gmaxdragon/Seizo-Mini/motor-controller-r4-1/SUBMISSION_FILES.md

# Files for the Week5 design submission

Use the current Seizo-Mini repository and the R4.1 manual-build files. This note is a file guide, not a claim of program approval or completed physical testing.

1. Project link: https://github.com/gmaxdragon/Seizo-Mini. Current design folder: motor-controller-r4-1. Earlier teaching-arm and R4 files remain preserved.
2. Design files: project/big motor controller.kicad_sch and project/big motor controller.kicad_pcb. Preview images: preview/pcb-routing.png and preview/pcb-3d.png (CAD render with incomplete model coverage, not a physical photograph).
3. Parts: cost/Final_BOM.csv contains every purchased/reused/DNP item; rootBOM.csv / cost/HalfLife_import.csv is the24-line funding importer with numeric prices; cost/LCSC_import.csv is the21-line LCSC importer. cost/Budget.csv separately identifies freight/tax/contingency, so do not import those as electronic components.
4. Cart evidence: cart-proof/LCSC-manual-Nov8.jpg, JLC-bare-Nov8.jpg and West3D-three-drivers-Nov8.jpg. The selected JLC item is five bare PCBs; no factory assembly is included. The budget ignores conditional coupons.
5. Manufacturing: use the matching R4.1 Gerbers/drills. Use BUY_AND_SOLDER_MANUAL.md and ASSEMBLY_AND_FIRST_POWER.md for assembly, and the supplied locked firmware/host references for later commissioning.

Report the scope accurately: designed/reviewed but not physically built/tested; 100USD cap allocation including5USDconditionalfallbackmaterials, actual final landed checkout not verified; exact motor/driver/cooling qualification and live application integration remain. The unchanged existing CNC shield is a separate controller and is not a guaranteed NEMA23 fallback.

Use only genuine personal work/time for the program journal. This update does not add or rewrite journal entries, claim agent time as participant time, change a funding form, or submit the project. Current dashboard-specific theme, hour, eligibility and authorship requirements remain governed by the program; they were not verified by this repository update. The public homepage still lists Week5 breadboard logic, while the user reports an updated freestyle option. No eligibility guarantee is made here.

Current cart images are LCSC-current.jpg,JLC-current.jpg,West3D-current.jpg,Adafruit-current.jpg. LCSC42.07 +JLC14.50 +West18.86 +Adafruit0.95 =76.38USDshown; Adafruitfreight/tax and possiblelatechargesareunknown. ImportthecurrentfundingCSVintotheappbeforeusingitsGitHubsync,otherwiseitcanrestorethediscardedteaching-armBOM.
