gmaxdragon/Seizo-Mini/motor-controller-r4-1/cart-proof/Adafruit-current.jpg

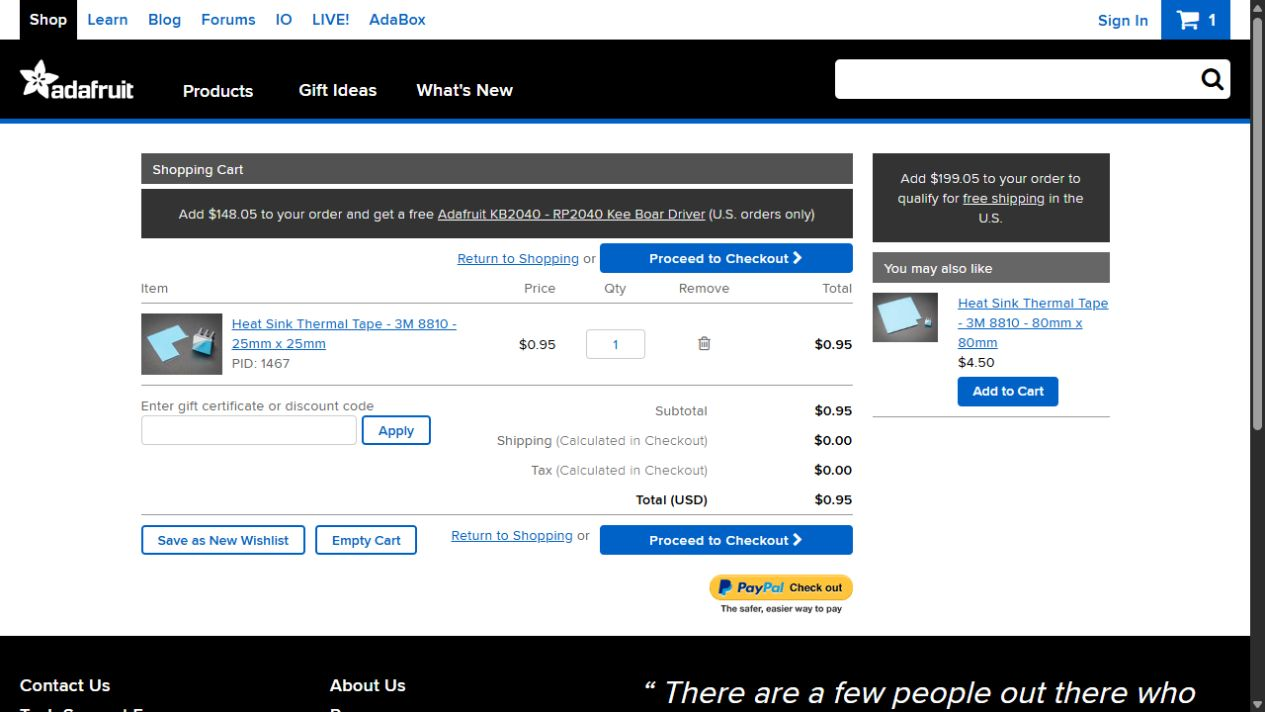
motor-controller-r4-1/cart-proof/Adafruit-current.jpg
