gmaxdragon/Seizo-Mini/motor-controller-r4-1/cart-proof/JLC-bare-Nov8.jpg

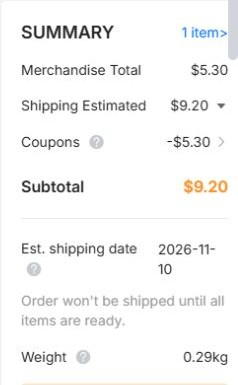
motor-controller-r4-1/cart-proof/JLC-bare-Nov8.jpg
