gmaxdragon/Seizo-Mini/motor-controller-r4-1/cart-proof/JLC-current.jpg

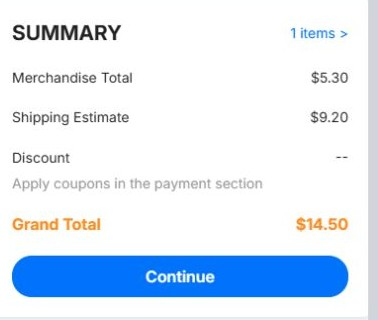
motor-controller-r4-1/cart-proof/JLC-current.jpg
