gmaxdragon/Seizo-Mini/motor-controller-r4-1/cart-proof/LCSC-current.jpg

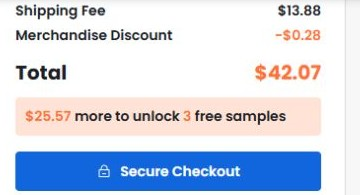
motor-controller-r4-1/cart-proof/LCSC-current.jpg
