gmaxdragon/Seizo-Mini/motor-controller-r4-1/cart-proof/West3D-three-drivers-Nov8.jpg

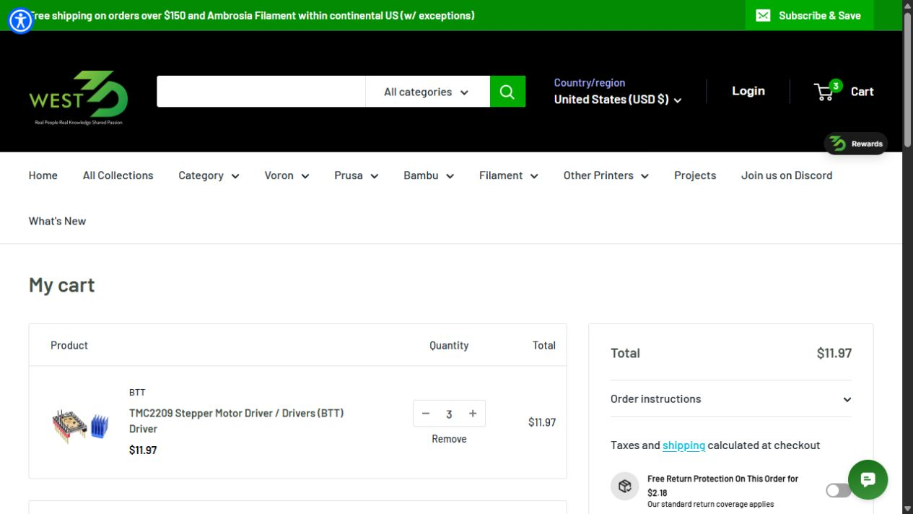
motor-controller-r4-1/cart-proof/West3D-three-drivers-Nov8.jpg
