gmaxdragon/Seizo-Mini/motor-controller-r4/preview/final-board.png

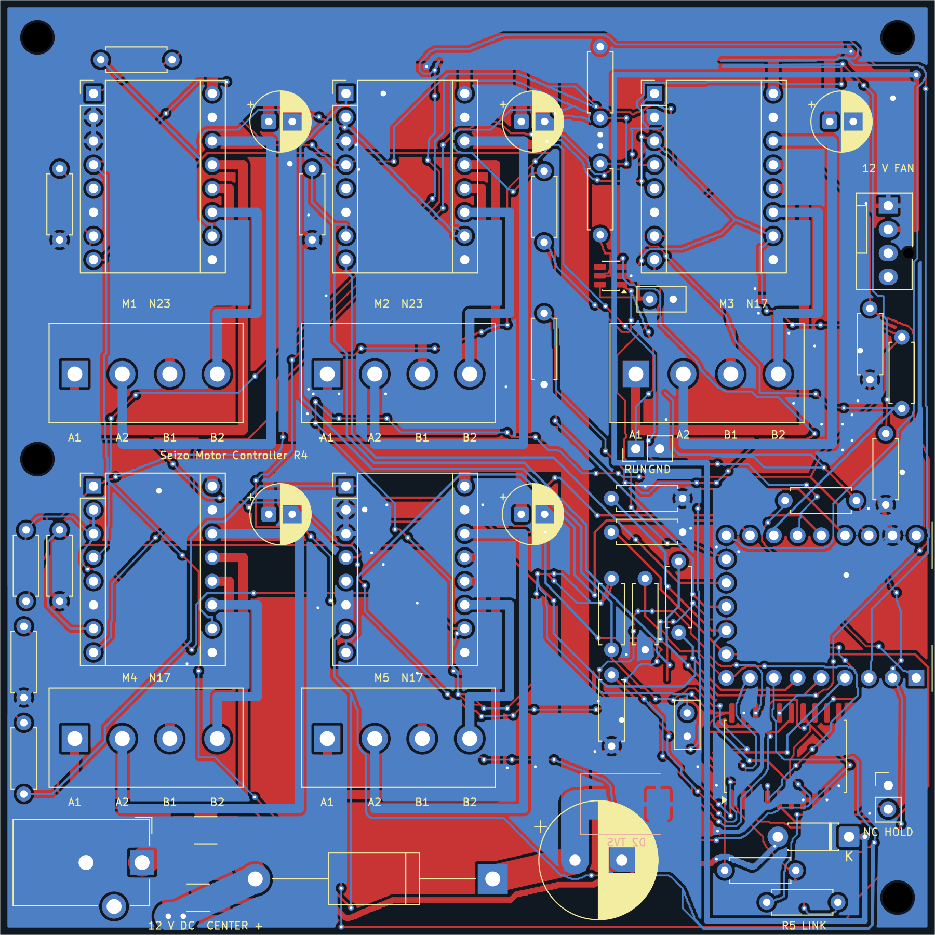
motor-controller-r4/preview/final-board.png
