gmaxdragon/Seizo-Mini/motor-controller-r4-1/cost/factory-alternative/README.md

# Earlier TOP2 factory assembly option

These are superseded costing records for U7/U8-only factory fitting on two carriers. They are not the active manual-build BOM or budget. The earlier $110.21 plan exceeded the target before unquoted imports. Use the parent cost directory for the current manual build. The corrected supplier placement files remain in assembly/quotation-only; their geometry has not been changed.
