gmaxdragon/Seizo-Mini/motor-controller-r4/cost/CHECKOUT_SUMMARY.md

# R4 unpaid website quotes — 2026-11-08

**There is no verified complete, presoldered delivered controller below $100. No order or payment has been made.**

| Supplier / scope | Merchandise | Delivery | Discount | Displayed or planning total | Remaining qualification |
|---|---:|---:|---:|---:|---|
| LCSC, 17 DIY carrier SKUs | $15.59 | $11.85 | $0.24 | **$27.20 checkout** | FCA: duty, customs and tax remain buyer responsibility. Not needed again for parts already supplied by factory assembly. |
| West3D, five plug-in drivers | $19.95 | $6.89 | — | **$26.84 checkout** | Website shows tax $0; exact delivered revision, R110 resistors, five heatsinks and adhesive remain unconfirmed. |
| Waveshare, Zero-M + fan + USB data cable | $8.87 | $10.00 option | — | **$18.87 planning** | Delivery is offered but not selected/final; tax/import fees unbounded. Unrelated $5.49 pre-existing cart item excluded. |
| JLCPCB, five PCBs and two carriers with 56 matched items each | $137.00 | $38.39 cart estimate | $10.00 cart estimate | **$165.39 cart estimate** | Final checkout needs delivery address; coupon, tax and shipping are not final. U6 and R5 are not fitted. |

## What “free assembly” means here

The official offer describes a setup-fee coupon, not free components, manual work, shipping or tax. The actual uploaded R4 double-sided Standard quote is **$10.70 PCB + $126.30 assembly = $137.00 before delivery**. Its assembly charges are setup $51.50, stencil $16.54, components $23.26, feeders $7.75, SMT placement $0.16, hand-solder labor $3.61, manual joints $6.44, fixture $16.54 and packaging $0.50. Account/cart coupons must be checked in final checkout. [Official promotion](https://jlcpcb.com/news/free-assembly-1-6-layer-pcb-discount-8-20-layer-pcba)

The website matched **56 of 58** carrier items to 17 catalogue SKUs. The exact RP2040-Zero-M (U6) and fitted wire link (R5) remain manual/unmatched. Five BTT driver modules are separate plug-in purchases; the ten female sockets are in the factory quote. The reset harness, HOLD loop, fan, heatsinks, USB cable and mounting remain outside fitted scope.

Combining the current factory cart estimate, driver checkout, Waveshare option and $2 heatsink reserve gives **$213.10 before remaining unquoted charges**. This is a planning comparison, not a complete landed quote. It does not also add the LCSC DIY parts basket.

The **DIY** baseline is **$98.84 before unquoted imports** and includes no factory assembly. It uses the earlier bare-board $5.30 + $9.20 freight quote. The full purchase BOM describes that DIY baseline; factory quotation files are separately marked under `assembly/quotation-only`. Do not combine the two purchasing methods or use the bare-board price as a finished-board price.

## Assembly and commissioning status

The digital native, independent copper/geometry and fabrication comparisons pass. U7's five open in-pad vias still need an accepted factory process or a reviewed layout change. The quotation placement file does not certify factory rotation or through-hole insertion alignment. The board has no completed physical power, thermal, motor or fault qualification. It is a prototype, not a production-cleared controller.
