gmaxdragon/Seizo-Mini/motor-controller-r4-1/cost/factory-alternative/QUOTE_RECHECK.md

# Current R4.1 partial-assembly quotation

The current **saved, unpaid R4.1 cart** was checked on November 8, 2026. Only the new R4.1 batch was selected. No personal delivery address was entered or used, no supplier was contacted, and no order, payment or production was authorized.

| Item | USD |
|---|---:|
| Five bare carriers |5.30|
| Economic partial assembly, two boards with U7/U8 only |21.46|
| Merchandise total |26.76|
| Global Standard Direct Line freight |16.03|
| One available conditional coupon |−10.00|
| Current cart subtotal |**32.79**|

The $21.46 assembly charge consists of $8.24 setup, $1.55 stencil, $4.51 components, $6.18 extended-component charges, $0.12 SMT placements and $0.86 nitrogen. The quote matches **U7/C6757** and **U8/C19653**. Its batch contains five PCBs; only two receive these two ICs. It does not include the remaining SMD or through-hole assembly, MCU, socket rows, plug-in drivers, cooling, cable or harness.

The coupon expires November 10, 2026. The cart estimates 0.64 kg and a November 10 ship date; these are website estimates, not delivery guarantees. UPS DDP was an alternative $31.69 freight/$48.45 cart estimate and is **not** the selected baseline. Destination tax/imports, actual coupon availability at payment and final manufacturer CAM/DFM acceptance remain unconfirmed.

The exact corrected CPL SHA256 is `7aaaa30585ed97cb6db1d06aff75d90b855220352bf6094180a1d188fb87ddf9`. Both supplier-library angles are 0°. The quote reviewer re-imported this file from scratch and verified U7's 20 leads/pin 1 bottom-left and U8's 6 leads/pin 1 bottom-right against native pads without further viewer rotations. This validates the saved quotation preview, not physical assembly or factory acceptance.

The complete carrier-component planning total remains **$110.21 before unquoted import or checkout charges**. The $100 cap is not met. Motor purchases and a qualified combined-arm power arrangement are outside this price.
