gmaxdragon/Seizo-Mini/Real_BOM.csv

section | references | quantity_used | purchase_required | purchase_quantity | description | manufacturer | mpn | seller | sku | unit_usd | line_usd | price_status | stock_status | source_url | native_mpns | footprints | notes
Native PCB | U1 U2 U3 | 3 | true | 3 | Three assembled plug-in stepper driver modules | BIGTREETECH | TMC2209 V1.3 | West3D | BTT0529 | 3.99 | 11.97 | Current unpaid checkout:11.97USD merchandise +6.89USD shipping =18.86USD |  | https://west3d.com/products/tmc2209-stepper-motor-driver-drivers-btt | BIGTREETECH TMC2209 V1.3 | SeizoMotorController:StepStick_Socket16_P12.70_D1.00 | Fit three modules for unchanged populated mask7. U1/U2 intended for two suitably rated NEMA23 motors. U3 stays fitted with NO motor for this arm plan. U4/U5 absent. Existing A4988 modules stay on the separate CNC shield for three NEMA17 axes; not pin-compatible substitutes here. Exact delivered revision/R110/shunts and motor-current compatibility require inspection.
Native PCB | U6 | 1 | true | 1 | Genuine bare USB-C RP2040-Zero module; add 23 header pins manually | Waveshare | RP2040-Zero (bare, 20187) | LCSC | C5350143 | 6.01 | 6.01 | Current basket displayed undiscounted line extension; automatic promotion ignored for conservative allocation | Current 21-line unpaid basket: in stock; 2026-11-08 | https://www.lcsc.com/product-detail/C5350143.html | Waveshare RP2040-Zero-M | SeizoMotorController:Waveshare_RP2040_Zero_Headers_9_9_5_P2.54 | Bare module replaces preheadered 20335 Zero-M. Fit 23 straight male pins in 9+9+5 rows, then solder through carrier. Same reviewed Zero signal map. Required J9 RUN/GND service harness remains. Native CAD metadata may still say Zero-M; geometry/electrical map is unchanged.
Native PCB | U7 | 1 | true | 1 | Octal STEP buffer / HOLD output enable, wide SOIC20 | Texas Instruments | SN74HC541DWR | LCSC | C6757 | 1.1224 | 1.12 | Current basket displayed undiscounted line extension; automatic promotion ignored for conservative allocation | Current 21-line unpaid basket: in stock; 2026-11-08 | https://www.lcsc.com/product-detail/C6757.html | SN74HC541DWR | Package_SO:SOIC-20W_7.5x12.8mm_P1.27mm | Fit manually; no factory assembly in this budget. Match pin 1 and inspect every lead for bridges. R4.1 has no in-pad escape vias requiring the old R4 manual via-fill instruction. One purchased chip is fitted, not a loose spare.
Native PCB | U8 | 1 | true | 1 | Motor-rail reset supervisor, SOT23-6 | Texas Instruments | TPS3808G01DBVR | LCSC | C19653 | 0.4628 | 0.46 | Current basket displayed undiscounted line extension; automatic promotion ignored for conservative allocation | Current 21-line unpaid basket: in stock; 2026-11-08 | https://www.lcsc.com/product-detail/C19653.html | TPS3808G01DBVR | Package_TO_SOT_SMD:SOT-23-6 | Fit manually; no factory assembly in this budget. Match pin 1 and inspect every lead for bridges. R4.1 has no in-pad escape vias requiring the old R4 manual via-fill instruction. One purchased chip is fitted, not a loose spare.
Native PCB | R11 R12 R13 R14 R15 R6 R7 R9 R21 R31 R22 R32 R23 R33 R24 R34 R25 R35 | 18 | true | 50 | 10k1%0.25W100ppm axial resistors | YAGEO | MFR-25FBF52-10K | LCSC | C1519255 | 0.0198 | 0.99 | Current basket displayed undiscounted line extension; automatic promotion ignored for conservative allocation | Current 21-line unpaid basket: in stock; 2026-11-08 | https://www.lcsc.com/product-detail/C1519255.html | MFR-25FBF52-10K | Resistor_THT:R_Axial_DIN0207_L6.3mm_D2.5mm_P7.62mm_Horizontal | 18fitted,32spares; includes newR6,R7,R9. Body6.3×2.4mm formed to7.62mmpitch. Cart line_usd is authoritative displayed cents; unit_usd is separately displayed four-decimal precision. Current automatic0.28USD promotion is ignored for conservative allocation.
Native PCB | R2 R3 R4 R8 | 4 | true | 50 | 1k1%0.25W50ppm axial resistors | YAGEO | MFR-25FTE52-1K | LCSC | C172978 | 0.0152 | 0.76 | Current basket displayed undiscounted line extension; automatic promotion ignored for conservative allocation | Current 21-line unpaid basket: in stock; 2026-11-08 | https://www.lcsc.com/product-detail/C172978.html | MFR-25FTE52-1K | Resistor_THT:R_Axial_DIN0207_L6.3mm_D2.5mm_P7.62mm_Horizontal | 4fitted,46spares; includes newR8. Body6.3×2.4mm formed to7.62mmpitch. Cart line_usd is authoritative displayed cents; unit_usd is separately displayed four-decimal precision. Current automatic0.28USD promotion is ignored for conservative allocation.
Native PCB assembly link | R5 | 1 | false | 0 | Fitted wire link from clipped resistor lead | Assembly material | Assembly link - tinned resistor-lead offcut | Already purchased resistor pack | No separate purchase | 0 | 0 | Required assembly link,no separate purchase |  |  | Assembly link - tinned resistor-lead offcut | Resistor_THT:R_Axial_DIN0207_L6.3mm_D2.5mm_P7.62mm_Horizontal | Form acrossR5holes7.62mmpitch with clearance. KeepR4=1k; do not fit1k atR5.
Native PCB | C2 C3 | 2 | true | 5 | 100nF50VX7R10% radial bypass capacitors | Murata | RDER71H104K0S1H03A | LCSC | C524651 | 0.0966 | 0.48 | Current basket displayed undiscounted line extension; automatic promotion ignored for conservative allocation | Current 21-line unpaid basket: in stock; 2026-11-08 | https://www.lcsc.com/product-detail/C524651.html | RDER71H104K0S1H03A | Capacitor_THT:C_Disc_D5.0mm_W2.5mm_P2.50mm | 2fitted,3spares. Includes newC3. Body5×2.5mm/P2.5. Cart line_usd is authoritative displayed cents; unit_usd is separately displayed four-decimal precision. Current automatic0.28USD promotion is ignored for conservative allocation.
Native PCB | C11 C12 C13 C14 C15 | 5 | true | 10 | 100uF35V low-impedance radial capacitors | Rubycon | 35ZLH100MEFC6.3X11 | LCSC | C109392 | 0.0681 | 0.68 | Current basket displayed undiscounted line extension; automatic promotion ignored for conservative allocation | Current 21-line unpaid basket: in stock; 2026-11-08 | https://www.lcsc.com/product-detail/C109392.html | 35ZLH100MEFC6.3X11 | Capacitor_THT:CP_Radial_D6.3mm_P2.50mm | 5fitted,5spares. Body6.3×11mm/P2.5;540mA100kHzripple;6000h105C. Cart line_usd is authoritative displayed cents; unit_usd is separately displayed four-decimal precision. Current automatic0.28USD promotion is ignored for conservative allocation.
Native PCB | C1 | 1 | true | 1 | 470uF50V radial bulk capacitor | Panasonic | EEU-FR1H471 | LCSC | C178708 | 0.8139 | 0.81 | Current basket displayed undiscounted line extension; automatic promotion ignored for conservative allocation | Current 21-line unpaid basket: in stock; 2026-11-08 | https://www.lcsc.com/product-detail/C178708.html | EEU-FR1H471 | Capacitor_THT:CP_Radial_D12.5mm_P5.00mm | 12.5mmdiameter/P5. Cart line_usd is authoritative displayed cents; unit_usd is separately displayed four-decimal precision. Current automatic0.28USD promotion is ignored for conservative allocation.
Native PCB | J1 J2 J3 J4 J5 | 5 | true | 5 | Four-position5.08mm motor screw terminals | DORABO | DB128V-5.08-4P-GN-S | LCSC | C2915641 | 0.4256 | 2.13 | Current basket displayed undiscounted line extension; automatic promotion ignored for conservative allocation | Current 21-line unpaid basket: in stock; 2026-11-08 | https://www.lcsc.com/product-detail/C2915641.html | DB128V-5.08-4P-GN-S | SeizoMotorController:TerminalBlock_DORABO_DB128V_1x04_P5.08mm_D1.60 | Native custom reviewed1.60mmdrill footprint; verify physical fit. Undiscounted quoted2.13USDline used. Cart line_usd is authoritative displayed cents; unit_usd is separately displayed four-decimal precision. Current automatic0.28USD promotion is ignored for conservative allocation.
Native PCB | J6 | 1 | true | 1 | 5A24V barrel jack,2.0mm center pin | Same Sky | PJ-102AH | LCSC | C3096093 | 1.0637 | 1.06 | Current basket displayed undiscounted line extension; automatic promotion ignored for conservative allocation | Current 21-line unpaid basket: in stock; 2026-11-08 | https://www.lcsc.com/product-detail/C3096093.html | PJ-102AH | Connector_BarrelJack:BarrelJack_CUI_PJ-102AH_Horizontal | Mates nominal5.5OD/2.1IDplug; owned adapter plug/polarity must be checked. Cart line_usd is authoritative displayed cents; unit_usd is separately displayed four-decimal precision. Current automatic0.28USD promotion is ignored for conservative allocation.
Native PCB | J7 J9 | 2 | true | 20 | Two-pin2.54mm vertical male headers | Ckmtw | B-2100S02P-A110 | LCSC | C124375 | 0.0281 | 0.56 | Current basket displayed undiscounted line extension; automatic promotion ignored for conservative allocation | Current 21-line unpaid basket: in stock; 2026-11-08 | https://www.lcsc.com/product-detail/C124375.html | B-2100S02P-A110 | Connector_PinHeader_2.54mm:PinHeader_1x02_P2.54mm_Vertical | 2fitted,18spares. J7HOLDdryNCcontact; newJ9requiredRUN/GNDharness. Square0.64mmpins,6mmmating/3mmtail. Cart line_usd is authoritative displayed cents; unit_usd is separately displayed four-decimal precision. Current automatic0.28USD promotion is ignored for conservative allocation.
Unpopulated footprint | J8 | 0 | false | 0 | Keyed four-pin2.54mm PC fan header | Molex | 470531000 | LCSC | C240840 | 0.00 | 0.00 | Current basket displayed undiscounted line extension; automatic promotion ignored for conservative allocation | Current 21-line unpaid basket: in stock; 2026-11-08 | https://www.lcsc.com/product-detail/C240840.html | 470531000 | Connector:FanPinHeader_1x04_P2.54mm_Vertical | Do not buy C240840 for this build. Leave plastic header unpopulated. Solder blower black lead to J8 pad1/GND and red lead to pad2/FAN_VMOT, leaving pads3/4 unused. Retain F2/D3. Provide independent printed strain relief and insulated underside clearance.
Native PCB | F1 | 1 | true | 5 | 4A125VDC time-delay main fuse,2410 | Littelfuse | 0454004.MR | LCSC | C179006 | 0.2902 | 1.45 | Current basket displayed undiscounted line extension; automatic promotion ignored for conservative allocation | Current 21-line unpaid basket: in stock; 2026-11-08 | https://www.lcsc.com/product-detail/C179006.html | 0454004.MR | Fuse:Fuse_Littelfuse-NANO2-451_453 | 1fitted,4spares. Soldered fuse,no holder. Fuse rating does not establish a2.5Acontinuous board qualification. Cart line_usd is authoritative displayed cents; unit_usd is separately displayed four-decimal precision. Current automatic0.28USD promotion is ignored for conservative allocation.
Native PCB | F2 | 1 | true | 5 | 0.5A125VDC time-delay fan branch fuse,2410 | Littelfuse | 0454.500MR | LCSC | C179003 | 0.2094 | 1.05 | Current basket displayed undiscounted line extension; automatic promotion ignored for conservative allocation | Current 21-line unpaid basket: in stock; 2026-11-08 | https://www.lcsc.com/product-detail/C179003.html | 0454.500MR | Fuse:Fuse_Littelfuse-NANO2-451_453 | 1fitted,4spares. Thin fan-lead branch protection; inrush/ambientderating require test. Cart line_usd is authoritative displayed cents; unit_usd is separately displayed four-decimal precision. Current automatic0.28USD promotion is ignored for conservative allocation.
Native PCB | D2 | 1 | true | 1 | 15V1500W transient suppressor,SMC | Bourns | SMCJ15A | LCSC | C3719503 | 0.6821 | 0.68 | Current basket displayed undiscounted line extension; automatic promotion ignored for conservative allocation | Current 21-line unpaid basket: in stock; 2026-11-08 | https://www.lcsc.com/product-detail/C3719503.html | SMCJ15A | Diode_SMD:D_SMC | 24.4Vclamp at specified61.5Apulse is not a continuous braking-energy rating or proof each module stays below29V. Cart line_usd is authoritative displayed cents; unit_usd is separately displayed four-decimal precision. Current automatic0.28USD promotion is ignored for conservative allocation.
Native PCB | D1 | 1 | true | 1 | 5A60V axial Schottky motor-input isolation diode | Vishay | SB560-E3/54 | LCSC | C506560 | 0.5418 | 0.54 | Current basket displayed undiscounted line extension; automatic promotion ignored for conservative allocation | Current 21-line unpaid basket: in stock; 2026-11-08 | https://www.lcsc.com/product-detail/C506560.html | SB560-E3/54 | SeizoMotorController:D_DO-201AD_P25.40mm_Horizontal_D1.60 | DO201AD,1.60mmdrill/25.4mmformedpitch. Thermal loss/leadconditions/airflow require physical validation. Initial total-input qualification envelope≤2.5A, not certified continuous rating. Cart line_usd is authoritative displayed cents; unit_usd is separately displayed four-decimal precision. Current automatic0.28USD promotion is ignored for conservative allocation.
Native PCB | D3 | 1 | true | 5 | 1A40V axial Schottky fan isolation diode | Vishay | 1N5819-E3/54 | LCSC | C145202 | 0.1434 | 0.72 | Current basket displayed undiscounted line extension; automatic promotion ignored for conservative allocation | Current 21-line unpaid basket: in stock; 2026-11-08 | https://www.lcsc.com/product-detail/C145202.html | 1N5819-E3/54 | Diode_THT:D_DO-41_SOD81_P7.62mm_Horizontal | Fan branch before mainD1, throughF2andD3.1fitted,4spares. Cart line_usd is authoritative displayed cents; unit_usd is separately displayed four-decimal precision. Current automatic0.28USD promotion is ignored for conservative allocation.
Assembly accessory / external |  | 10 | true | 10 | Ten female8-position driver sockets | BOOMELE | 2.54-1*8P | LCSC | C27438 | 0.1193 | 1.19 | Current basket displayed undiscounted line extension; automatic promotion ignored for conservative allocation | Current 21-line unpaid basket: in stock; 2026-11-08 | https://www.lcsc.com/product-detail/C27438.html |  |  | Two socket rows per each of five modules, additional physical parts beyond five logical module footprints. Validate actual contact heating. Cart line_usd is authoritative displayed cents; unit_usd is separately displayed four-decimal precision. Current automatic0.28USD promotion is ignored for conservative allocation.
Assembly accessory / external |  | 1 | true | 1 | Two-wire 12V centrifugal blower; different mounting from 40mm fan | SUNON | MF50151VX-1B00C-A99 | LCSC | C49308057 | 3.1746 | 3.17 | Current basket displayed undiscounted line extension; automatic promotion ignored for conservative allocation | Current 21-line unpaid basket: in stock; 2026-11-08 | https://www.lcsc.com/product-detail/C49308057.html |  |  | 51.7x51.6x15mm nominal; two 4.5mm mounting holes; needs new printed bracket/duct. Red positive to J8.2, black negative to J8.1; no fan header fitted. 12V rated, 4.5-13.8V operating, 0.155A average/0.179A max, 26AWG leads. Continuous DC: do not PWM power/ground. F2/D3 retained. Startup/fault/thermal performance requires physical tests. No included screw pack assumed.
Assembly accessory / external |  | 1 | true | 1 | USB-A male to USB-C male 1m data cable | Ckmtw | S100920007 | LCSC | C430908 | 3.2389 | 3.24 | Current basket displayed undiscounted line extension; automatic promotion ignored for conservative allocation | Current 21-line unpaid basket: in stock; 2026-11-08 | https://www.lcsc.com/product-detail/C430908.html |  |  | Manufacturer drawing confirms four conductors, D+/D-, USB-A male and Type-C male with 56k plug resistor. Pi data/control connection only; motor power uses owned adapter. Do not substitute two-core charging cable.
Assembly accessory / external |  | 2 | false | 0 | Two short insulated internal RUN/GND harness wires | USER OWNED | Owned jumper wire sections | Already owned | No purchase | 0 | 0 | Reuse user-owned jumper wires |  |  |  |  | Required internal service harness: J9.1→actualZeroKey2.1RUN, J9.2→Key2.2GND. Identify manufacturer nets and unpowered continuity, not visual left/right. No invented edgeRUNpin. Tools separate.
Assembly accessory / external |  | 1 | false | 0 | HOLD bench link from owned jumper wire | USER OWNED | Owned insulated jumper wire loop | Already owned | No purchase | 0 | 0 | Reuse owned jumper wire; no separate shunt purchase |  |  |  |  | Required between J7.1 and J7.2 for bench operation when no external dryNCcontact is fitted. Use a female-to-female jumper or an insulated soldered loop. No external voltage. Not an emergency-stop button.
Assembly accessory / external |  | 1 | true | 1 | One batch of five bare R4.1 carrier boards; no factory fitting | JLCPCB | R4.1 bare PCB batch | JLCPCB | Bare-board prototype quote | 5.30 | 5.30 | Current unpaid checkout:5.30USD merchandise +9.20USD freight =14.50USD, no coupon assumed | Current bare fabrication quotation saved; manufacturer CAM/DFM acceptance remains pending | https://jlcpcb.com/ |  |  | Five bare R4.1 boards; no assembly/stencil. Current checkout grand total14.50USD. Destination duties/tax/handling are explicitly excluded by the selected shipping terms. No payment or order placed.
Assembly accessory / external |  | 1 | false | 0 | Owned12V4Aadapter reused | USER OWNED | Exact label and plug to verify | Already owned | No purchase | 0 | 0 | Explicit user-approved reuse |  |  |  |  | Initial total-input qualification envelope≤2.5A/30Wshared across five slots, not a protective current clamp or certified continuous rating. Adapterpolarity,plugfit,regulation and totalbudget must be measured.
Assembly accessory / external |  | 1 | false | 0 | Insulated printed mounting base using owned material | USER OWNED | Printed insulated mount | Already owned | No purchase | 0 | 0 | Explicit reused printing material |  |  |  |  | No new fastenerpack charged. Actualretention/clearances required; new mounting hardware needs repricing.
Future; not purchased | U4 U5 | 0 | false | 0 | Two unpopulated future driver slots | BIGTREETECH | TMC2209 V1.3 | Not in current purchase |  | 0.00 | 0.00 | Not purchased; excluded from this build budget |  |  |  |  | Both native StepStick footprints retain two female header rows each. No driver module is fitted in U4/U5. Firmware forces their outputs inactive.
Assembly accessory / external | U6 header rows | 23 | true | 5 | Five 40-position straight male header strips; one provides MCU rows 9+9+5 | ZHOURI | 2.54-1*40 | LCSC | C2977586 | 0.1736 | 0.87 | Current basket displayed undiscounted line extension; automatic promotion ignored for conservative allocation | Current 21-line unpaid basket: in stock; 2026-11-08 | https://www.lcsc.com/product-detail/C2977586.html |  |  | Buy quantity is FIVE complete 40-pin strips due to MOQ. Use 23 pins (9+9+5) from one strip; 177 pins remain spare. Straight 2.54mm pitch, square pins, 2.54mm plastic height, 6mm mating length, 3mm tails. Short tails through MCU, long pins toward carrier. Keep rows aligned; fit before carrier soldering. Contact rating is not system current rating.
External cooling | U1 U2 U3 heatsinks | 3 | true | 5 | Five 8.8x8.8x5mm small heatsinks; three fitted, two spare | wenhaoyongshun | F12-04-05 | LCSC | C5250879 | 0.1001 | 0.50 | Current unpaid cart:qty5 displayed0.50USD | In stock in current cart | https://www.lcsc.com/product-detail/C5250879.html |  |  | Use with separately purchased thermal adhesive, not bare metal contact. Nominal width8.8mm versus12.7mm socket-row spacing is not a real component-clearance or thermal qualification. Center on the appropriate module IC body only; keep all metal clear of pads/leads and inspect delivered parts. Do not rely on anodizing as insulation. Forced-air and thermal tests required; no arbitrary2A operating rating claimed.
Reused CNC hardware | Existing three NEMA17 axes | 3 | false | 0 | Owned Uno/CNC shield and four owned A4988 driver modules | USER OWNED | Actual driver markings to verify | Already owned | No new purchase | 0.00 | 0.00 | Explicit user-owned reuse; not a supplier quote |  |  |  |  | Three independently controlled NEMA17 axes assumed on existing Uno/GRBL; fourth socket is not automatically independent. A4988s do not plug into R4.1 TMC sockets. CNC remains separately powered/connected unless a rated combined distribution is qualified.
Conditional fallback; owned | Two NEMA23 fallback axes | 2 | false | 0 | Two owned enclosed generic9-42V microstep drivers | USER OWNED; actual brand unknown | Unidentified MicrostepDriver | Already owned | No new purchase | 0.00 | 0.00 | User-owned equipment only; not verified replacement specifications |  |  |  |  | Conditional independent-carrier fallback only, NOT a plug-in replacement. Requires verified5V input/current/timing/enable behavior, suitable motor-current settings, an independent fused power harness and tested Uno signal interface. Adaptation-material allowance5USD is separate and not a complete supplier quote. Does not provide more than48W from owned adapter or certify holding torque.
