gmaxdragon/Seizo-Mini/hardware/BOARD-BOM.csv

Reference | Quantity | Value | SuggestedExactPart | StockKiCadFootprint | ProcurementNote
C1 | 1 | 100n | FG18X7R1H104KNT06 | Capacitor_THT:C_Rect_L4.0mm_W2.5mm_P2.50mm | TDK 100nF 50V X7R; maximum 4x2.5mm body, 2.5mm pitch; 5.5mm body height
C10 | 1 | 100n | FG18X7R1H104KNT06 | Capacitor_THT:C_Rect_L4.0mm_W2.5mm_P2.50mm | TDK 100nF 50V X7R; maximum 4x2.5mm body, 2.5mm pitch; 5.5mm body height
C12 | 1 | 100n | FG18X7R1H104KNT06 | Capacitor_THT:C_Rect_L4.0mm_W2.5mm_P2.50mm | TDK 100nF 50V X7R; maximum 4x2.5mm body, 2.5mm pitch; 5.5mm body height
C2 | 1 | 100n | FG18X7R1H104KNT06 | Capacitor_THT:C_Rect_L4.0mm_W2.5mm_P2.50mm | TDK 100nF 50V X7R; maximum 4x2.5mm body, 2.5mm pitch; 5.5mm body height
C3 | 1 | 100n | FG18X7R1H104KNT06 | Capacitor_THT:C_Rect_L4.0mm_W2.5mm_P2.50mm | TDK 100nF 50V X7R; maximum 4x2.5mm body, 2.5mm pitch; 5.5mm body height
C4 | 1 | 100n | FG18X7R1H104KNT06 | Capacitor_THT:C_Rect_L4.0mm_W2.5mm_P2.50mm | TDK 100nF 50V X7R; maximum 4x2.5mm body, 2.5mm pitch; 5.5mm body height
C5 | 1 | 100n | FG18X7R1H104KNT06 | Capacitor_THT:C_Rect_L4.0mm_W2.5mm_P2.50mm | TDK 100nF 50V X7R; maximum 4x2.5mm body, 2.5mm pitch; 5.5mm body height
C6 | 1 | 10u / >=6.3V | ESK106M050AC3AA | Capacitor_THT:CP_Radial_D5.0mm_P2.00mm | KEMET 10uF 50V; 5mm diameter, 2mm pitch; allow 12.5mm vertical clearance
C7 | 1 | 100n | FG18X7R1H104KNT06 | Capacitor_THT:C_Rect_L4.0mm_W2.5mm_P2.50mm | TDK 100nF 50V X7R; maximum 4x2.5mm body, 2.5mm pitch; 5.5mm body height
C8 | 1 | 100n | FG18X7R1H104KNT06 | Capacitor_THT:C_Rect_L4.0mm_W2.5mm_P2.50mm | TDK 100nF 50V X7R; maximum 4x2.5mm body, 2.5mm pitch; 5.5mm body height
C9 | 1 | 100n | FG18X7R1H104KNT06 | Capacitor_THT:C_Rect_L4.0mm_W2.5mm_P2.50mm | TDK 100nF 50V X7R; maximum 4x2.5mm body, 2.5mm pitch; 5.5mm body height
D1 | 1 | GREEN / POWER | WP710A10GD | LED_THT:LED_D3.0mm | Kingbright green 3mm LED, 2.54mm pitch; stock 3D model color is illustrative
J1 | 1 | S3-ZERO LEFT | PPTC091LFBN-RC | Connector_PinSocket_2.54mm:PinSocket_1x09_P2.54mm_Vertical | Vertical female 1x9, 2.54mm pitch; two rows 15.24mm apart; source exact socket body/height
J10 | 1 | UPSTREAM I2C 3V3 | PRPC040SAAN-RC (cut to pin count) | Connector_PinHeader_2.54mm:PinHeader_1x04_P2.54mm_Vertical | Vertical male 2.54mm header; use the exact pin count in the footprint; no right-angle substitute; sourced from grouped40pin strips, not one full strip per connector
J11 | 1 | MAIN ARM POT | PRPC040SAAN-RC (cut to pin count) | Connector_PinHeader_2.54mm:PinHeader_1x03_P2.54mm_Vertical | Vertical male 2.54mm header; use the exact pin count in the footprint; no right-angle substitute; sourced from grouped40pin strips, not one full strip per connector
J12 | 1 | 2717 CHANNEL-SIDE SOCKET | PPTC121LFBN-RC | Connector_PinSocket_2.54mm:PinSocket_1x12_P2.54mm_Vertical | Vertical female 1x12, 2.54mm pitch; Adafruit2717 module pair on 15.24mm row centers; see module-interface.json for orientation
J2 | 1 | S3-ZERO RIGHT | PPTC091LFBN-RC | Connector_PinSocket_2.54mm:PinSocket_1x09_P2.54mm_Vertical | Vertical female 1x9, 2.54mm pitch; two rows 15.24mm apart; source exact socket body/height
J3 | 1 | FRONT ARM POT | PRPC040SAAN-RC (cut to pin count) | Connector_PinHeader_2.54mm:PinHeader_1x03_P2.54mm_Vertical | Vertical male 2.54mm header; use the exact pin count in the footprint; no right-angle substitute; sourced from grouped40pin strips, not one full strip per connector
J4 | 1 | ROT POT | PRPC040SAAN-RC (cut to pin count) | Connector_PinHeader_2.54mm:PinHeader_1x03_P2.54mm_Vertical | Vertical male 2.54mm header; use the exact pin count in the footprint; no right-angle substitute; sourced from grouped40pin strips, not one full strip per connector
J5 | 1 | OPEN/CLOSE POT | PRPC040SAAN-RC (cut to pin count) | Connector_PinHeader_2.54mm:PinHeader_1x03_P2.54mm_Vertical | Vertical male 2.54mm header; use the exact pin count in the footprint; no right-angle substitute; sourced from grouped40pin strips, not one full strip per connector
J6 | 1 | 2717 VIN-SIDE SOCKET | PPTC121LFBN-RC | Connector_PinSocket_2.54mm:PinSocket_1x12_P2.54mm_Vertical | Vertical female 1x12, 2.54mm pitch; Adafruit2717 module pair on 15.24mm row centers; see module-interface.json for orientation
J7 | 1 | BASE AS5600 SENSOR | PRPC040SAAN-RC (cut to pin count) | Connector_PinHeader_2.54mm:PinHeader_1x04_P2.54mm_Vertical | Vertical male 2.54mm header; use the exact pin count in the footprint; no right-angle substitute; sourced from grouped40pin strips, not one full strip per connector
J8 | 1 | MAIN AS5600 SENSOR | PRPC040SAAN-RC (cut to pin count) | Connector_PinHeader_2.54mm:PinHeader_1x04_P2.54mm_Vertical | Vertical male 2.54mm header; use the exact pin count in the footprint; no right-angle substitute; sourced from grouped40pin strips, not one full strip per connector
J9 | 1 | FRONT AS5600 SENSOR | PRPC040SAAN-RC (cut to pin count) | Connector_PinHeader_2.54mm:PinHeader_1x04_P2.54mm_Vertical | Vertical male 2.54mm header; use the exact pin count in the footprint; no right-angle substitute; sourced from grouped40pin strips, not one full strip per connector
R1 | 1 | 100k | MFR-25FBF52-100K | Resistor_THT:R_Axial_DIN0207_L6.3mm_D2.5mm_P7.62mm_Horizontal | Yageo 1% 0.25W axial; bend straight leads to 7.62mm; equivalent only if verified to footprint
R10 | 1 | 200k | MFR-25FBF52-200K | Resistor_THT:R_Axial_DIN0207_L6.3mm_D2.5mm_P7.62mm_Horizontal | Yageo 1% 0.25W axial; bend straight leads to 7.62mm; equivalent only if verified to footprint
R11 | 1 | 10k | MFR-25FBF52-10K | Resistor_THT:R_Axial_DIN0207_L6.3mm_D2.5mm_P7.62mm_Horizontal | Yageo 1% 0.25W axial; bend straight leads to 7.62mm; equivalent only if verified to footprint
R12 | 1 | 10k | MFR-25FBF52-10K | Resistor_THT:R_Axial_DIN0207_L6.3mm_D2.5mm_P7.62mm_Horizontal | Yageo 1% 0.25W axial; bend straight leads to 7.62mm; equivalent only if verified to footprint
R13 | 1 | 4k7 | MFR-25FTF52-4K7 | Resistor_THT:R_Axial_DIN0207_L6.3mm_D2.5mm_P7.62mm_Horizontal | Yageo 1% 0.25W axial; bend straight leads to 7.62mm; equivalent only if verified to footprint
R14 | 1 | 4k7 | MFR-25FTF52-4K7 | Resistor_THT:R_Axial_DIN0207_L6.3mm_D2.5mm_P7.62mm_Horizontal | Yageo 1% 0.25W axial; bend straight leads to 7.62mm; equivalent only if verified to footprint
R15 | 1 | 10k | MFR-25FBF52-10K | Resistor_THT:R_Axial_DIN0207_L6.3mm_D2.5mm_P7.62mm_Horizontal | Yageo 1% 0.25W axial; bend straight leads to 7.62mm; equivalent only if verified to footprint
R16 | 1 | 1k | MFR-25FBF52-1K | Resistor_THT:R_Axial_DIN0207_L6.3mm_D2.5mm_P7.62mm_Horizontal | Yageo 1% 0.25W axial; bend straight leads to 7.62mm; equivalent only if verified to footprint
R19 | 1 | 100 / 0.25W | MFR-25FBF52-100R | Resistor_THT:R_Axial_DIN0207_L6.3mm_D2.5mm_P7.62mm_Horizontal | Yageo 1% 0.25W axial; bend straight leads to 7.62mm; equivalent only if verified to footprint
R2 | 1 | 200k | MFR-25FBF52-200K | Resistor_THT:R_Axial_DIN0207_L6.3mm_D2.5mm_P7.62mm_Horizontal | Yageo 1% 0.25W axial; bend straight leads to 7.62mm; equivalent only if verified to footprint
R20 | 1 | 100 / 0.25W | MFR-25FBF52-100R | Resistor_THT:R_Axial_DIN0207_L6.3mm_D2.5mm_P7.62mm_Horizontal | Yageo 1% 0.25W axial; bend straight leads to 7.62mm; equivalent only if verified to footprint
R21 | 1 | 100 / 0.25W | MFR-25FBF52-100R | Resistor_THT:R_Axial_DIN0207_L6.3mm_D2.5mm_P7.62mm_Horizontal | Yageo 1% 0.25W axial; bend straight leads to 7.62mm; equivalent only if verified to footprint
R22 | 1 | 100 / 0.25W | MFR-25FBF52-100R | Resistor_THT:R_Axial_DIN0207_L6.3mm_D2.5mm_P7.62mm_Horizontal | Yageo 1% 0.25W axial; bend straight leads to 7.62mm; equivalent only if verified to footprint
R24 | 1 | 1k | MFR-25FBF52-1K | Resistor_THT:R_Axial_DIN0207_L6.3mm_D2.5mm_P7.62mm_Horizontal | Yageo 1% 0.25W axial; bend straight leads to 7.62mm; equivalent only if verified to footprint
R25 | 1 | 10k | MFR-25FBF52-10K | Resistor_THT:R_Axial_DIN0207_L6.3mm_D2.5mm_P7.62mm_Horizontal | Yageo 1% 0.25W axial; bend straight leads to 7.62mm; equivalent only if verified to footprint
R3 | 1 | 100k | MFR-25FBF52-100K | Resistor_THT:R_Axial_DIN0207_L6.3mm_D2.5mm_P7.62mm_Horizontal | Yageo 1% 0.25W axial; bend straight leads to 7.62mm; equivalent only if verified to footprint
R4 | 1 | 200k | MFR-25FBF52-200K | Resistor_THT:R_Axial_DIN0207_L6.3mm_D2.5mm_P7.62mm_Horizontal | Yageo 1% 0.25W axial; bend straight leads to 7.62mm; equivalent only if verified to footprint
R5 | 1 | 100k | MFR-25FBF52-100K | Resistor_THT:R_Axial_DIN0207_L6.3mm_D2.5mm_P7.62mm_Horizontal | Yageo 1% 0.25W axial; bend straight leads to 7.62mm; equivalent only if verified to footprint
R6 | 1 | 200k | MFR-25FBF52-200K | Resistor_THT:R_Axial_DIN0207_L6.3mm_D2.5mm_P7.62mm_Horizontal | Yageo 1% 0.25W axial; bend straight leads to 7.62mm; equivalent only if verified to footprint
R7 | 1 | 100k | MFR-25FBF52-100K | Resistor_THT:R_Axial_DIN0207_L6.3mm_D2.5mm_P7.62mm_Horizontal | Yageo 1% 0.25W axial; bend straight leads to 7.62mm; equivalent only if verified to footprint
R8 | 1 | 200k | MFR-25FBF52-200K | Resistor_THT:R_Axial_DIN0207_L6.3mm_D2.5mm_P7.62mm_Horizontal | Yageo 1% 0.25W axial; bend straight leads to 7.62mm; equivalent only if verified to footprint
R9 | 1 | 100k | MFR-25FBF52-100K | Resistor_THT:R_Axial_DIN0207_L6.3mm_D2.5mm_P7.62mm_Horizontal | Yageo 1% 0.25W axial; bend straight leads to 7.62mm; equivalent only if verified to footprint
RV1 | 1 | 20k BASE | PTV09A-1020F-B203 | Potentiometer_THT:Potentiometer_Bourns_PTV09A-1_Single_Vertical | Bourns 20k linear; only board-mounted pot; shaft points up; no structural load
SW1 | 1 | START | B3F-1000 | Button_Switch_THT:SW_TH_Tactile_Omron_B3F-100x | Omron 6mm tactile; 6.5x4.5mm contact pitch, stock KiCad B3F-100x
SW2 | 1 | FINISH | B3F-1000 | Button_Switch_THT:SW_TH_Tactile_Omron_B3F-100x | Omron 6mm tactile; 6.5x4.5mm contact pitch, stock KiCad B3F-100x
SW3 | 1 | REPLAY | B3F-1000 | Button_Switch_THT:SW_TH_Tactile_Omron_B3F-100x | Omron 6mm tactile; 6.5x4.5mm contact pitch, stock KiCad B3F-100x
TP1 | 1 | ADC_BASE |  | TestPoint:TestPoint_THTPad_D1.5mm_Drill0.7mm | Bare plated test pad; included in PCB fabrication; do not buy a component
TP2 | 1 | ADC_MAIN |  | TestPoint:TestPoint_THTPad_D1.5mm_Drill0.7mm | Bare plated test pad; included in PCB fabrication; do not buy a component
TP3 | 1 | ADC_FRONT |  | TestPoint:TestPoint_THTPad_D1.5mm_Drill0.7mm | Bare plated test pad; included in PCB fabrication; do not buy a component
TP4 | 1 | ADC_ROT |  | TestPoint:TestPoint_THTPad_D1.5mm_Drill0.7mm | Bare plated test pad; included in PCB fabrication; do not buy a component
TP5 | 1 | ADC_GRIP |  | TestPoint:TestPoint_THTPad_D1.5mm_Drill0.7mm | Bare plated test pad; included in PCB fabrication; do not buy a component
TP6 | 1 | +3V3 |  | TestPoint:TestPoint_THTPad_D1.5mm_Drill0.7mm | Bare plated test pad; included in PCB fabrication; do not buy a component
TP7 | 1 | GND |  | TestPoint:TestPoint_THTPad_D1.5mm_Drill0.7mm | Bare plated test pad; included in PCB fabrication; do not buy a component
TP8 | 1 | UP_SDA |  | TestPoint:TestPoint_THTPad_D1.5mm_Drill0.7mm | Bare plated test pad; included in PCB fabrication; do not buy a component
TP9 | 1 | UP_SCL |  | TestPoint:TestPoint_THTPad_D1.5mm_Drill0.7mm | Bare plated test pad; included in PCB fabrication; do not buy a component
