gmaxdragon/Seizo-Mini/procurement/COMPLETE-BOM.csv

Scope | References | Item | NeededQuantity | SuggestedBuyQuantity | PartNumber | StockFootprint | KnownUnitUSD | PrimaryURL | PriceStatus | Notes
Carrier | R19,R20,R21,R22 | 100 / 0.25W | 4 | 4 | MFR-25FBF52-100R | Resistor_THT:R_Axial_DIN0207_L6.3mm_D2.5mm_P7.62mm_Horizontal | 0.1 | https://www.digikey.com/en/products/detail/yageo/MFR-25FBF52-100R/12795 | Published distributor price/stock checked2026-11-04; not a saved cart; tax/delivery excluded | Yageo 1% 0.25W axial; bend straight leads to 7.62mm; equivalent only if verified to footprint
Carrier | R1,R3,R5,R7,R9 | 100k | 5 | 5 | MFR-25FBF52-100K | Resistor_THT:R_Axial_DIN0207_L6.3mm_D2.5mm_P7.62mm_Horizontal | 0.042 | https://www.digikey.com/en/products/detail/yageo/MFR-25FBF52-100K/13473 | Published distributor price/stock checked2026-11-04; not a saved cart; tax/delivery excluded | Yageo 1% 0.25W axial; bend straight leads to 7.62mm; equivalent only if verified to footprint
Carrier | C1,C10,C12,C2,C3,C4,C5,C7,C8,C9 | 100n | 10 | 10 | FG18X7R1H104KNT06 | Capacitor_THT:C_Rect_L4.0mm_W2.5mm_P2.50mm | 0.155 | https://www.digikey.com/en/products/detail/tdk-corporation/FG18X7R1H104KNT06/5802879 | Published distributor price/stock checked2026-11-04; not a saved cart; tax/delivery excluded | TDK 100nF 50V X7R; maximum 4x2.5mm body, 2.5mm pitch; 5.5mm body height
Carrier | R11,R12,R15,R25 | 10k | 4 | 4 | MFR-25FBF52-10K | Resistor_THT:R_Axial_DIN0207_L6.3mm_D2.5mm_P7.62mm_Horizontal | 0.1 | https://www.digikey.com/en/products/detail/yageo/MFR-25FBF52-10K/13219 | Published distributor price/stock checked2026-11-04; not a saved cart; tax/delivery excluded | Yageo 1% 0.25W axial; bend straight leads to 7.62mm; equivalent only if verified to footprint
Carrier | C6 | 10u / >=6.3V | 1 | 1 | ESK106M050AC3AA | Capacitor_THT:CP_Radial_D5.0mm_P2.00mm | 0.19 | https://www.digikey.com/en/products/detail/kemet/ESK106M050AC3AA/3083014 | Published distributor price/stock checked2026-11-04; not a saved cart; tax/delivery excluded | KEMET 10uF 50V; 5mm diameter, 2mm pitch; allow 12.5mm vertical clearance
Carrier | R16,R24 | 1k | 2 | 2 | MFR-25FBF52-1K | Resistor_THT:R_Axial_DIN0207_L6.3mm_D2.5mm_P7.62mm_Horizontal | 0.1 | https://www.digikey.com/en/products/detail/yageo/MFR-25FBF52-1K/13011 | Published distributor price/stock checked2026-11-04; not a saved cart; tax/delivery excluded | Yageo 1% 0.25W axial; bend straight leads to 7.62mm; equivalent only if verified to footprint
Carrier | R10,R2,R4,R6,R8 | 200k | 5 | 5 | MFR-25FBF52-200K | Resistor_THT:R_Axial_DIN0207_L6.3mm_D2.5mm_P7.62mm_Horizontal | 0.044 | https://www.digikey.com/en/products/detail/yageo/MFR-25FBF52-200K/13547 | Published distributor price/stock checked2026-11-04; not a saved cart; tax/delivery excluded | Yageo 1% 0.25W axial; bend straight leads to 7.62mm; equivalent only if verified to footprint
Carrier | RV1 | 20k BASE | 1 | 1 | PTV09A-1020F-B203 | Potentiometer_THT:Potentiometer_Bourns_PTV09A-1_Single_Vertical | 1.49 | https://www.digikey.com/en/products/detail/bourns-inc/PTV09A-1020F-B203/6153475 | Published distributor price/stock checked2026-11-04; not a saved cart; tax/delivery excluded | Bourns 20k linear; only board-mounted pot; shaft points up; no structural load
Carrier | J12 | 2717 CHANNEL-SIDE SOCKET | 1 | 1 | PPTC121LFBN-RC | Connector_PinSocket_2.54mm:PinSocket_1x12_P2.54mm_Vertical | 0.75 | https://www.digikey.com/en/products/detail/sullins-connector-solutions/PPTC121LFBN-RC/807231 | Published distributor price/stock checked2026-11-04; not a saved cart; tax/delivery excluded | Vertical female 1x12, 2.54mm pitch; Adafruit2717 module pair on 15.24mm row centers; see module-interface.json for orientation
Carrier | J6 | 2717 VIN-SIDE SOCKET | 1 | 1 | PPTC121LFBN-RC | Connector_PinSocket_2.54mm:PinSocket_1x12_P2.54mm_Vertical | 0.75 | https://www.digikey.com/en/products/detail/sullins-connector-solutions/PPTC121LFBN-RC/807231 | Published distributor price/stock checked2026-11-04; not a saved cart; tax/delivery excluded | Vertical female 1x12, 2.54mm pitch; Adafruit2717 module pair on 15.24mm row centers; see module-interface.json for orientation
Carrier | R13,R14 | 4k7 | 2 | 2 | MFR-25FTF52-4K7 | Resistor_THT:R_Axial_DIN0207_L6.3mm_D2.5mm_P7.62mm_Horizontal | 0.11 | https://www.digikey.com/en/products/detail/yageo/MFR-25FTF52-4K7/9140940 | Published distributor price/stock checked2026-11-04; not a saved cart; tax/delivery excluded | Yageo 1% 0.25W axial; bend straight leads to 7.62mm; equivalent only if verified to footprint
Carrier | J7 | BASE AS5600 SENSOR | 1 | 0 |  | Connector_PinHeader_2.54mm:PinHeader_1x04_P2.54mm_Vertical |  |  | Not quoted; final basket required | Vertical male 2.54mm header; use the exact pin count in the footprint; no right-angle substitute; raw male contacts included in PIN-STRIPS purchase below; not free separate components
Carrier | SW2 | FINISH | 1 | 1 | B3F-1000 | Button_Switch_THT:SW_TH_Tactile_Omron_B3F-100x | 0.35 | https://www.digikey.com/en/products/detail/omron-electronics-inc-emc-div/B3F-1000/33150 | Published distributor price/stock checked2026-11-04; not a saved cart; tax/delivery excluded | Omron 6mm tactile; 6.5x4.5mm contact pitch, stock KiCad B3F-100x
Carrier | J3 | FRONT ARM POT | 1 | 0 |  | Connector_PinHeader_2.54mm:PinHeader_1x03_P2.54mm_Vertical |  |  | Not quoted; final basket required | Vertical male 2.54mm header; use the exact pin count in the footprint; no right-angle substitute; raw male contacts included in PIN-STRIPS purchase below; not free separate components
Carrier | J9 | FRONT AS5600 SENSOR | 1 | 0 |  | Connector_PinHeader_2.54mm:PinHeader_1x04_P2.54mm_Vertical |  |  | Not quoted; final basket required | Vertical male 2.54mm header; use the exact pin count in the footprint; no right-angle substitute; raw male contacts included in PIN-STRIPS purchase below; not free separate components
Carrier | D1 | GREEN / POWER | 1 | 1 | WP710A10GD | LED_THT:LED_D3.0mm | 0.22 | https://www.digikey.com/en/products/detail/kingbright/WP710A10GD/2769808 | Published distributor price/stock checked2026-11-04; not a saved cart; tax/delivery excluded | Kingbright green 3mm LED, 2.54mm pitch; stock 3D model color is illustrative
Carrier | J11 | MAIN ARM POT | 1 | 0 |  | Connector_PinHeader_2.54mm:PinHeader_1x03_P2.54mm_Vertical |  |  | Not quoted; final basket required | Vertical male 2.54mm header; use the exact pin count in the footprint; no right-angle substitute; raw male contacts included in PIN-STRIPS purchase below; not free separate components
Carrier | J8 | MAIN AS5600 SENSOR | 1 | 0 |  | Connector_PinHeader_2.54mm:PinHeader_1x04_P2.54mm_Vertical |  |  | Not quoted; final basket required | Vertical male 2.54mm header; use the exact pin count in the footprint; no right-angle substitute; raw male contacts included in PIN-STRIPS purchase below; not free separate components
Carrier | J5 | OPEN/CLOSE POT | 1 | 0 |  | Connector_PinHeader_2.54mm:PinHeader_1x03_P2.54mm_Vertical |  |  | Not quoted; final basket required | Vertical male 2.54mm header; use the exact pin count in the footprint; no right-angle substitute; raw male contacts included in PIN-STRIPS purchase below; not free separate components
Carrier | SW3 | REPLAY | 1 | 1 | B3F-1000 | Button_Switch_THT:SW_TH_Tactile_Omron_B3F-100x | 0.35 | https://www.digikey.com/en/products/detail/omron-electronics-inc-emc-div/B3F-1000/33150 | Published distributor price/stock checked2026-11-04; not a saved cart; tax/delivery excluded | Omron 6mm tactile; 6.5x4.5mm contact pitch, stock KiCad B3F-100x
Carrier | J4 | ROT POT | 1 | 0 |  | Connector_PinHeader_2.54mm:PinHeader_1x03_P2.54mm_Vertical |  |  | Not quoted; final basket required | Vertical male 2.54mm header; use the exact pin count in the footprint; no right-angle substitute; raw male contacts included in PIN-STRIPS purchase below; not free separate components
Carrier | J1 | S3-ZERO LEFT | 1 | 1 | PPTC091LFBN-RC | Connector_PinSocket_2.54mm:PinSocket_1x09_P2.54mm_Vertical | 0.69 | https://www.digikey.com/en/products/detail/sullins-connector-solutions/PPTC091LFBN-RC/810148 | Published distributor price/stock checked2026-11-04; not a saved cart; tax/delivery excluded | Vertical female 1x9, 2.54mm pitch; two rows 15.24mm apart; source exact socket body/height
Carrier | J2 | S3-ZERO RIGHT | 1 | 1 | PPTC091LFBN-RC | Connector_PinSocket_2.54mm:PinSocket_1x09_P2.54mm_Vertical | 0.69 | https://www.digikey.com/en/products/detail/sullins-connector-solutions/PPTC091LFBN-RC/810148 | Published distributor price/stock checked2026-11-04; not a saved cart; tax/delivery excluded | Vertical female 1x9, 2.54mm pitch; two rows 15.24mm apart; source exact socket body/height
Carrier | SW1 | START | 1 | 1 | B3F-1000 | Button_Switch_THT:SW_TH_Tactile_Omron_B3F-100x | 0.35 | https://www.digikey.com/en/products/detail/omron-electronics-inc-emc-div/B3F-1000/33150 | Published distributor price/stock checked2026-11-04; not a saved cart; tax/delivery excluded | Omron 6mm tactile; 6.5x4.5mm contact pitch, stock KiCad B3F-100x
Carrier | J10 | UPSTREAM I2C 3V3 | 1 | 0 |  | Connector_PinHeader_2.54mm:PinHeader_1x04_P2.54mm_Vertical |  |  | Not quoted; final basket required | Vertical male 2.54mm header; use the exact pin count in the footprint; no right-angle substitute; raw male contacts included in PIN-STRIPS purchase below; not free separate components
Offboard | MCU | Waveshare ESP32-S3-Zero | 1 | 1 | ESP32-S3-Zero |  | 5.49 | https://www.waveshare.com/esp32-s3-zero.htm | Base-option advertised floor; select memory/header option before quoting | Includes own USB-C and 3.3V regulator; male pins needed for carrier sockets; confirm supplied header option
Offboard | MCU-PINS | Vertical male 1x9 pin strips for module | 2 | 0 |  |  |  |  | Unquoted; check whether supplied with selected module | 18 contacts total; can consolidate with carrier male headers into a suitable 40-pin breakaway strip; module sockets are separately counted; raw male contacts included in PIN-STRIPS purchase below; not free separate components
Offboard | POT2-POT5 | 20k linear remote pots | 4 | 4 | PTV09A-1020F-B203 |  | 1.49 | https://www.digikey.com/en/products/detail/bourns-inc/PTV09A-1020F-B203/6153475 | Published distributor price/stock checked2026-11-04; not a saved cart; tax/delivery excluded | Not four additional board pots: these are wired onto the miniature arm
Offboard | HARNESSES | Three-wire pot harnesses | 4 | 4 |  |  |  |  | Unquoted; length depends on mini-arm CAD | 12 conductors total; female 2.54mm carrier ends; insulated soldered ends at pots; provide strain relief
Offboard | USB | USB-A to USB-C DATA cable | 1 | 1 |  |  |  |  | Ownership/length/price unverified | One cable provides USB power and data from Pi; charge-only cable is unsuitable
Fabrication | PCB | 100x100mm 2-layer FR4 board with RF notch | 1 | 5 |  |  |  | https://jlcpcb.com/ | Advertised batch from $2; selected options and delivery not quoted | 1.6mm, 1oz, blue mask, white silk, lead-free HASL; one usable board needed
Mechanical | SUPPORTS | M3 insulated standoffs/screws/washers | 1 | 1 |  |  |  |  | Unquoted; screw lengths depend on CAD | Eight 3.2mm holes; four at 35/35,65/35,65/65,35/65mm support the mini-arm
Mechanical | MINI-ARM | Printed links, holders, shaft couplers and separate bearing | 1 | 1 |  |  |  |  | User CAD not yet completed; hardware/material quantities unknown | Pot shaft is not the bearing; add mechanical stops before pot end stops; no purchased motor/servo needed for teacher
Offboard | MUX | Adafruit2717 TCA9548A reader module | 1 | 1 | 2717 |  | 6.95 | https://www.digikey.com/en/products/detail/adafruit-industries-llc/2717/5604376 | Published distributor price/stock checked2026-11-04; not a saved cart; tax/delivery excluded | Two carrier female sockets replace the earlier12-wire adapter; verify original module, not a different clone pinout
Offboard | MUX-PINS | Vertical male1x12 strips for reader module | 2 | 0 |  |  |  |  | Check selected kit contents before ordering | 24contacts; fit to module first, insert into J6/J12; standard vertical, not right-angle; raw male contacts included in PIN-STRIPS purchase below; not free separate components
Offboard | ENC1-ENC3 | AdafruitAS5600 magnetic sensor heads | 3 | 3 | 6357 |  | 5.95 | https://www.digikey.com/en/products/detail/adafruit-industries-llc/6357/26832926 | Published distributor price/stock checked2026-11-04; not a saved cart; tax/delivery excluded | Actual sensor heads mount beside rotating magnets at the motors/joints; not on the main Mini board
Offboard | SENSOR-CABLES | QT-to-female-header four-wire sensor cables | 3 | 3 | 4397 |  | 0.95 | https://www.digikey.com/en/products/detail/adafruit-industries-llc/4397/10824270 | Published distributor price/stock checked2026-11-04; not a saved cart; tax/delivery excluded | Pin1GND black,2+3V3 red,3SDA blue,4SCL yellow; longer routes require a selected harness and bus validation
Mechanical | MAGNETS | Diametrically magnetized AS5600-compatible magnets | 3 | 3 | 8995 |  | 0.4 | https://www.digikey.com/en/products/detail/radial-magnets-inc/8995/5126077 | Diametric6x2.5mm candidate only; mechanical mount not verified | Use diametric magnetization; ordinary axial disc magnets are not an assumed equivalent
Mechanical | SENSOR-MOUNTS | Three stationary sensor brackets and rotating shaft couplers | 3 | 3 |  |  |  |  | Not designed or measured yet; hardware quantities unknown | Current motors have front-only shafts; keep sensors stationary, magnets rotate; avoid gear interference and provide strain relief
Delivery | CHECKOUT | All shipping, tax and tariffs to 94568 | 1 | 1 |  |  |  |  | Unknown; not zero; count once per actual vendor shipment | The complete delivered $30 cap is not verified
Offboard raw material | PIN-STRIPS | 40-pin male breakaway strips | 2 | 2 | PRPC040SAAN-RC | Cut segments to stock header geometry | 1.23 | https://www.digikey.com/en/products/detail/sullins-connector-solutions/PRPC040SAAN-RC/2775214 | 80contacts purchased for70 required; second strip may be unnecessary if both modules supply pins | 28carrier contacts +18S3 contacts +24mux contacts; do not double-purchase header segments above
