gmaxdragon/Seizo-Mini/motor-controller-r4/cost/Final_BOM.csv

section | references | quantity_used | purchase_required | purchase_quantity | description | manufacturer | mpn | seller | sku | unit_usd | line_usd | price_status | stock_status | source_url | native_mpns | footprints | notes
Native PCB | U1 U2 U3 U4 U5 | 5 | true | 5 | Five assembled plug-in stepper driver modules | BIGTREETECH | TMC2209 V1.3 | West3D | BTT0529 | 3.99 | 19.95 | Root observed unpaid cart2026-11-06 |  | https://west3d.com/products/tmc2209-stepper-motor-driver-drivers-btt | BIGTREETECH TMC2209 V1.3 | SeizoMotorController:StepStick_Socket16_P12.70_D1.00 | Five modules19.95USD. No motors. Exact genuineV1.3revision and reviewed shunts required. Five heatsinks/adhesive remain an explicit reserve below.
Native PCB | U6 | 1 | true | 1 | Native USB-C MCU module with23 male header pins pre-soldered | Waveshare | RP2040-Zero-M | Waveshare | 20335 | 4.99 | 4.99 | Root observed exact-M unpaid basket2026-11-06 |  | https://www.waveshare.com/rp2040-zero.htm?sku=20335 | Waveshare RP2040-Zero-M | SeizoMotorController:Waveshare_RP2040_Zero_Headers_9_9_5_P2.54 | Included headers solder directly through carrier. No separately removable MCU socket purchased. Required separate RUN/GND harness to actual Key2pads is accounted below; RUN is not an edge-header pin.
Native PCB | U7 | 1 | true | 1 | Octal STEP buffer / HOLD output enable,wideSOIC20 | Texas Instruments | SN74HC541DWR | LCSC | C6757 | 1.1224 | 1.12 | Exact saved unpaid cart unit price and displayed undiscounted line extension | Saved actual unpaid cart: all17 exactSKUs in stock | https://www.lcsc.com/product-detail/C6757.html | SN74HC541DWR | Package_SO:SOIC-20W_7.5x12.8mm_P1.27mm | Genuine TI wideSOIC20,1.27mmpitch; selected exact native package. Cart line_usd is authoritative displayed cents; unit_usd is separately displayed four-decimal precision. Ignore automatic0.24USDpromotion.
Native PCB | U8 | 1 | true | 1 | Motor-rail reset supervisor,SOT23-6 | Texas Instruments | TPS3808G01DBVR | LCSC | C19653 | 0.4628 | 0.46 | Exact saved unpaid cart unit price and displayed undiscounted line extension | Saved actual unpaid cart: all17 exactSKUs in stock | https://www.lcsc.com/product-detail/C19653.html | TPS3808G01DBVR | Package_TO_SOT_SMD:SOT-23-6 | NewR4SKU. RealSOT23-6part requires small surface-mount soldering; no factory assembly fee is assumed. It resets the MCU through mandatory RUN/GND service harness; not an emergency-stop or motor brake. Cart line_usd is authoritative displayed cents; unit_usd is separately displayed four-decimal precision. Ignore automatic0.24USDpromotion.
Native PCB | R11 R12 R13 R14 R15 R6 R7 R9 R21 R31 R22 R32 R23 R33 R24 R34 R25 R35 | 18 | true | 50 | 10k1%0.25W100ppm axial resistors | YAGEO | MFR-25FBF52-10K | LCSC | C1519255 | 0.0198 | 0.99 | Exact saved unpaid cart unit price and displayed undiscounted line extension | Saved actual unpaid cart: all17 exactSKUs in stock | https://www.lcsc.com/product-detail/C1519255.html | MFR-25FBF52-10K | Resistor_THT:R_Axial_DIN0207_L6.3mm_D2.5mm_P7.62mm_Horizontal | 18fitted,32spares; includes newR6,R7,R9. Body6.3×2.4mm formed to7.62mmpitch. Cart line_usd is authoritative displayed cents; unit_usd is separately displayed four-decimal precision. Ignore automatic0.24USDpromotion.
Native PCB | R2 R3 R4 R8 | 4 | true | 50 | 1k1%0.25W50ppm axial resistors | YAGEO | MFR-25FTE52-1K | LCSC | C172978 | 0.0152 | 0.76 | Exact saved unpaid cart unit price and displayed undiscounted line extension | Saved actual unpaid cart: all17 exactSKUs in stock | https://www.lcsc.com/product-detail/C172978.html | MFR-25FTE52-1K | Resistor_THT:R_Axial_DIN0207_L6.3mm_D2.5mm_P7.62mm_Horizontal | 4fitted,46spares; includes newR8. Body6.3×2.4mm formed to7.62mmpitch. Cart line_usd is authoritative displayed cents; unit_usd is separately displayed four-decimal precision. Ignore automatic0.24USDpromotion.
Native PCB assembly link | R5 | 1 | false | 0 | Fitted wire link from clipped resistor lead | Assembly material | Assembly link - tinned resistor-lead offcut | Already purchased resistor pack | No separate purchase | 0 | 0 | Required assembly link,no separate purchase |  |  | Assembly link - tinned resistor-lead offcut | Resistor_THT:R_Axial_DIN0207_L6.3mm_D2.5mm_P7.62mm_Horizontal | Form acrossR5holes7.62mmpitch with clearance. KeepR4=1k; do not fit1k atR5.
Native PCB | C2 C3 | 2 | true | 5 | 100nF50VX7R10% radial bypass capacitors | Murata | RDER71H104K0S1H03A | LCSC | C524651 | 0.0966 | 0.48 | Exact saved unpaid cart unit price and displayed undiscounted line extension | Saved actual unpaid cart: all17 exactSKUs in stock | https://www.lcsc.com/product-detail/C524651.html | RDER71H104K0S1H03A | Capacitor_THT:C_Disc_D5.0mm_W2.5mm_P2.50mm | 2fitted,3spares. Includes newC3. Body5×2.5mm/P2.5. Cart line_usd is authoritative displayed cents; unit_usd is separately displayed four-decimal precision. Ignore automatic0.24USDpromotion.
Native PCB | C11 C12 C13 C14 C15 | 5 | true | 10 | 100uF35V low-impedance radial capacitors | Rubycon | 35ZLH100MEFC6.3X11 | LCSC | C109392 | 0.0681 | 0.68 | Exact saved unpaid cart unit price and displayed undiscounted line extension | Saved actual unpaid cart: all17 exactSKUs in stock | https://www.lcsc.com/product-detail/C109392.html | 35ZLH100MEFC6.3X11 | Capacitor_THT:CP_Radial_D6.3mm_P2.50mm | 5fitted,5spares. Body6.3×11mm/P2.5;540mA100kHzripple;6000h105C. Cart line_usd is authoritative displayed cents; unit_usd is separately displayed four-decimal precision. Ignore automatic0.24USDpromotion.
Native PCB | C1 | 1 | true | 1 | 470uF50V radial bulk capacitor | Panasonic | EEU-FR1H471 | LCSC | C178708 | 0.8139 | 0.81 | Exact saved unpaid cart unit price and displayed undiscounted line extension | Saved actual unpaid cart: all17 exactSKUs in stock | https://www.lcsc.com/product-detail/C178708.html | EEU-FR1H471 | Capacitor_THT:CP_Radial_D12.5mm_P5.00mm | 12.5mmdiameter/P5. Cart line_usd is authoritative displayed cents; unit_usd is separately displayed four-decimal precision. Ignore automatic0.24USDpromotion.
Native PCB | J1 J2 J3 J4 J5 | 5 | true | 5 | Four-position5.08mm motor screw terminals | DORABO | DB128V-5.08-4P-GN-S | LCSC | C2915641 | 0.4256 | 2.13 | Exact saved unpaid cart unit price and displayed undiscounted line extension | Saved actual unpaid cart: all17 exactSKUs in stock | https://www.lcsc.com/product-detail/C2915641.html | DB128V-5.08-4P-GN-S | SeizoMotorController:TerminalBlock_DORABO_DB128V_1x04_P5.08mm_D1.60 | Native custom reviewed1.60mmdrill footprint; verify physical fit. Undiscounted quoted2.13USDline used. Cart line_usd is authoritative displayed cents; unit_usd is separately displayed four-decimal precision. Ignore automatic0.24USDpromotion.
Native PCB | J6 | 1 | true | 1 | 5A24V barrel jack,2.0mm center pin | Same Sky | PJ-102AH | LCSC | C3096093 | 1.0637 | 1.06 | Exact saved unpaid cart unit price and displayed undiscounted line extension | Saved actual unpaid cart: all17 exactSKUs in stock | https://www.lcsc.com/product-detail/C3096093.html | PJ-102AH | Connector_BarrelJack:BarrelJack_CUI_PJ-102AH_Horizontal | Mates nominal5.5OD/2.1IDplug; owned adapter plug/polarity must be checked. Cart line_usd is authoritative displayed cents; unit_usd is separately displayed four-decimal precision. Ignore automatic0.24USDpromotion.
Native PCB | J7 J9 | 2 | true | 20 | Two-pin2.54mm vertical male headers | Ckmtw | B-2100S02P-A110 | LCSC | C124375 | 0.0281 | 0.56 | Exact saved unpaid cart unit price and displayed undiscounted line extension | Saved actual unpaid cart: all17 exactSKUs in stock | https://www.lcsc.com/product-detail/C124375.html | B-2100S02P-A110 | Connector_PinHeader_2.54mm:PinHeader_1x02_P2.54mm_Vertical | 2fitted,18spares. J7HOLDdryNCcontact; newJ9requiredRUN/GNDharness. Square0.64mmpins,6mmmating/3mmtail. Cart line_usd is authoritative displayed cents; unit_usd is separately displayed four-decimal precision. Ignore automatic0.24USDpromotion.
Native PCB | J8 | 1 | true | 5 | Keyed four-pin2.54mm PC fan header | Molex | 470531000 | LCSC | C240840 | 0.181 | 0.91 | Exact saved unpaid cart unit price and displayed undiscounted line extension | Saved actual unpaid cart: all17 exactSKUs in stock | https://www.lcsc.com/product-detail/C240840.html | 470531000 | Connector:FanPinHeader_1x04_P2.54mm_Vertical | 1fitted,4spares. Official4A/contact rating is component rating, not system qualification. Fan1GND2fused12V3tachNC4PWMNC. Cart line_usd is authoritative displayed cents; unit_usd is separately displayed four-decimal precision. Ignore automatic0.24USDpromotion.
Native PCB | F1 | 1 | true | 5 | 4A125VDC time-delay main fuse,2410 | Littelfuse | 0454004.MR | LCSC | C179006 | 0.2902 | 1.45 | Exact saved unpaid cart unit price and displayed undiscounted line extension | Saved actual unpaid cart: all17 exactSKUs in stock | https://www.lcsc.com/product-detail/C179006.html | 0454004.MR | Fuse:Fuse_Littelfuse-NANO2-451_453 | 1fitted,4spares. Soldered fuse,no holder. Fuse rating does not establish a2.5Acontinuous board qualification. Cart line_usd is authoritative displayed cents; unit_usd is separately displayed four-decimal precision. Ignore automatic0.24USDpromotion.
Native PCB | F2 | 1 | true | 5 | 0.5A125VDC time-delay fan branch fuse,2410 | Littelfuse | 0454.500MR | LCSC | C179003 | 0.2094 | 1.05 | Exact saved unpaid cart unit price and displayed undiscounted line extension | Saved actual unpaid cart: all17 exactSKUs in stock | https://www.lcsc.com/product-detail/C179003.html | 0454.500MR | Fuse:Fuse_Littelfuse-NANO2-451_453 | 1fitted,4spares. Thin fan-lead branch protection; inrush/ambientderating require test. Cart line_usd is authoritative displayed cents; unit_usd is separately displayed four-decimal precision. Ignore automatic0.24USDpromotion.
Native PCB | D2 | 1 | true | 1 | 15V1500W transient suppressor,SMC | Bourns | SMCJ15A | LCSC | C3719503 | 0.6821 | 0.68 | Exact saved unpaid cart unit price and displayed undiscounted line extension | Saved actual unpaid cart: all17 exactSKUs in stock | https://www.lcsc.com/product-detail/C3719503.html | SMCJ15A | Diode_SMD:D_SMC | 24.4Vclamp at specified61.5Apulse is not a continuous braking-energy rating or proof each module stays below29V. Cart line_usd is authoritative displayed cents; unit_usd is separately displayed four-decimal precision. Ignore automatic0.24USDpromotion.
Native PCB | D1 | 1 | true | 1 | 5A60V axial Schottky motor-input isolation diode | Vishay | SB560-E3/54 | LCSC | C506560 | 0.5418 | 0.54 | Exact saved unpaid cart unit price and displayed undiscounted line extension | Saved actual unpaid cart: all17 exactSKUs in stock | https://www.lcsc.com/product-detail/C506560.html | SB560-E3/54 | SeizoMotorController:D_DO-201AD_P25.40mm_Horizontal_D1.60 | DO201AD,1.60mmdrill/25.4mmformedpitch. Thermal loss/leadconditions/airflow require physical validation. Initial total-input qualification envelope≤2.5A, not certified continuous rating. Cart line_usd is authoritative displayed cents; unit_usd is separately displayed four-decimal precision. Ignore automatic0.24USDpromotion.
Native PCB | D3 | 1 | true | 5 | 1A40V axial Schottky fan isolation diode | Vishay | 1N5819-E3/54 | LCSC | C145202 | 0.1434 | 0.72 | Exact saved unpaid cart unit price and displayed undiscounted line extension | Saved actual unpaid cart: all17 exactSKUs in stock | https://www.lcsc.com/product-detail/C145202.html | 1N5819-E3/54 | Diode_THT:D_DO-41_SOD81_P7.62mm_Horizontal | Fan branch before mainD1, throughF2andD3.1fitted,4spares. Cart line_usd is authoritative displayed cents; unit_usd is separately displayed four-decimal precision. Ignore automatic0.24USDpromotion.
Assembly accessory / external |  | 10 | true | 10 | Ten female8-position driver sockets | BOOMELE | 2.54-1*8P | LCSC | C27438 | 0.1193 | 1.19 | Exact saved unpaid cart unit price and displayed undiscounted line extension | Saved actual unpaid cart: all17 exactSKUs in stock | https://www.lcsc.com/product-detail/C27438.html |  |  | Two socket rows per each of five modules, additional physical parts beyond five logical module footprints. Validate actual contact heating. Cart line_usd is authoritative displayed cents; unit_usd is separately displayed four-decimal precision. Ignore automatic0.24USDpromotion.
Assembly accessory / external |  | 1 | true | 1 | 12V40×40×10mm cooling fan with screw pack | Waveshare | Fan-4010-PWM-12V | Waveshare | 19193 | 2.69 | 2.69 | Root observed unpaid basket2026-11-06 |  | https://www.waveshare.com/fan-4010-pwm-12v.htm |  |  | Official0.48W/40mA±20mA/5000rpm. Full-speed operation withPWMunconnected and cooling across allfive modules require physical tests; bracket/duct not supplied.
Assembly accessory / external |  | 1 | true | 1 | USB2A-male toC-male data cable,1m | Waveshare | USB-A-TO-USB-C-Cable-1M | Waveshare | 35944 | 1.19 | 1.19 | Exact root-observed unpaid cart; shipping remains10.00USD |  | https://www.waveshare.com/usb-a-to-usb-c-cable-1m.htm |  |  | OfficialUSB2datatransmission description. Rechecked cart after cable addition.
Assembly accessory / external |  | 2 | false | 0 | Two short insulated internal RUN/GND harness wires | USER OWNED | Owned jumper wire sections | Already owned | No purchase | 0 | 0 | Reuse user-owned jumper wires |  |  |  |  | Required internal service harness: J9.1→actualZeroKey2.1RUN, J9.2→Key2.2GND. Identify manufacturer nets and unpowered continuity, not visual left/right. No invented edgeRUNpin. Tools separate.
Assembly accessory / external |  | 1 | false | 0 | HOLD bench link from owned jumper wire | USER OWNED | Owned insulated jumper wire loop | Already owned | No purchase | 0 | 0 | Reuse owned jumper wire; no separate shunt purchase |  |  |  |  | Required between J7.1 and J7.2 for bench operation when no external dryNCcontact is fitted. Use a female-to-female jumper or an insulated soldered loop. No external voltage. Not an emergency-stop button.
Assembly accessory / external |  | 5 | true | 1 | Five module heatsinks/adhesive reserve | UNSELECTED | Compatible module heatsinks if not included | West3D/parts order | Contents pending | 2 | 2 | Explicit reserve,not selected purchase |  |  |  |  | Seller images/review suggest supplied heatsinks, but exactfive-unit contents unconfirmed. Remove only after actual confirmation.
Assembly accessory / external |  | 1 | true | 1 | Bare PCB batch: five100×100mm two-layer green lead-free boards | JLCPCB | R4 carrier PCB | JLCPCB | Final R4 uploaded-Gerber web quote | 5.3 | 5.3 | Root-verified final R4 Gerber upload quote2026-11-07 |  | https://jlcpcb.com/ |  |  | One board populated; four bare spares. Purchase quantity1 means one five-board fabrication batch at5.30USD plus9.20GlobalStandardDirectLine. FinalR4Gerberupload detected2layers100×100mm; manufacturer final engineering approval remains pending. Size,copper,finishchanges invalidate this quote. ConditionalDesktop3.30excluded.
Assembly accessory / external |  | 1 | false | 0 | Owned12V4Aadapter reused | USER OWNED | Exact label and plug to verify | Already owned | No purchase | 0 | 0 | Explicit user-approved reuse |  |  |  |  | Initial total-input qualification envelope≤2.5A/30Wshared across five slots, not a protective current clamp or certified continuous rating. Adapterpolarity,plugfit,regulation and totalbudget must be measured.
Assembly accessory / external |  | 1 | false | 0 | Insulated printed mounting base using owned material | USER OWNED | Printed insulated mount | Already owned | No purchase | 0 | 0 | Explicit reused printing material |  |  |  |  | No new fastenerpack charged. Actualretention/clearances required; new mounting hardware needs repricing.
