gmaxdragon/Seizo-Mini/motor-controller-r4-1/assembly/quotation-only/JLC_R41_TOP2_QUOTE_BOM.csv

Comment | Designator | Footprint | LCSC Part #
SN74HC541DWR | U7 | SOIC-20W_7.5x12.8mm_P1.27mm | C6757
TPS3808G01DBVR | U8 | SOT-23-6 | C19653
