gmaxdragon/Seizo-Mini/motor-controller-r4/assembly/quotation-only/JLC_R4_TOP4_SMT_QUOTE_BOM.csv

Comment | Designator | Footprint | LCSC Part #
SN74HC541DWR | U7 | SOIC-20W_7.5x12.8mm_P1.27mm | C6757
TPS3808G01DBVR | U8 | SOT-23-6 | C19653
0454004.MR | F1 | Fuse_Littelfuse-NANO2-451_453 | C179006
0454.500MR | F2 | Fuse_Littelfuse-NANO2-451_453 | C179003
