gmaxdragon/Seizo-Mini/motor-controller-r4-1/assembly/R41-pad-map.csv

reference | pad_number | net | component_side | x_from_front_top_left_mm | y_from_front_top_left_mm
C1 | 1 | VMOT | F | 61.5 | 92.0
C1 | 2 | GND | F | 66.5 | 92.0
C11 | 1 | VMOT | F | 28.75 | 13.0
C11 | 2 | GND | F | 31.25 | 13.0
C12 | 1 | VMOT | F | 55.75 | 13.0
C12 | 2 | GND | F | 58.25 | 13.0
C13 | 1 | VMOT | F | 88.75 | 13.0
C13 | 2 | GND | F | 91.25 | 13.0
C14 | 1 | VMOT | F | 28.75 | 55.0
C14 | 2 | GND | F | 31.25 | 55.0
C15 | 1 | VMOT | F | 55.75 | 55.0
C15 | 2 | GND | F | 58.25 | 55.0
C2 | 1 | +3V3_USB | F | 73.5 | 76.25
C2 | 2 | GND | F | 73.5 | 78.75
C3 | 1 | +3V3_USB | F | 69.5 | 32.0
C3 | 2 | GND | F | 72.0 | 32.0
D1 | 1 | VMOT | F | 52.7 | 94.0
D1 | 2 | VIN_FUSED | F | 27.3 | 94.0
D2 | 1 | VMOT | B | 63.6 | 86.0
D2 | 2 | GND | B | 70.4 | 86.0
D3 | 1 | FAN_VMOT | F | 90.81 | 89.5
D3 | 2 | FAN_FUSED | F | 83.19 | 89.5
F1 | 1 | VIN_RAW | F | 19.545 | 88.8
F1 | 2 | VIN_FUSED | F | 24.455 | 88.8
F2 | 1 | VIN_FUSED | F | 18.745 | 96.0
F2 | 2 | FAN_FUSED | F | 23.655 | 96.0
J1 | 1 | A1_1 | F | 8.0 | 40.0
J1 | 2 | A2_1 | F | 13.08 | 40.0
J1 | 3 | B1_1 | F | 18.16 | 40.0
J1 | 4 | B2_1 | F | 23.24 | 40.0
J2 | 1 | A1_2 | F | 35.0 | 40.0
J2 | 2 | A2_2 | F | 40.08 | 40.0
J2 | 3 | B1_2 | F | 45.16 | 40.0
J2 | 4 | B2_2 | F | 50.24 | 40.0
J3 | 1 | A1_3 | F | 68.0 | 40.0
J3 | 2 | A2_3 | F | 73.08 | 40.0
J3 | 3 | B1_3 | F | 78.16 | 40.0
J3 | 4 | B2_3 | F | 83.24 | 40.0
J4 | 1 | A1_4 | F | 8.0 | 79.0
J4 | 2 | A2_4 | F | 13.08 | 79.0
J4 | 3 | B1_4 | F | 18.16 | 79.0
J4 | 4 | B2_4 | F | 23.24 | 79.0
J5 | 1 | A1_5 | F | 35.0 | 79.0
J5 | 2 | A2_5 | F | 40.08 | 79.0
J5 | 3 | B1_5 | F | 45.16 | 79.0
J5 | 4 | B2_5 | F | 50.24 | 79.0
J6 | 1 | VIN_RAW | F | 15.2 | 92.25
J6 | 2 | GND | F | 9.2 | 92.25
J6 | 3 | unconnected-(J6-Pad3) | F | 12.2 | 96.95
J7 | 1 | GND | F | 95.0 | 84.0
J7 | 2 | HOLD_CONTACT | F | 95.0 | 86.54
J8 | 1 | GND | F | 95.0 | 22.0
J8 | 2 | FAN_VMOT | F | 95.0 | 24.54
J8 | 3 | unconnected-(J8-Pin_3-Pad3) | F | 95.0 | 27.08
J8 | 4 | unconnected-(J8-Pin_4-Pad4) | F | 95.0 | 29.62
J9 | 1 | VMOT_RESET_N | F | 68.0 | 48.0
J9 | 2 | GND | F | 70.54 | 48.0
R11 | 1 | STEP_RAW1 | F | 94.73 | 46.37
R11 | 2 | GND | F | 94.73 | 53.99
R12 | 1 | STEP_RAW2 | F | 65.41 | 72.185
R12 | 2 | GND | F | 65.41 | 79.805
R13 | 1 | STEP_RAW3 | F | 69.0 | 61.875
R13 | 2 | GND | F | 69.0 | 69.495
R14 | 1 | STEP_RAW4 | F | 65.385 | 56.9025
R14 | 2 | GND | F | 73.005 | 56.9025
R15 | 1 | STEP_RAW5 | F | 65.385 | 53.3125
R15 | 2 | GND | F | 73.005 | 53.3125
R2 | 1 | UART_A_TX | F | 83.97 | 53.54
R2 | 2 | UART_A | F | 91.59 | 53.54
R21 | 1 | STEP1 | F | 6.38 | 18.0425
R21 | 2 | GND | F | 6.38 | 25.6625
R22 | 1 | STEP2 | F | 33.38 | 18.0425
R22 | 2 | GND | F | 33.38 | 25.6625
R23 | 1 | STEP3 | F | 93.045 | 32.99
R23 | 2 | GND | F | 93.045 | 40.61
R24 | 1 | STEP4 | F | 6.38 | 56.68
R24 | 2 | GND | F | 6.38 | 64.3
R25 | 1 | STEP5 | F | 2.55 | 66.99
R25 | 2 | GND | F | 2.55 | 74.61
R3 | 1 | UART_B_TX | F | 72.59 | 60.0425
R3 | 2 | UART_B | F | 72.59 | 67.6625
R31 | 1 | +3V3_USB | F | 10.785 | 6.39
R31 | 2 | EN1_N | F | 18.405 | 6.39
R32 | 1 | +3V3_USB | F | 65.41 | 61.875
R32 | 2 | EN2_N | F | 65.41 | 69.495
R33 | 1 | +3V3_USB | F | 96.455 | 36.06
R33 | 2 | EN3_N | F | 96.455 | 43.68
R34 | 1 | +3V3_USB | F | 2.79 | 56.68
R34 | 2 | EN4_N | F | 2.79 | 64.3
R35 | 1 | +3V3_USB | F | 2.55 | 77.3
R35 | 2 | EN5_N | F | 2.55 | 84.92
R4 | 1 | +3V3_USB | F | 77.5 | 93.1
R4 | 2 | HOLD_OPEN | F | 85.12 | 93.1
R5 | 1 | HOLD_CONTACT | F | 82.0 | 96.5
R5 | 2 | HOLD_OPEN | F | 89.62 | 96.5
R6 | 1 | VMOT | F | 64.2 | 5.0
R6 | 2 | VMOT_DIV_MID | F | 64.2 | 12.62
R7 | 1 | VMOT_DIV_MID | F | 64.2 | 17.5
R7 | 2 | VMOT_SENSE | F | 64.2 | 25.12
R8 | 1 | VMOT_SENSE | F | 58.2 | 33.5
R8 | 2 | GND | F | 58.2 | 41.12
R9 | 1 | +3V3_USB | F | 58.2 | 18.3
R9 | 2 | VMOT_RESET_N | F | 58.2 | 25.92
U1 | 1 | EN1_N | F | 10.0 | 10.0
U1 | 2 | GND | F | 10.0 | 12.54
U1 | 3 | GND | F | 10.0 | 15.08
U1 | 4 | UART_A | F | 10.0 | 17.62
U1 | 5 | unconnected-(U1-TX_NC-Pad5) | F | 10.0 | 20.16
U1 | 6 | GND | F | 10.0 | 22.7
U1 | 7 | STEP1 | F | 10.0 | 25.24
U1 | 8 | DIR1 | F | 10.0 | 27.78
U1 | 9 | GND | F | 22.7 | 27.78
U1 | 10 | +3V3_USB | F | 22.7 | 25.24
U1 | 11 | B2_1 | F | 22.7 | 22.7
U1 | 12 | B1_1 | F | 22.7 | 20.16
U1 | 13 | A1_1 | F | 22.7 | 17.62
U1 | 14 | A2_1 | F | 22.7 | 15.08
U1 | 15 | GND | F | 22.7 | 12.54
U1 | 16 | VMOT | F | 22.7 | 10.0
U2 | 1 | EN2_N | F | 37.0 | 10.0
U2 | 2 | +3V3_USB | F | 37.0 | 12.54
U2 | 3 | GND | F | 37.0 | 15.08
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
U7 | 20 | +3V3_USB | F | 78.285 | 76.25
U8 | 1 | VMOT_RESET_N | F | 66.4375 | 30.45
U8 | 2 | GND | F | 66.4375 | 29.5
U8 | 3 | +3V3_USB | F | 66.4375 | 28.55
U8 | 4 | unconnected-(U8-CT-Pad4) | F | 64.1625 | 28.55
U8 | 5 | VMOT_SENSE | F | 64.1625 | 29.5
U8 | 6 | +3V3_USB | F | 64.1625 | 30.45
