gmaxdragon/Seizo-Mini/procurement/DigiKey_Import.csv

CustomerReference | ManufacturerPartNumber | Quantity
R19 R20 R21 R22 | MFR-25FBF52-100R | 4
R1 R3 R5 R7 R9 - 5 REQUIRED 5 SPARE | MFR-25FBF52-100K | 10
R2 R4 R6 R8 R10 - 5 REQUIRED 5 SPARE | MFR-25FBF52-200K | 10
R11 R12 R15 R25 | MFR-25FBF52-10K | 4
R16 R24 | MFR-25FBF52-1K | 2
R13 R14 - CUT TAPE | MFR-25FTF52-4K7 | 2
C1 C2 C3 C4 C5 C7 C8 C9 C10 C12 - CUT TAPE | FG18X7R1H104KNT06 | 10
C6 | ESK106M050AC3AA | 1
RV1 AND FOUR REMOTE POTS | PTV09A-1020F-B203 | 5
D1 | WP710A10GD | 1
SW1 SW2 SW3 | B3F-1000 | 3
J1 J2 | PPTC091LFBN-RC | 2
J6 J12 | PPTC121LFBN-RC | 2
MALE STRIPS - 28 CARRIER PLUS MODULE PINS IF NEEDED | PRPC040SAAN-RC | 2
MUX MODULE | 2717 | 1
AS5600 SENSOR HEADS - BASE MAIN FRONT | 6357 | 3
SENSOR CABLES - 150mm LENGTH MUST BE CHECKED | 4397 | 3
MAGNETS - 6x2.5mm MOUNT MUST BE DESIGNED | 8995 | 3
