gmaxdragon/Seizo-Mini/motor-controller-r4-1/cart-proof/LCSC-manual-Nov8.jpg

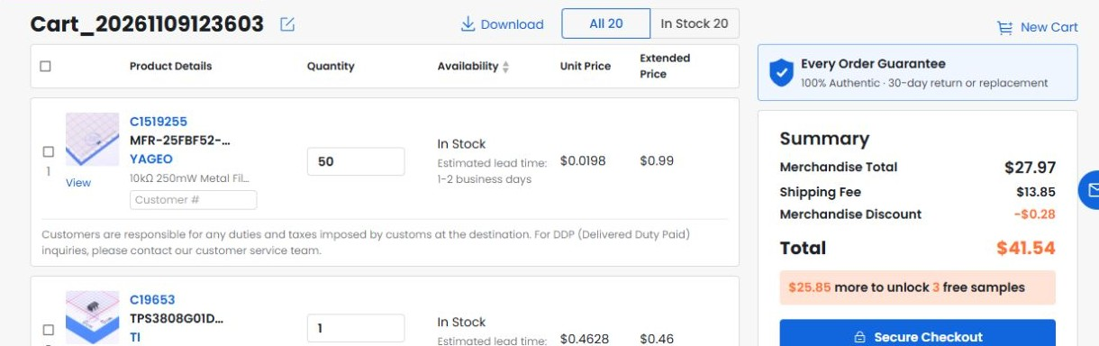
motor-controller-r4-1/cart-proof/LCSC-manual-Nov8.jpg
