gmaxdragon/Seizo-Mini/motor-controller-r4/assembly/R4-assembly-back.png

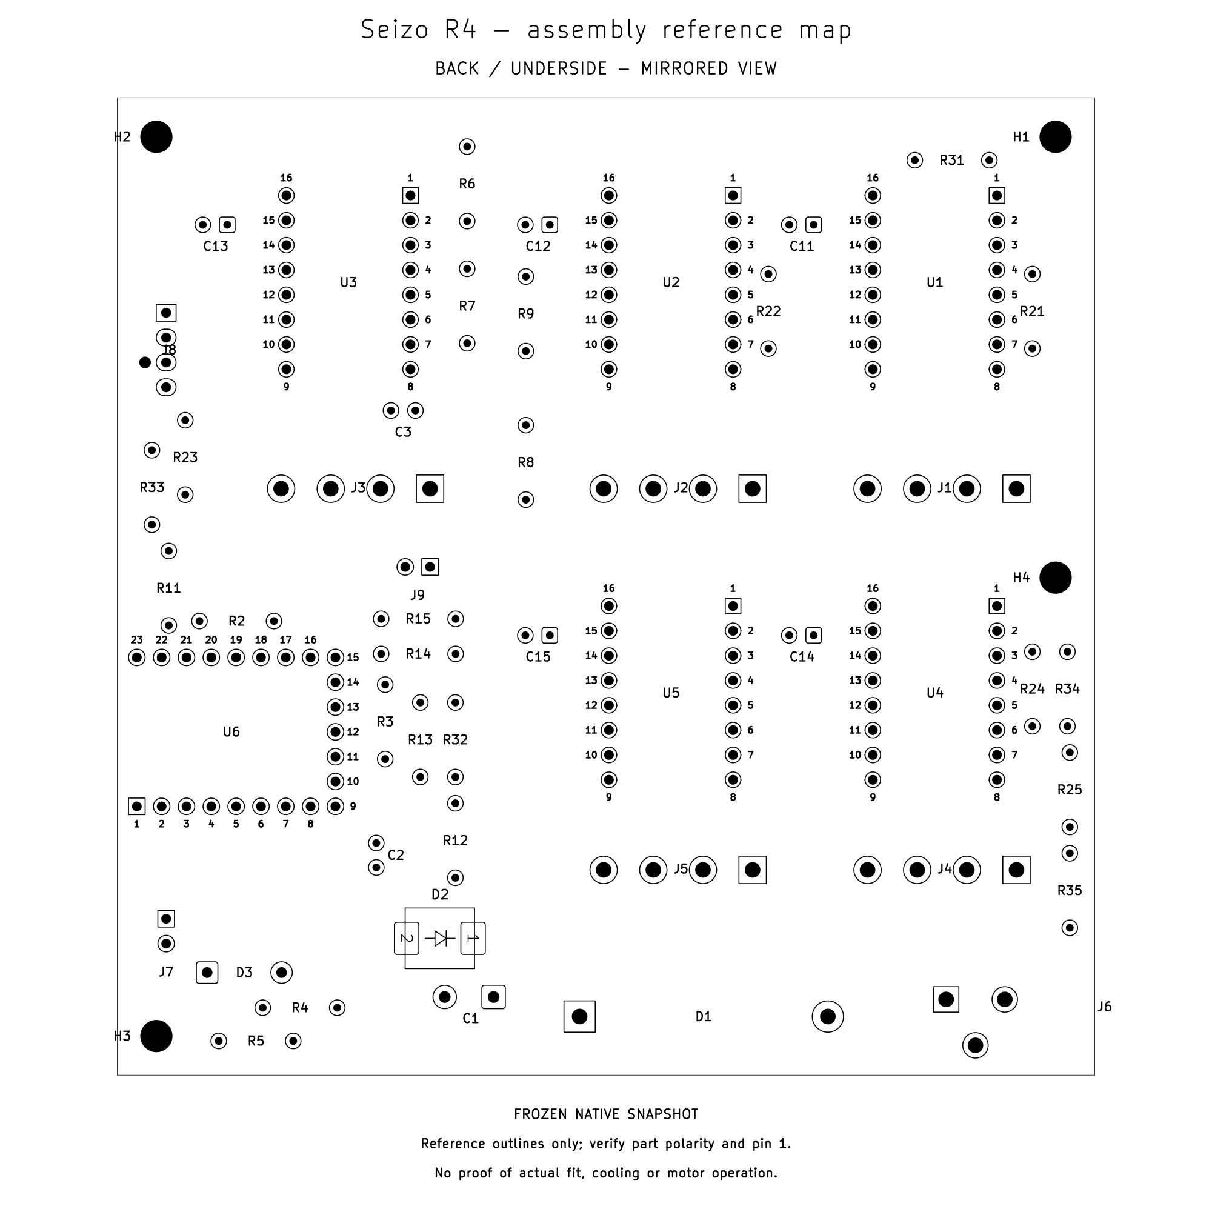
motor-controller-r4/assembly/R4-assembly-back.png
