gmaxdragon/Seizo-Mini/motor-controller-r4/assembly/R4-assembly-front.png

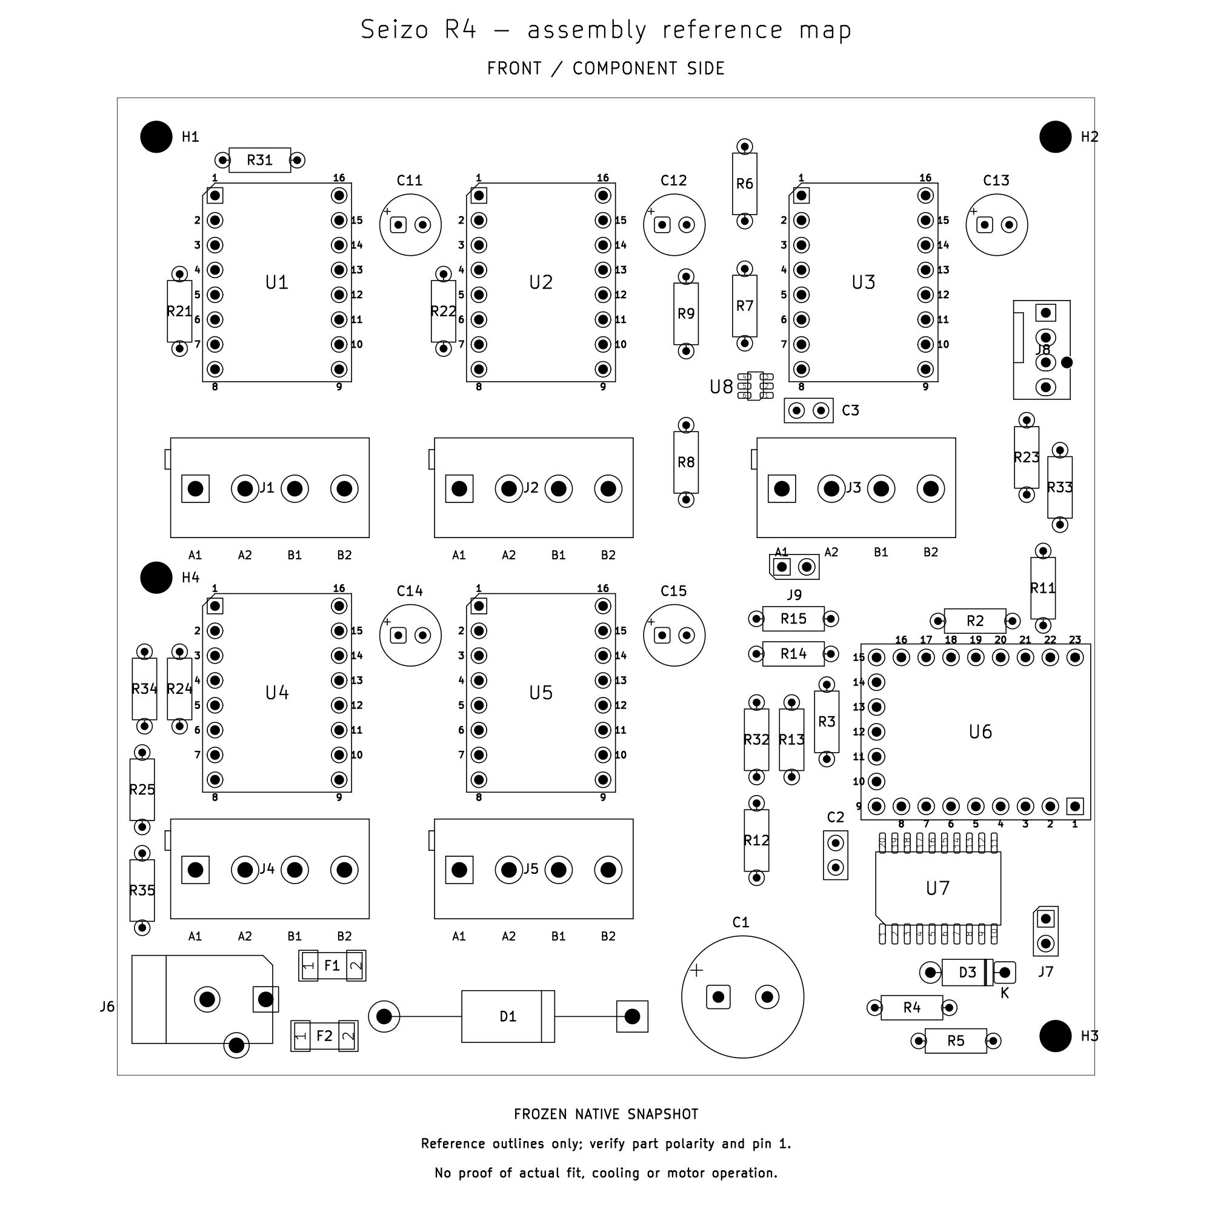
motor-controller-r4/assembly/R4-assembly-front.png
