gmaxdragon/Seizo-Mini/motor-controller-r4-1/preview/Schematic-R4.1.pdf

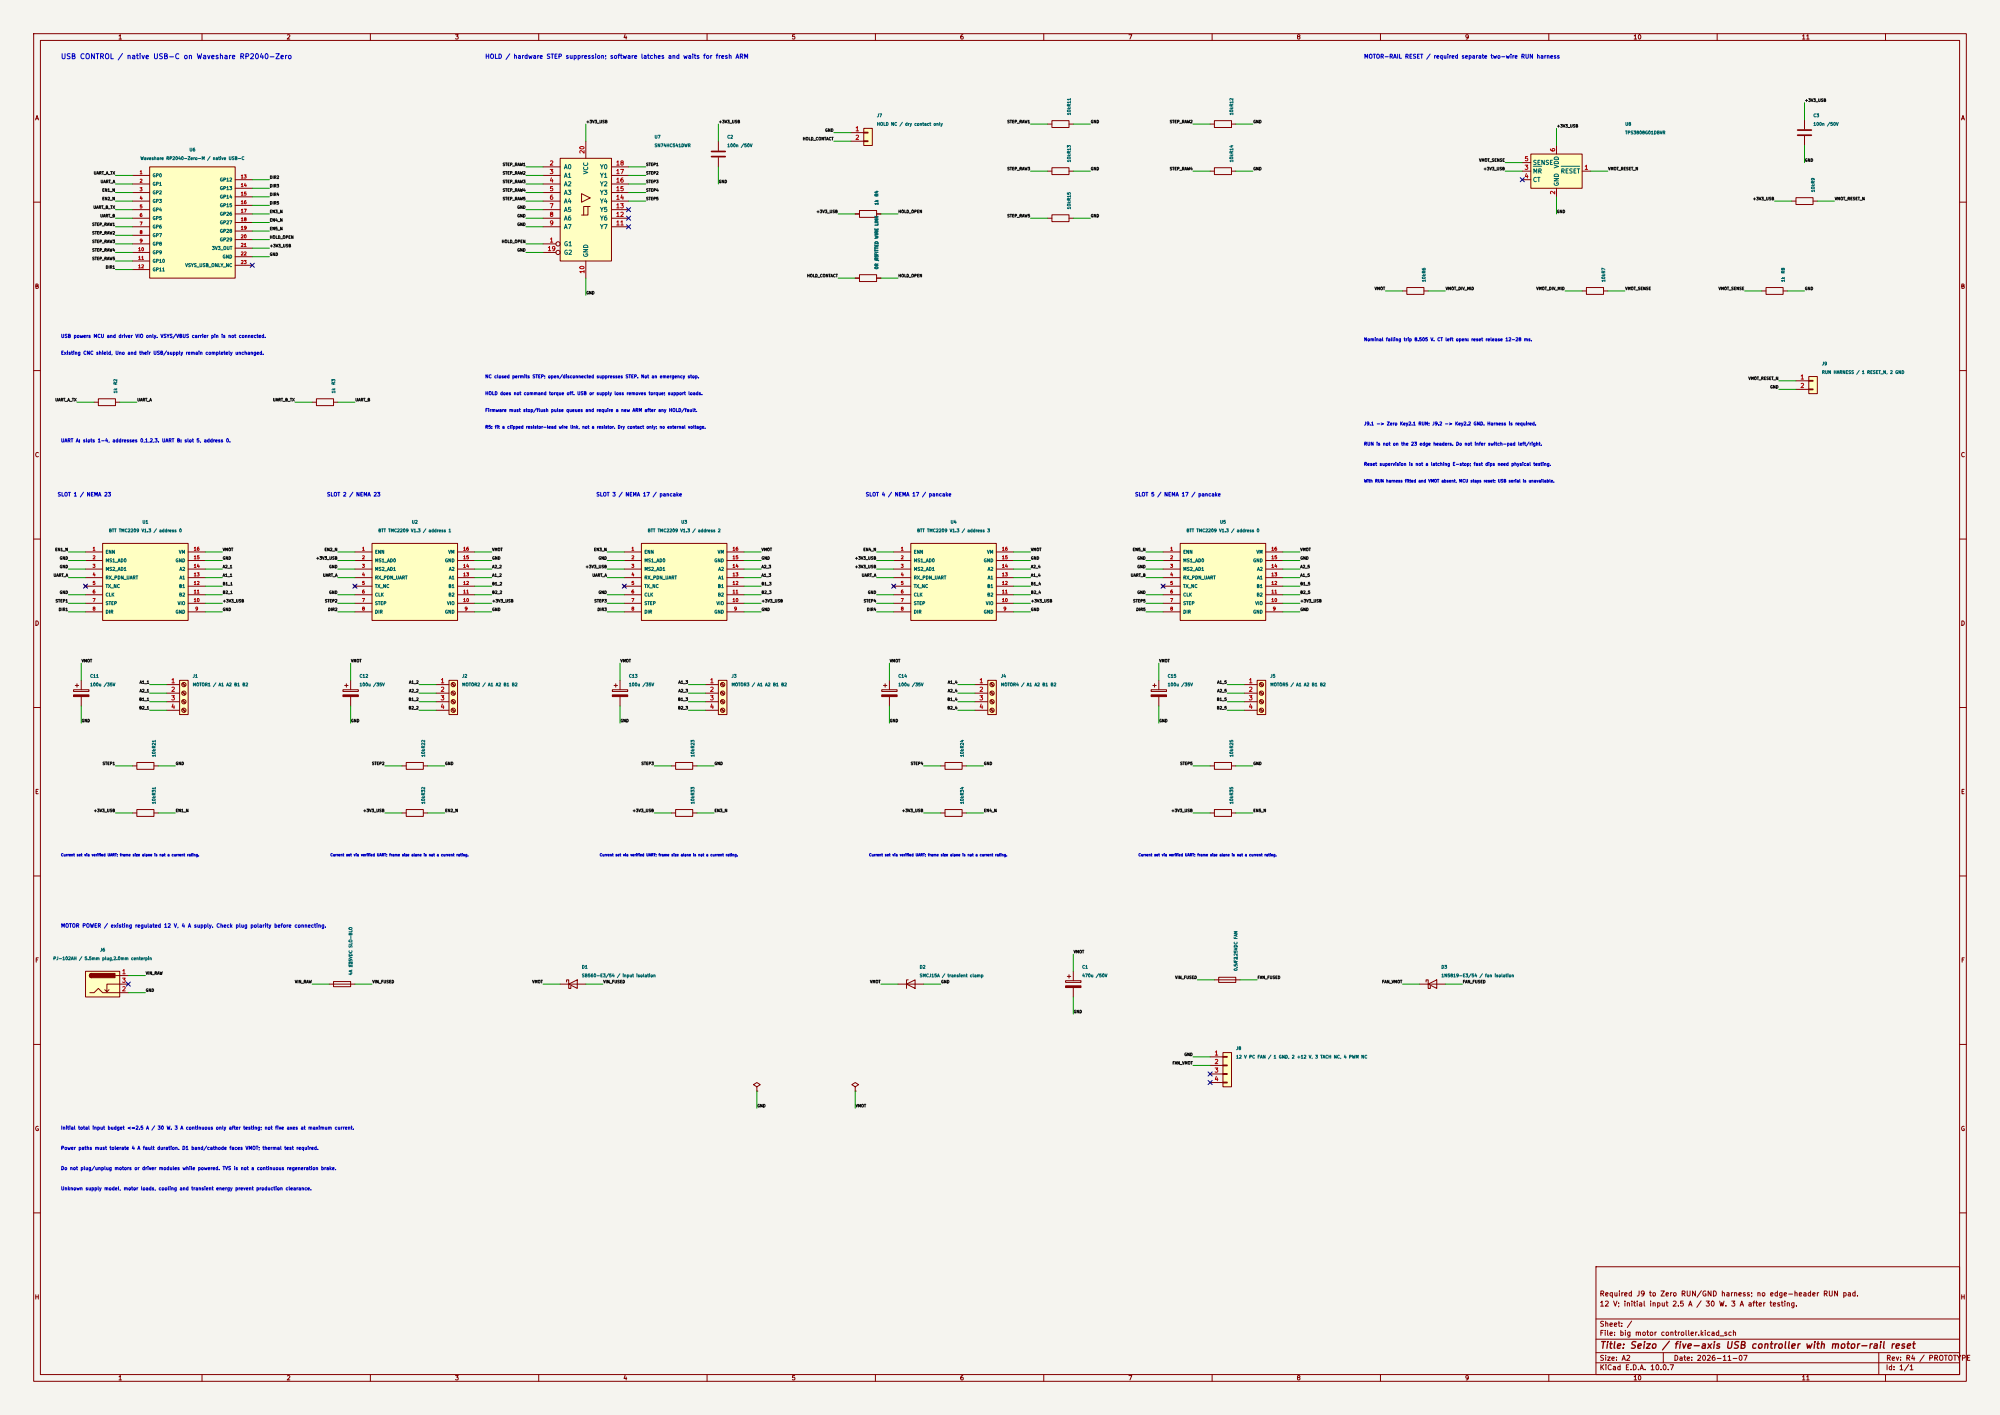
[picture p14: page 1]

USB CONTROL / native USB-C on Waveshare RP2040-Zero

HOLD / hardware STEP suppression; software latches and waits for fresh ARM

MOTOR-RAIL RESET / required separate two-wire RUN harness R4 1k R5 0R / FITTED WIRE LINK

J7HOLD NC / dry contact only

Nominal falling trip 8.505 V. CT left open: reset release 12-28 ms. J9.1 -> Zero Key2.1 RUN; J9.2 -> Key2.2 GND. Harness is required. RUN is not on the 23 edge headers. Do not infer switch-pad left/right. Reset supervision is not a latching E-stop; fast dips need physical testing. With RUN harness fitted and VMOT absent, MCU stays reset; USB serial is unavailable.

Firmware must stop/flush pulse queues and require a new ARM after any HOLD/fault. R5: fit a clipped resistor-lead wire link, not a resistor. Dry contact only; no external voltage.

Current set via verified UART; frame size alone is not a current rating. MOTOR POWER / existing regulated 12 V, 4 A supply. Check plug polarity before connecting.

Current set via verified UART; frame size alone is not a current rating. Unknown supply model, motor loads, cooling and transient energy prevent production clearance.

Current set via verified UART; frame size alone is not a current rating.

Initial total input budget <=2.5 A / 30 W. 3 A continuous only after testing; not five axes at maximum current.

Do not plug/unplug motors or driver modules while powered. TVS is not a continuous regeneration brake. Power paths must tolerate 4 A fault duration. D1 band/cathode faces VMOT; thermal test required.

Required J9 to Zero RUN/GND harness; no edge-header RUN pad.
12 V; initial input 2.5 A / 30 W. 3 A after testing.

Sheet: /
File: big motor controller.kicad_sch
Title: Seizo / five-axis USB controller with motor-rail reset
KiCad E.D.A. 10.0.7
