gmaxdragon/Seizo-Mini/motor-controller-r4-1/assembly/placement-reference-back.pdf

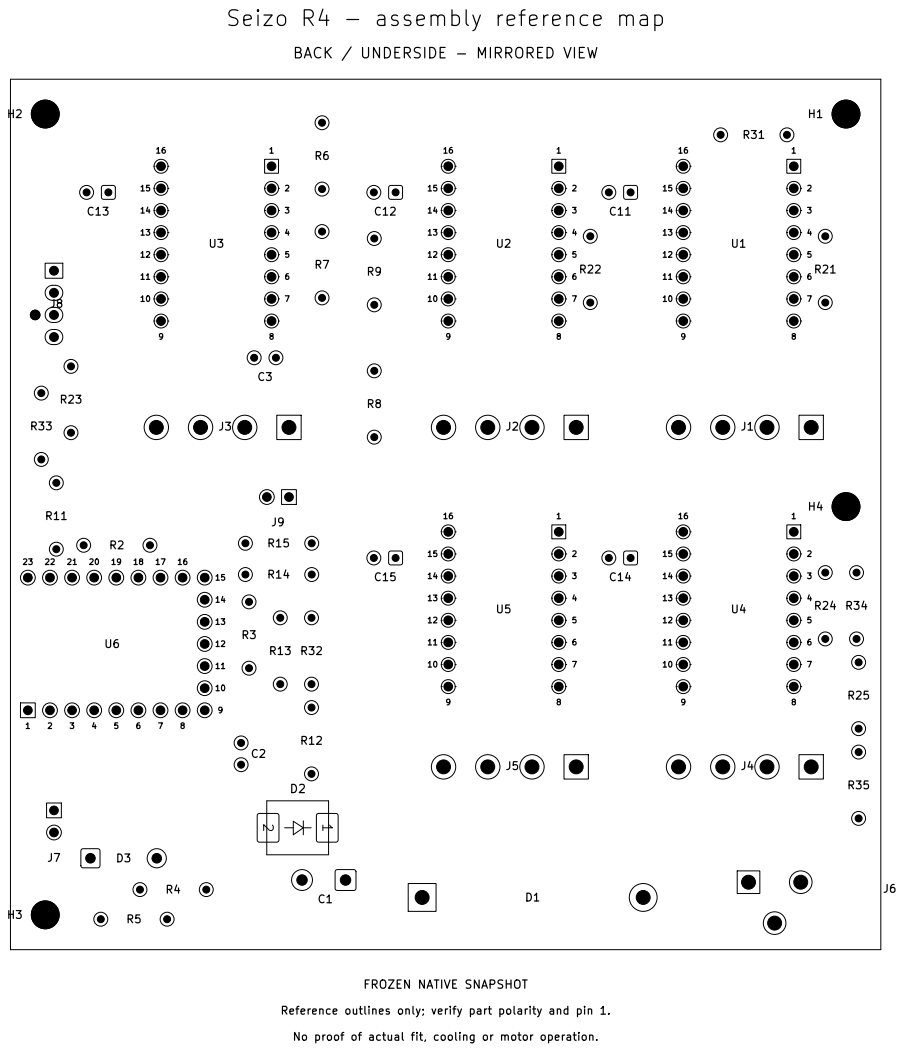
[picture p15: page 1]

BACK / UNDERSIDE - MIRRORED VIEW Seizo R4 - assembly reference map

J5 U2U5 Reference outlines only; verify part polarity and pin 1. No proof of actual fit, cooling or motor operation.
