gmaxdragon/Seizo-Mini/motor-controller-r4-1/assembly/placement-reference-front.pdf

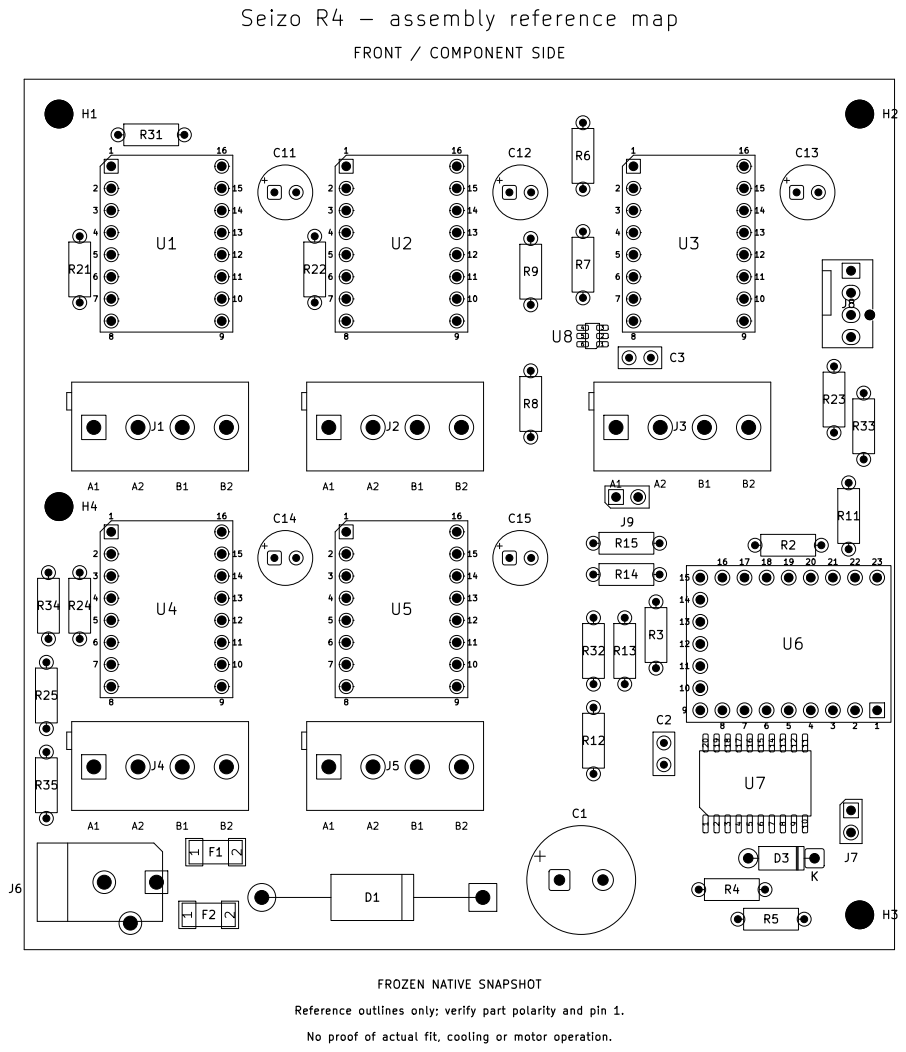
[picture p16: page 1]

FRONT / COMPONENT SIDE Seizo R4 - assembly reference map
