gmaxdragon/Seizo-Mini/(list of files, drawings)

Other design files:
motor-controller-r4/checks/pcb-mechanical-preassembly-pass.json
motor-controller-r4/checks/pcb-power-preassembly-pass.json
