gmaxdragon/Seizo-Mini/motor-controller-r4-1/project/big motor controller.kicad_pcb

## KiCad design motor-controller-r4-1/project/big motor controller.kicad_pcb (2026-11-08)

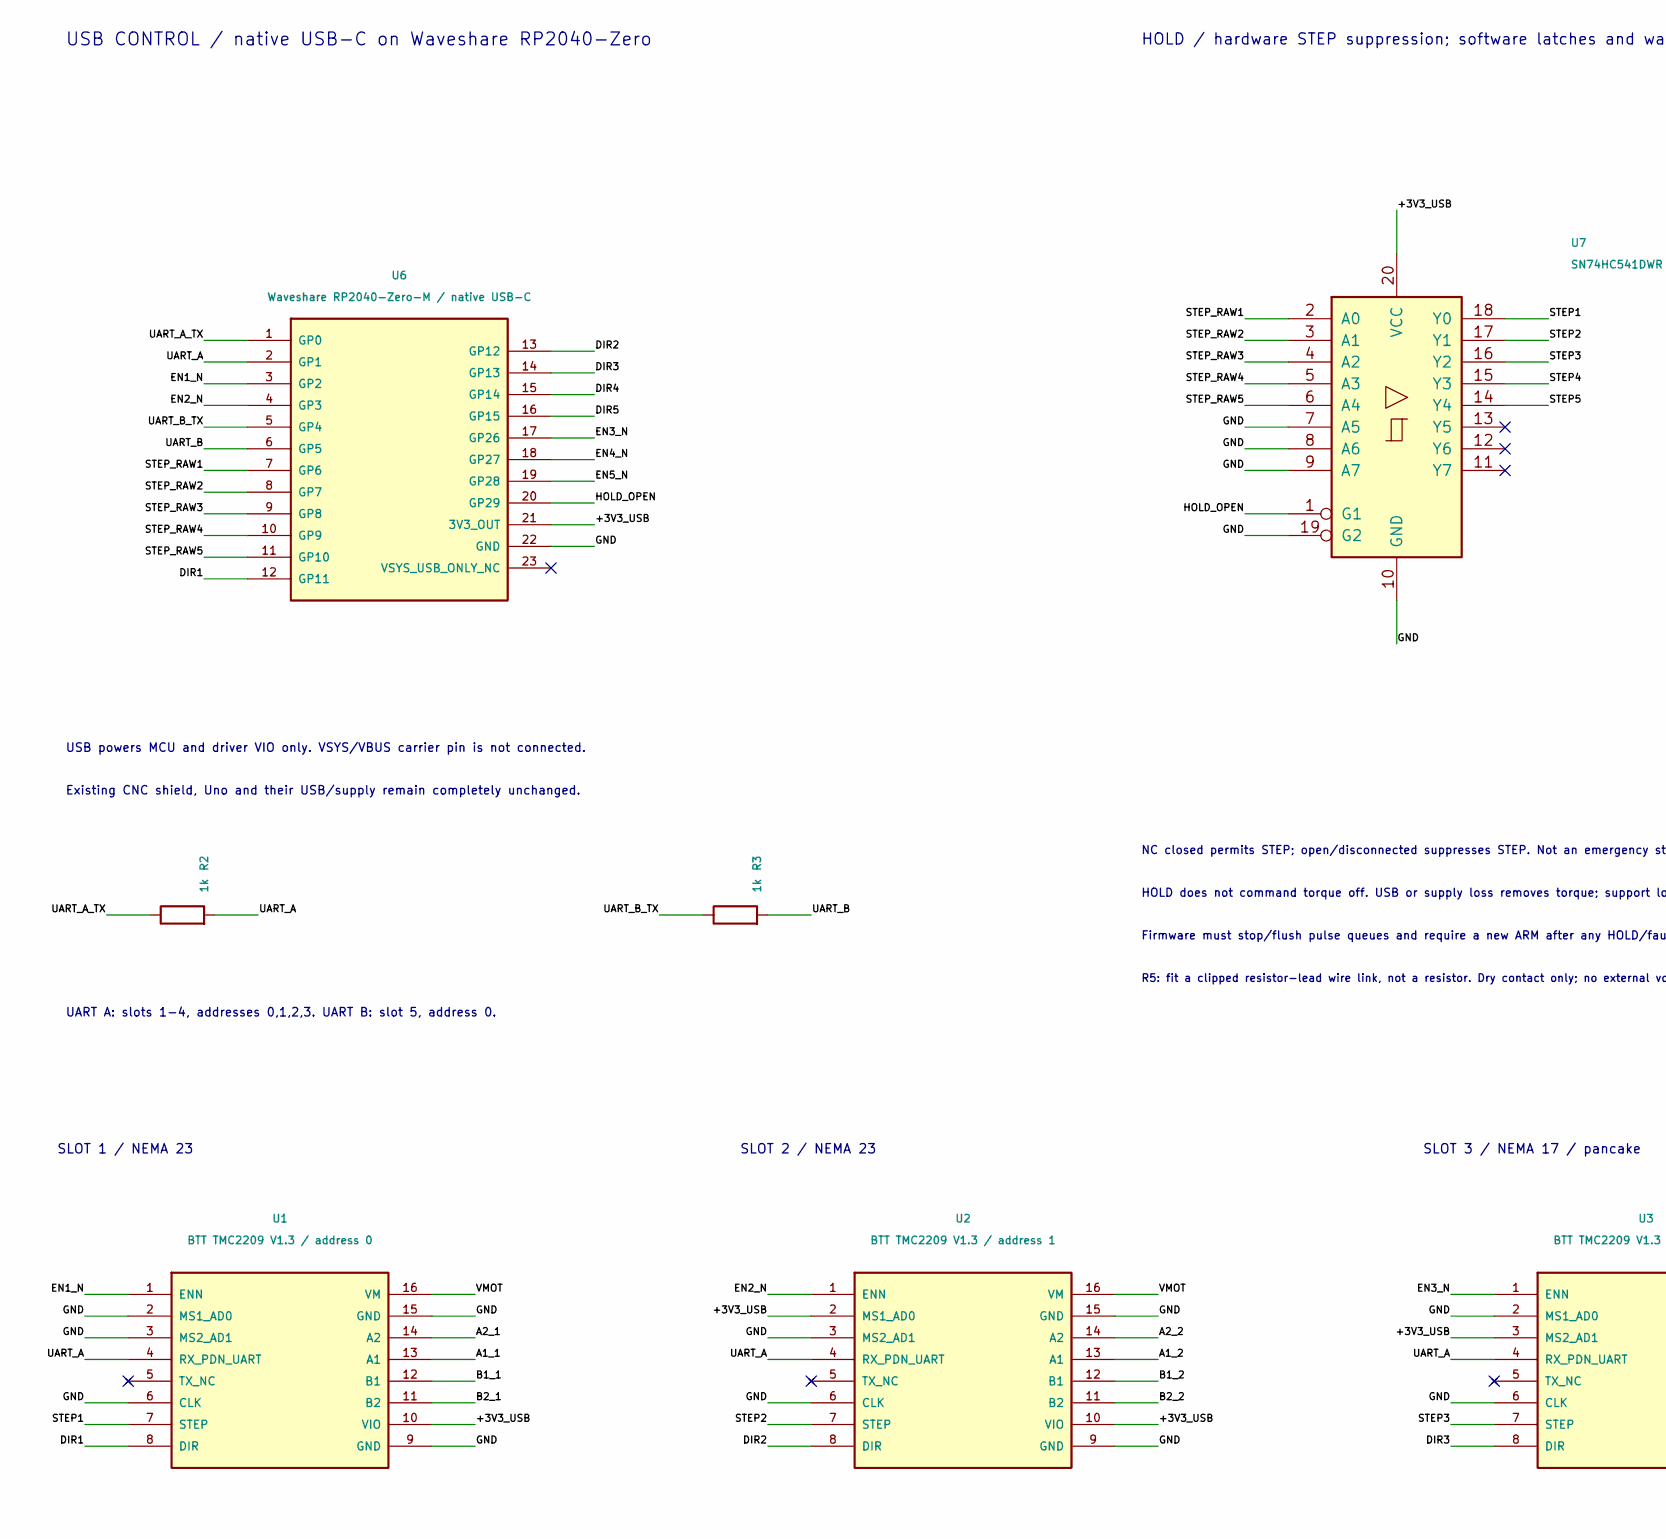
[picture p17: schematic big motor controller.kicad_sch, Seizo / five-axis USB controller with motor-rail reset, part in row 1, column 1]

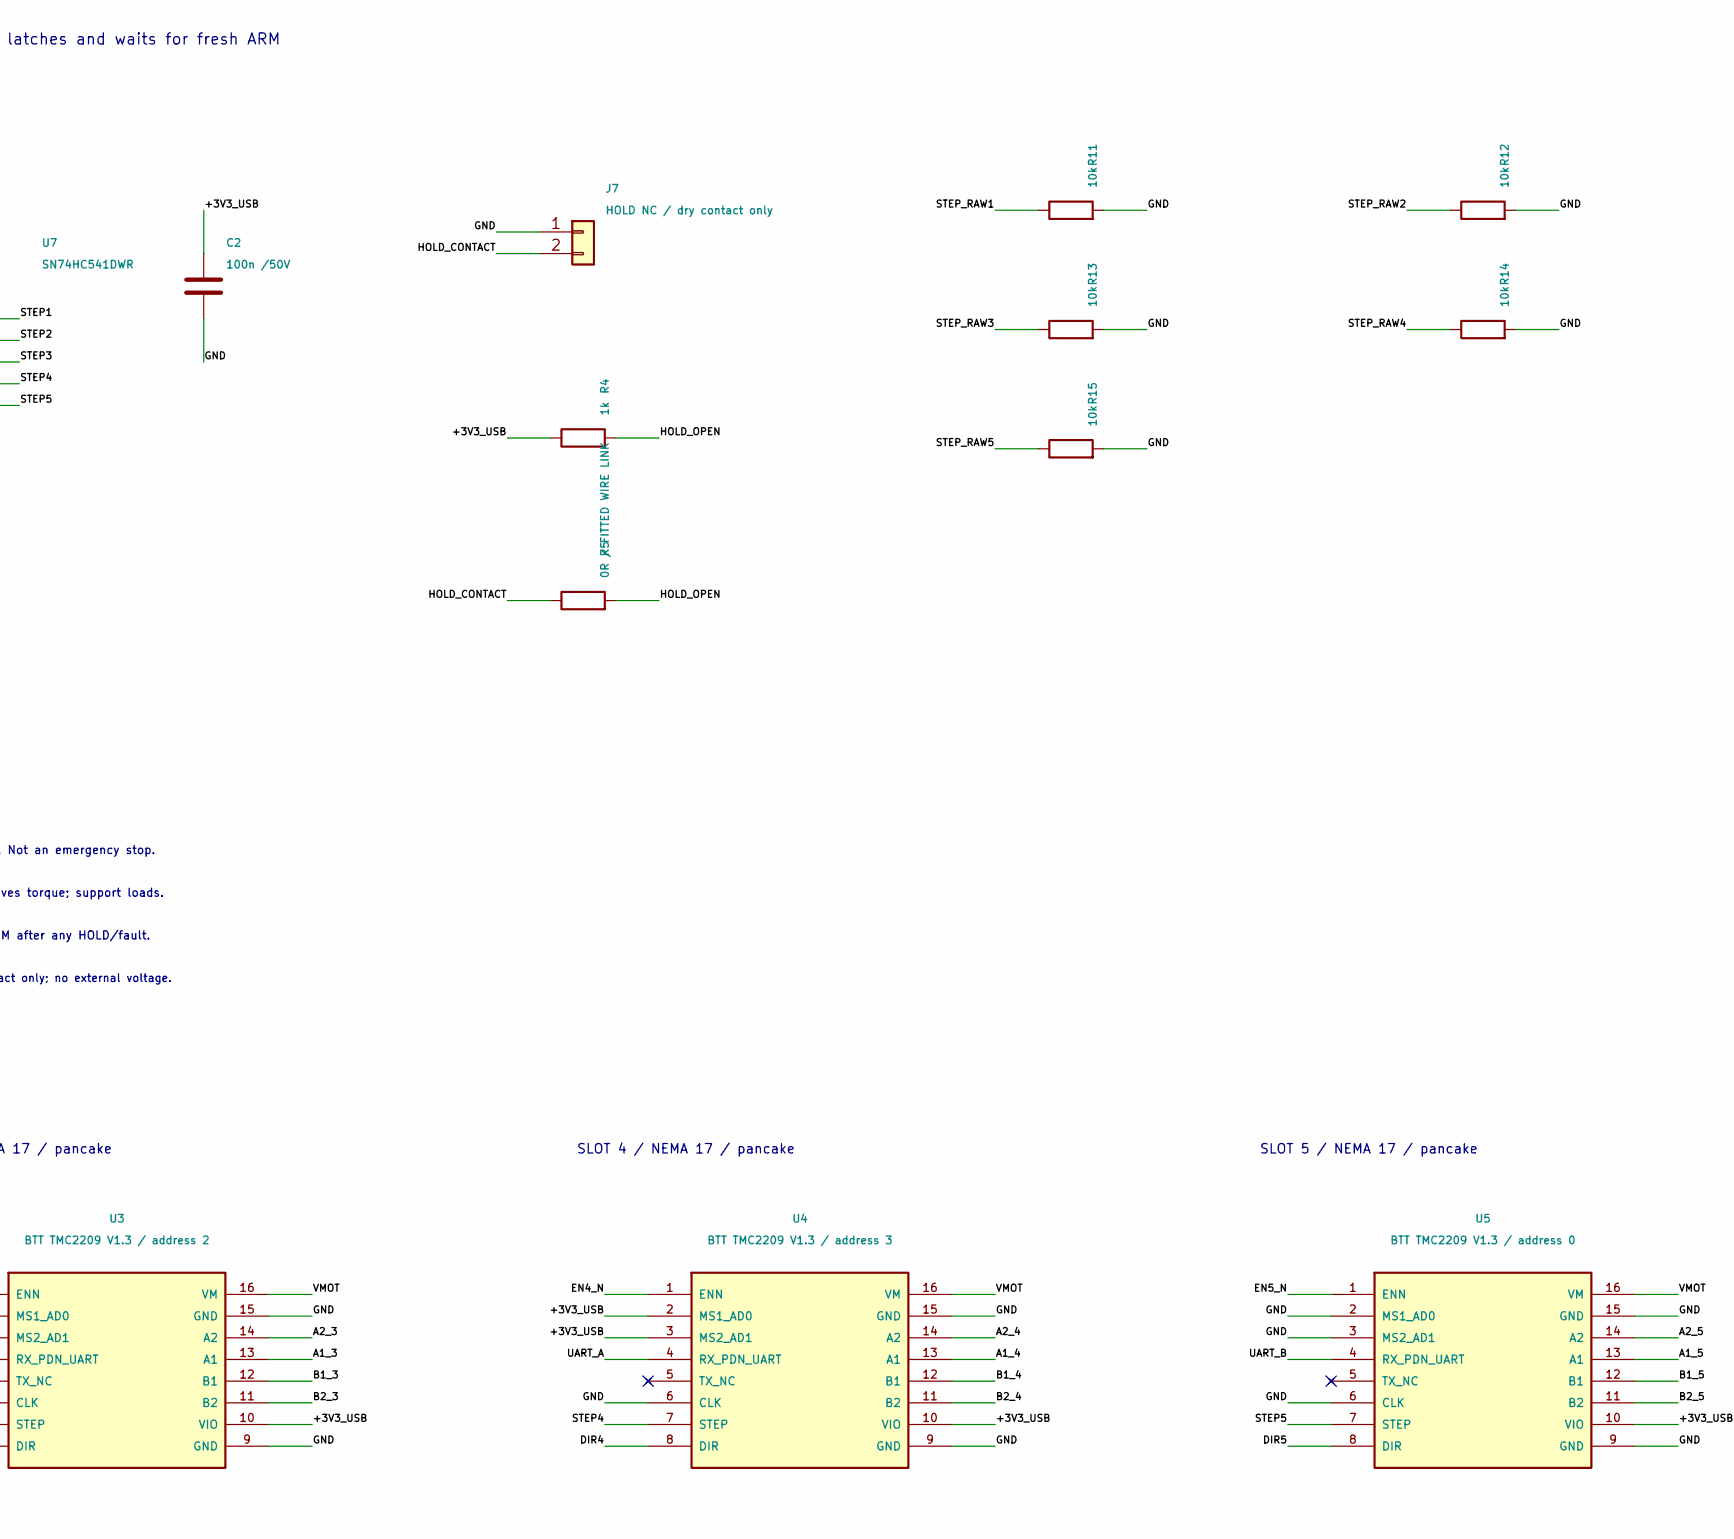
[picture p18: schematic big motor controller.kicad_sch, Seizo / five-axis USB controller with motor-rail reset, part in row 1, column 2]

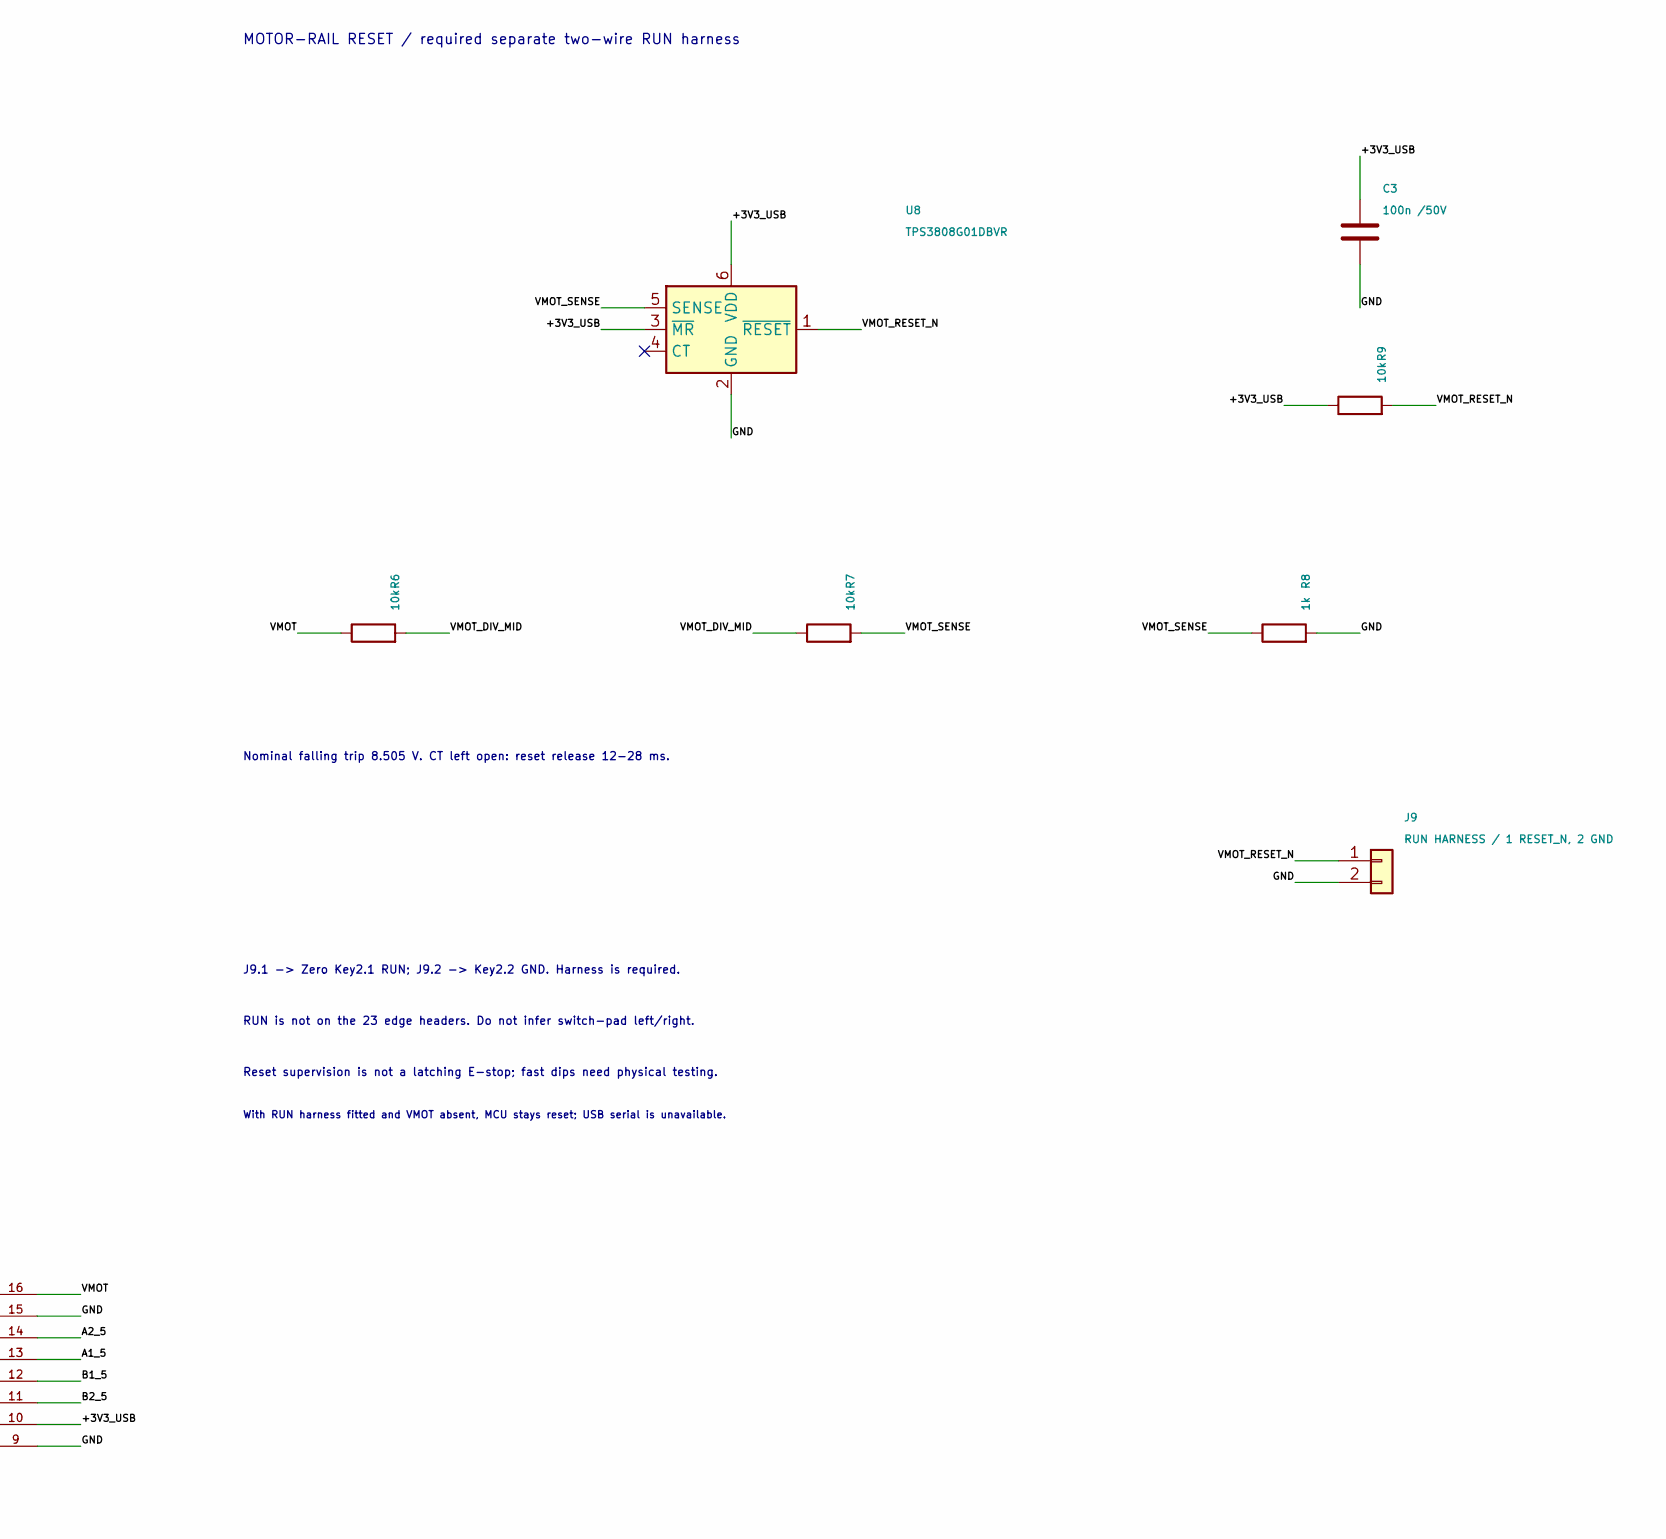
[picture p19: schematic big motor controller.kicad_sch, Seizo / five-axis USB controller with motor-rail reset, part in row 1, column 3]

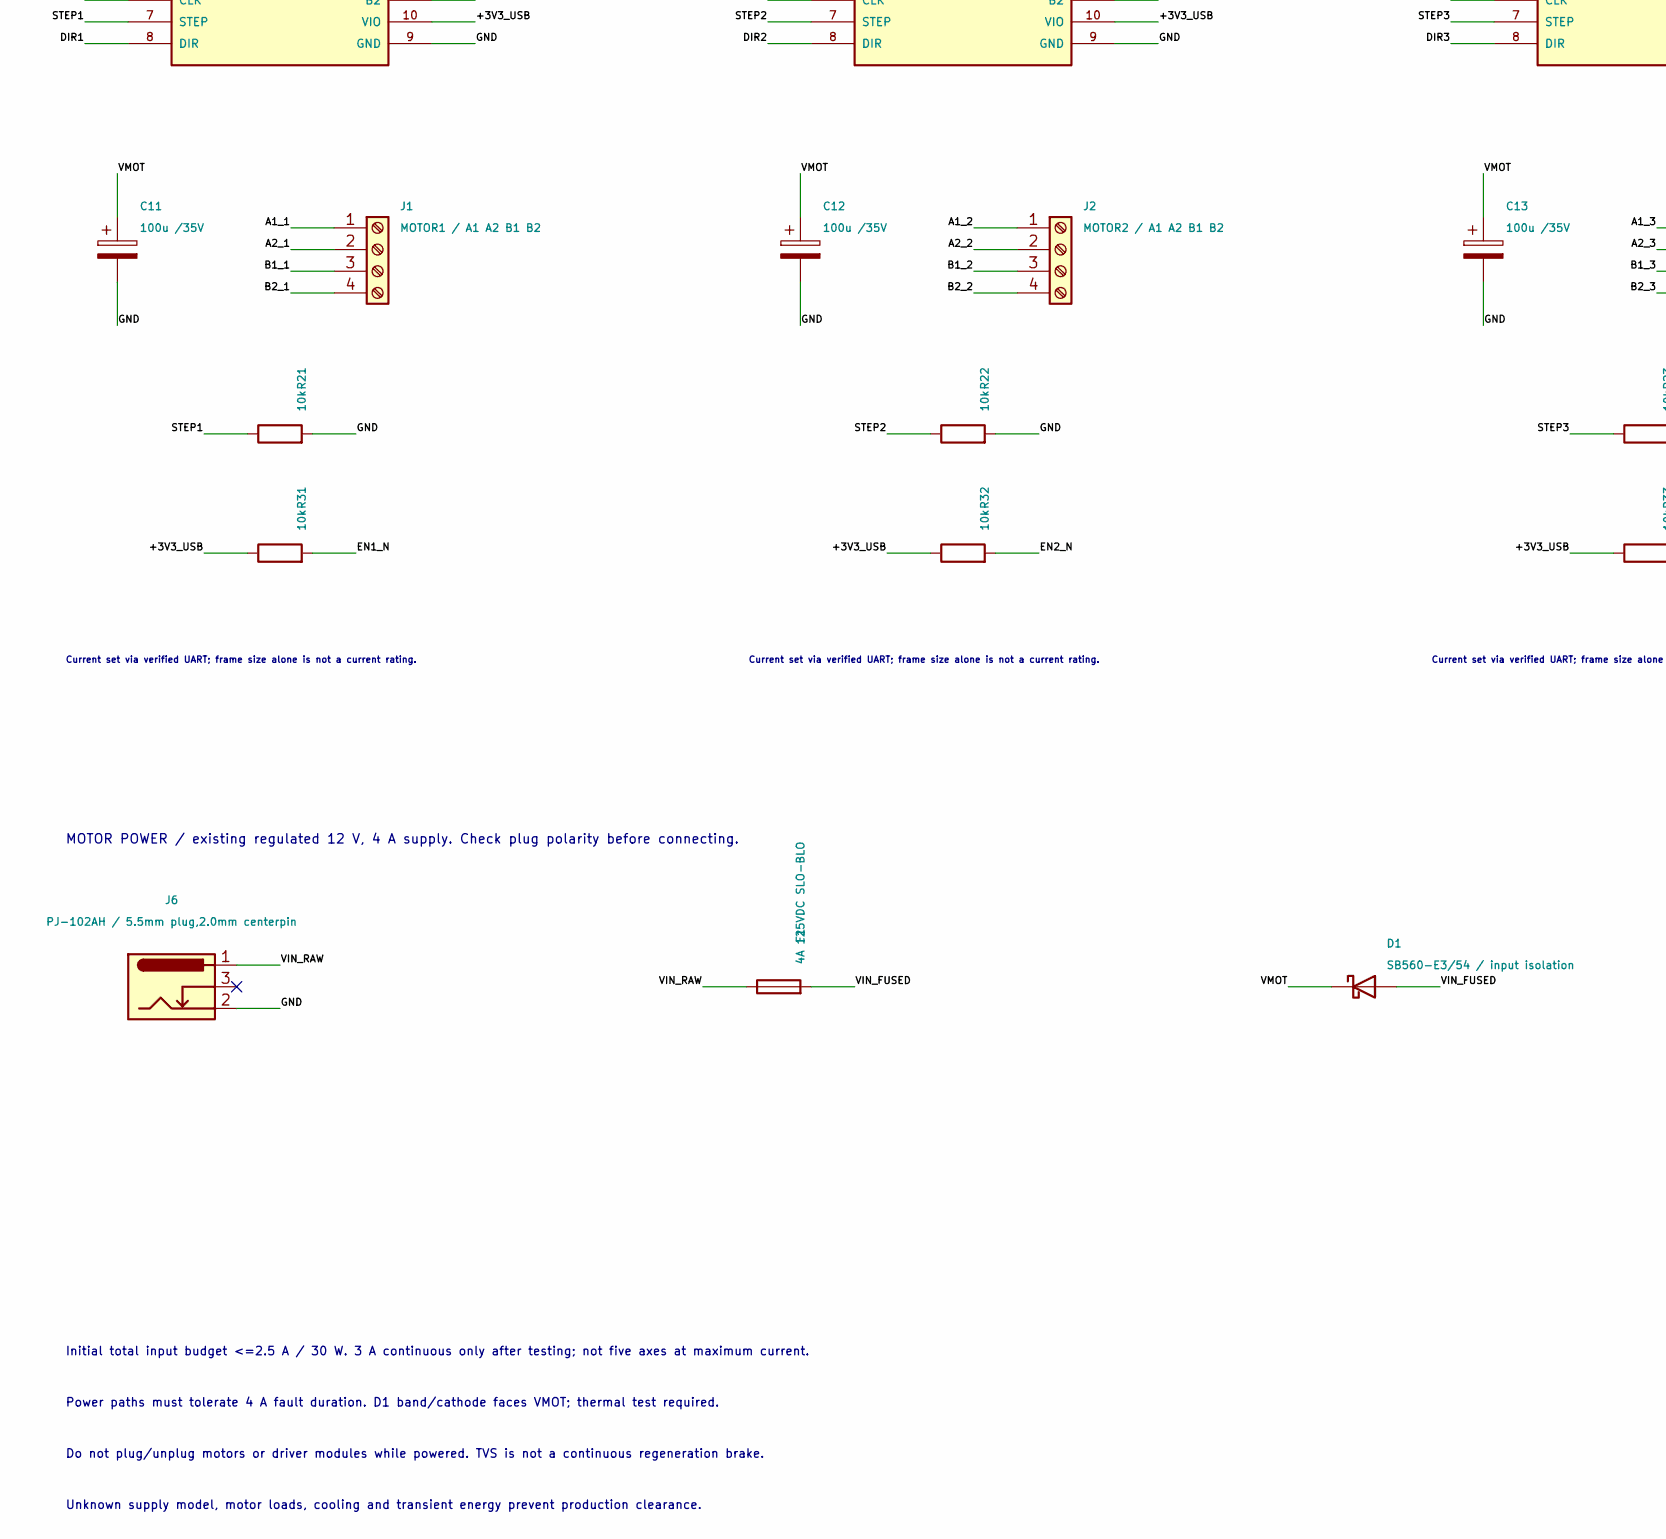
[picture p20: schematic big motor controller.kicad_sch, Seizo / five-axis USB controller with motor-rail reset, part in row 2, column 1]

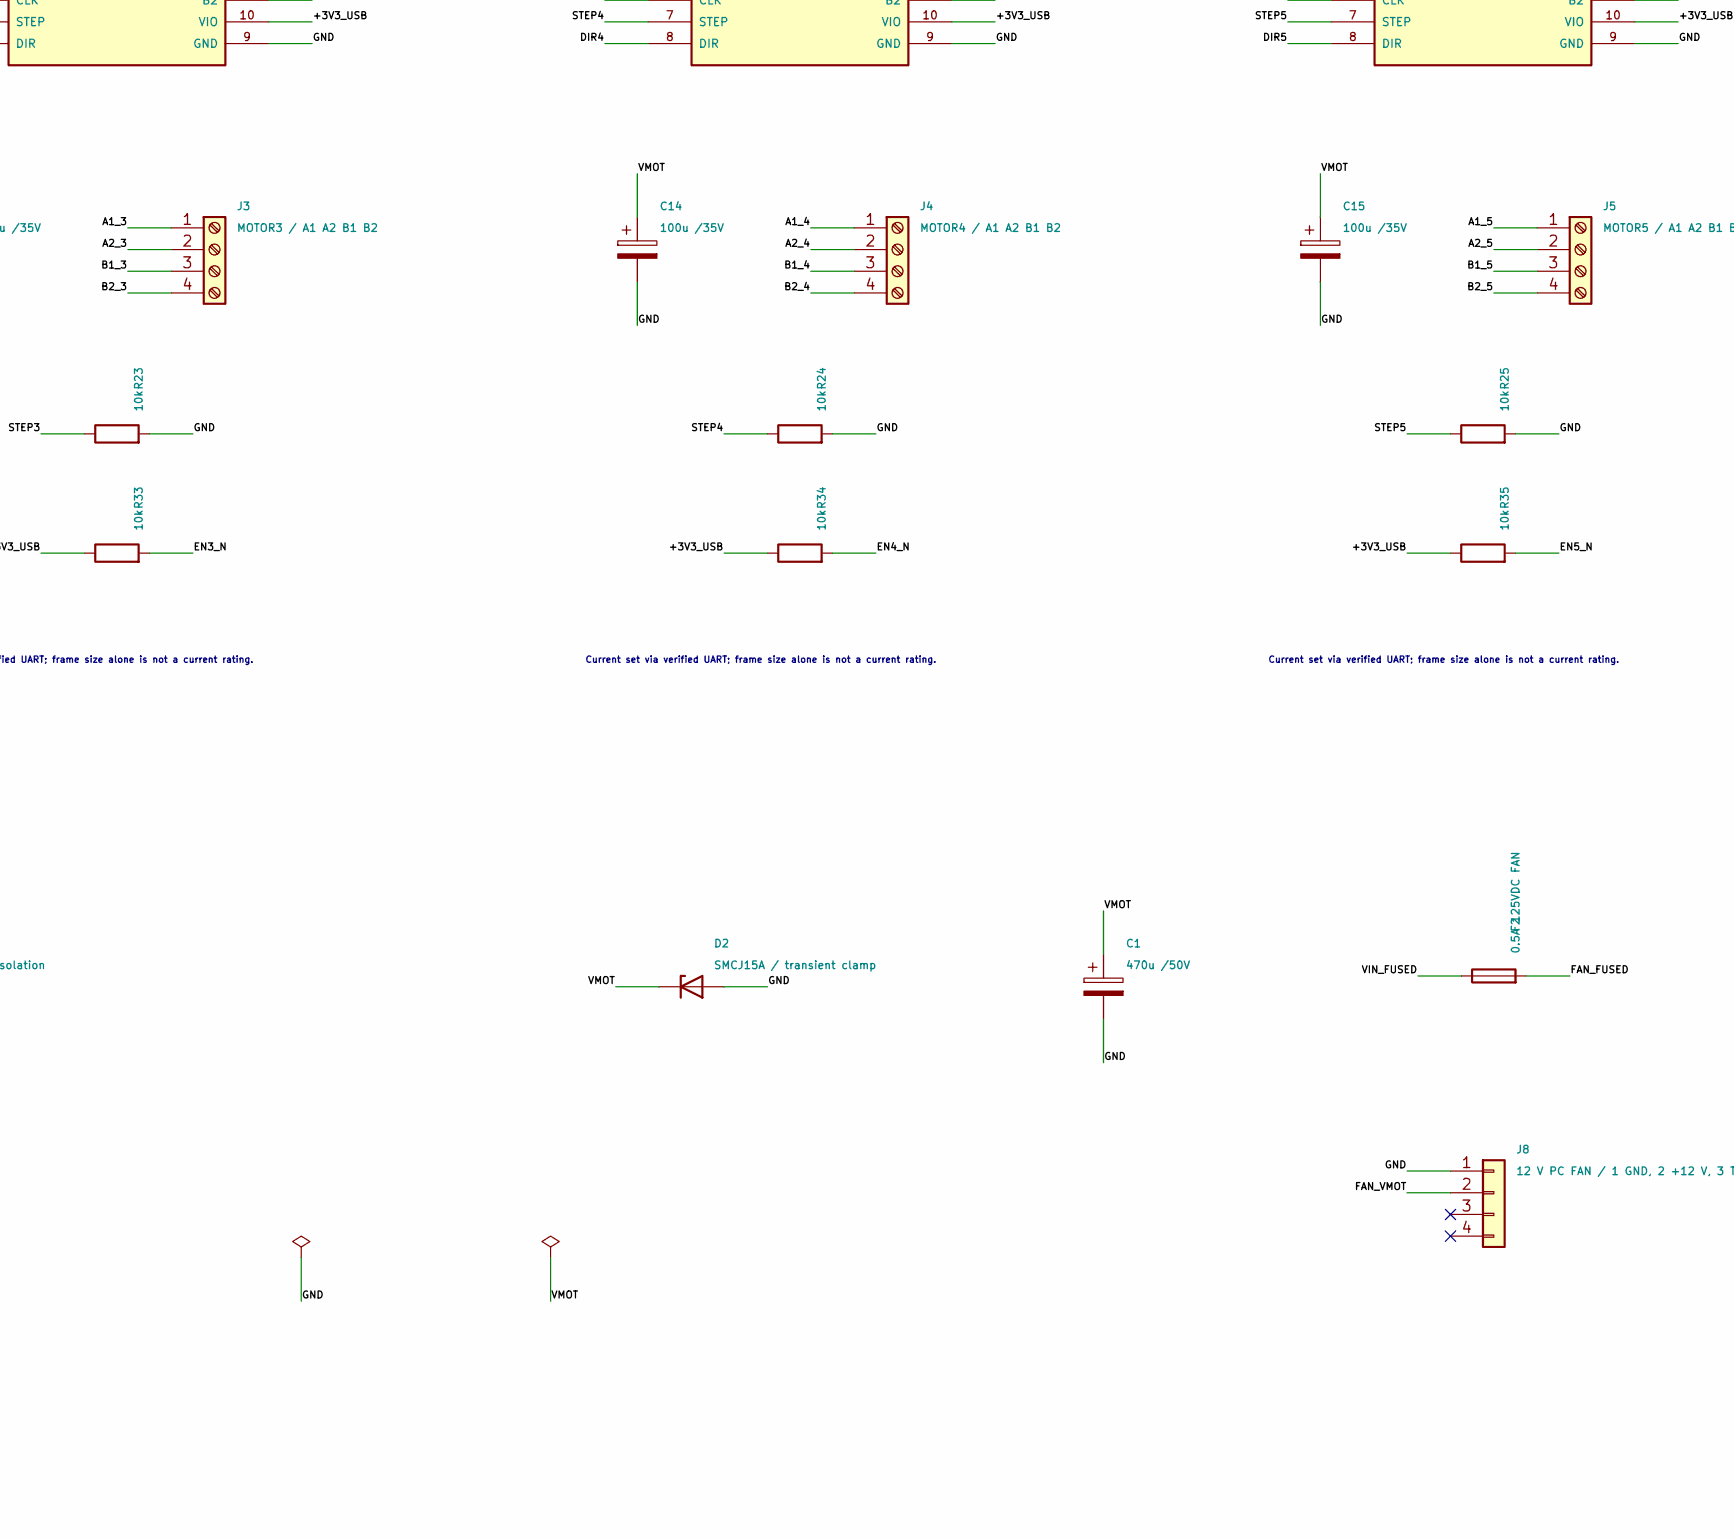
[picture p21: schematic big motor controller.kicad_sch, Seizo / five-axis USB controller with motor-rail reset, part in row 2, column 2]

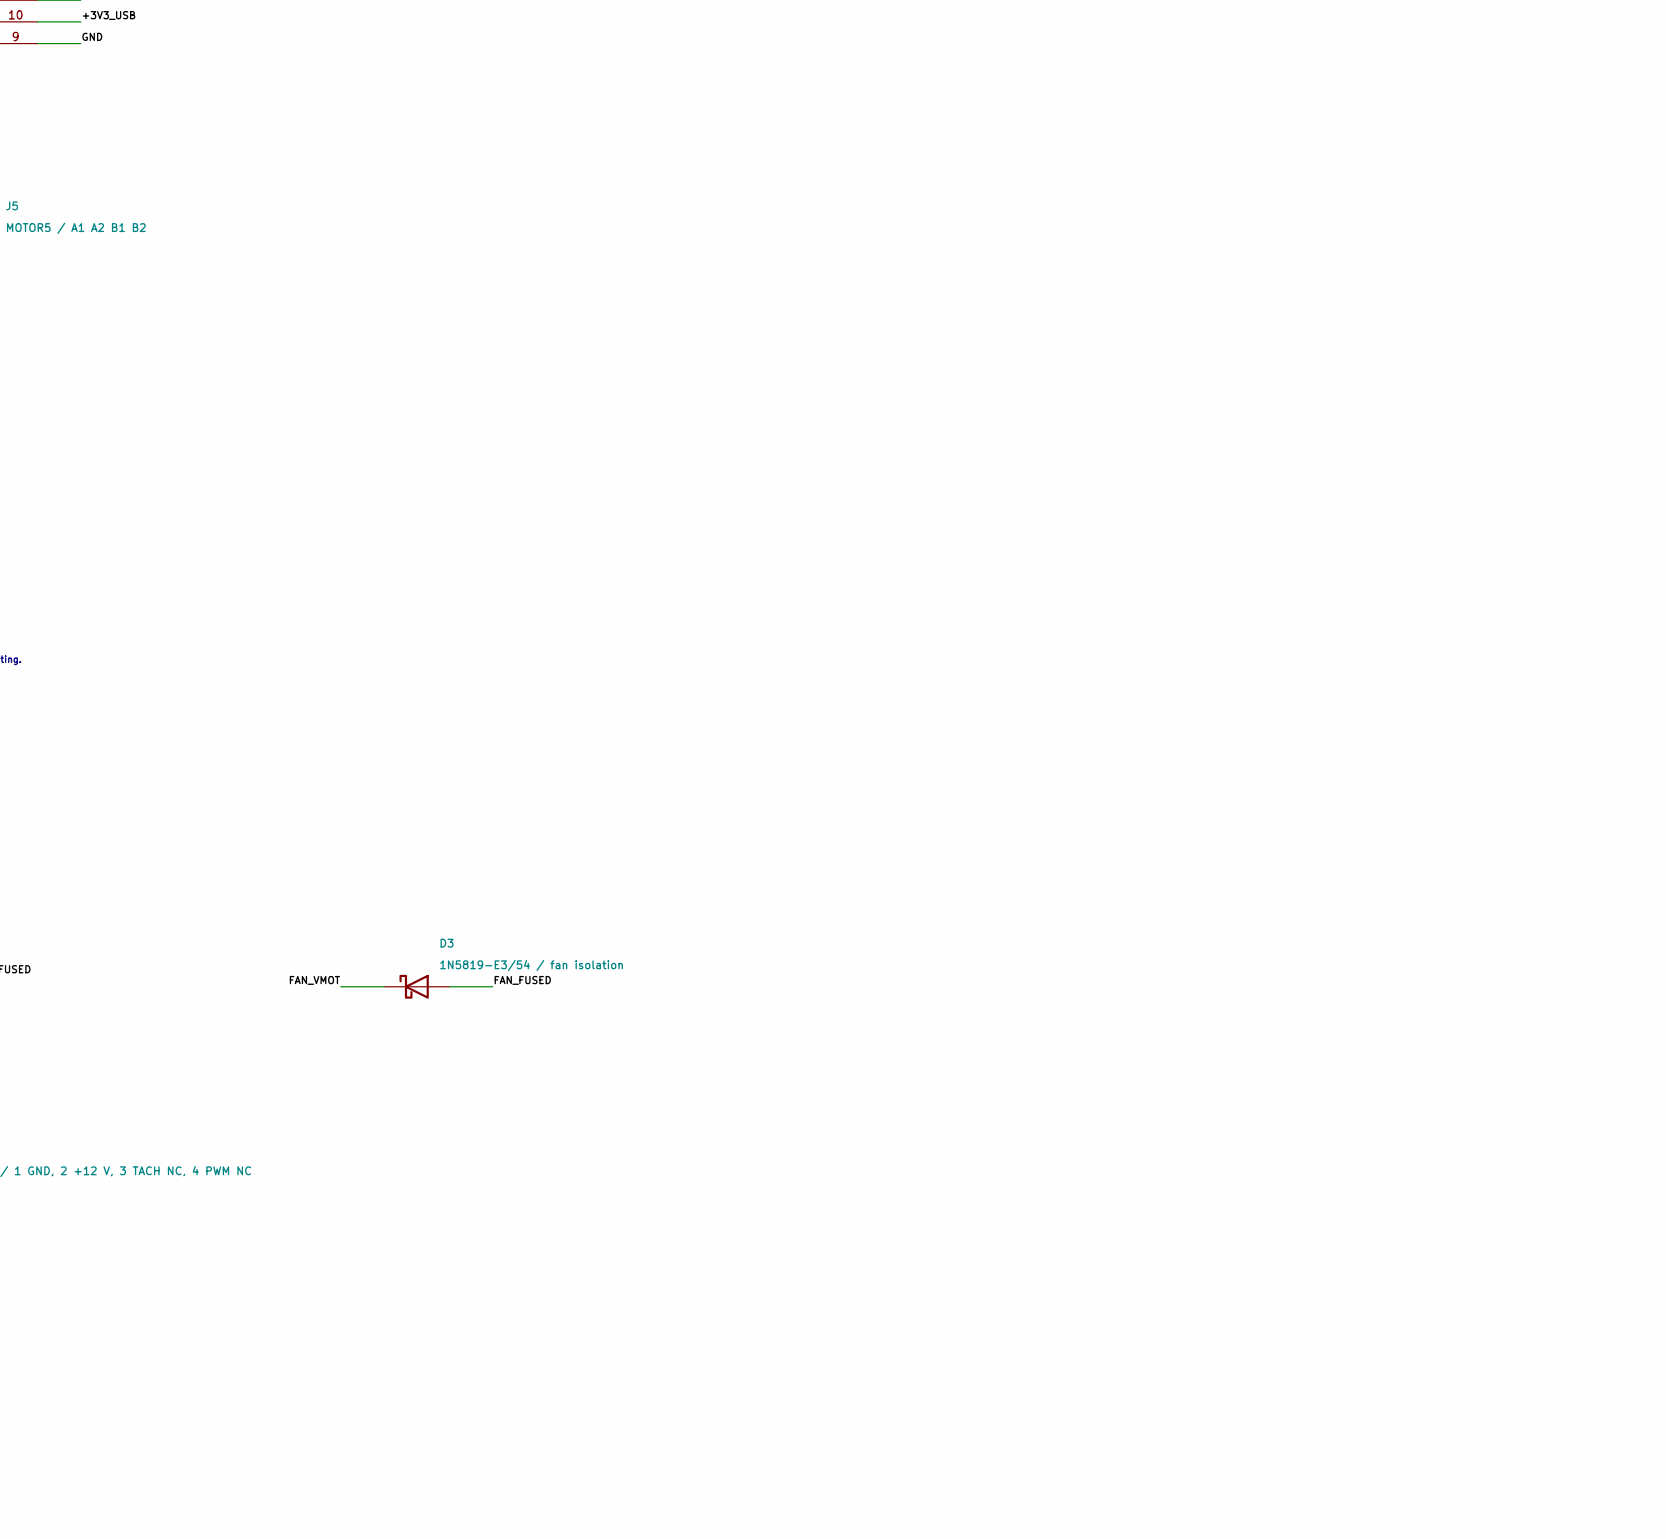
[picture p22: schematic big motor controller.kicad_sch, Seizo / five-axis USB controller with motor-rail reset, part in row 2, column 3]

Parts:
C1: 470u /50V; CP_Radial_D12.5mm_P5.00mm; MPN EEU-FR1H471
C2, C3: 100n /50V; C_Disc_D5.0mm_W2.5mm_P2.50mm; MPN RDER71H104K0S1H03A
C11, C12, C13, C14, C15: 100u /35V; CP_Radial_D6.3mm_P2.50mm; MPN 35ZLH100MEFC6.3X11
D1: SB560-E3/54 / input isolation; D_DO-201AD_P25.40mm_Horizontal_D1.60; MPN SB560-E3/54
D2: SMCJ15A / transient clamp; D_SMC; MPN SMCJ15A
D3: 1N5819-E3/54 / fan isolation; D_DO-41_SOD81_P7.62mm_Horizontal; MPN 1N5819-E3/54
F1: 4A 125VDC SLO-BLO; Fuse_Littelfuse-NANO2-451_453; MPN 0454004.MR
F2: 0.5A 125VDC FAN; Fuse_Littelfuse-NANO2-451_453; MPN 0454.500MR
J1: MOTOR1 / A1 A2 B1 B2; TerminalBlock_DORABO_DB128V_1x04_P5.08mm_D1.60; MPN DB128V-5.08-4P-GN-S
J2: MOTOR2 / A1 A2 B1 B2; TerminalBlock_DORABO_DB128V_1x04_P5.08mm_D1.60; MPN DB128V-5.08-4P-GN-S
J3: MOTOR3 / A1 A2 B1 B2; TerminalBlock_DORABO_DB128V_1x04_P5.08mm_D1.60; MPN DB128V-5.08-4P-GN-S
J4: MOTOR4 / A1 A2 B1 B2; TerminalBlock_DORABO_DB128V_1x04_P5.08mm_D1.60; MPN DB128V-5.08-4P-GN-S
J5: MOTOR5 / A1 A2 B1 B2; TerminalBlock_DORABO_DB128V_1x04_P5.08mm_D1.60; MPN DB128V-5.08-4P-GN-S
J6: PJ-102AH / 5.5mm plug,2.0mm centerpin; BarrelJack_CUI_PJ-102AH_Horizontal; MPN PJ-102AH
J7: HOLD NC / dry contact only; PinHeader_1x02_P2.54mm_Vertical; MPN B-2100S02P-A110
J8: 12 V PC FAN / 1 GND, 2 +12 V, 3 TACH NC, 4 PWM NC; FanPinHeader_1x04_P2.54mm_Vertical; MPN 470531000
J9: RUN HARNESS / 1 RESET_N, 2 GND; PinHeader_1x02_P2.54mm_Vertical; MPN B-2100S02P-A110
R2, R3, R4, R8: 1k; R_Axial_DIN0207_L6.3mm_D2.5mm_P7.62mm_Horizontal; MPN MFR-25FTE52-1K
R5: 0R / FITTED WIRE LINK; R_Axial_DIN0207_L6.3mm_D2.5mm_P7.62mm_Horizontal; MPN Assembly link - tinned resistor-lead of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
R6, R7, R9, R11, R12, R13, R14, R15, R21, R22, R23, R24, R25, R31, R32, R33, R34, R35: 10k; R_Axial_DIN0207_L6.3mm_D2.5mm_P7.62mm_Horizontal; MPN MFR-25FBF52-10K
U1, U5: BTT TMC2209 V1.3 / address 0; StepStick_Socket16_P12.70_D1.00; MPN BIGTREETECH TMC2209 V1.3
U2: BTT TMC2209 V1.3 / address 1; StepStick_Socket16_P12.70_D1.00; MPN BIGTREETECH TMC2209 V1.3
U3: BTT TMC2209 V1.3 / address 2; StepStick_Socket16_P12.70_D1.00; MPN BIGTREETECH TMC2209 V1.3
U4: BTT TMC2209 V1.3 / address 3; StepStick_Socket16_P12.70_D1.00; MPN BIGTREETECH TMC2209 V1.3
U6: Waveshare RP2040-Zero-M / native USB-C; Waveshare_RP2040_Zero_Headers_9_9_5_P2.54; MPN Waveshare RP2040-Zero-M
U7: SN74HC541DWR; SOIC-20W_7.5x12.8mm_P1.27mm; MPN SN74HC541DWR
U8: TPS3808G01DBVR; SOT-23-6; MPN TPS3808G01DBVR

Connections:
/+3V3_USB: C2.1, C3.1, R4.1, R9.1, R31.1, R32.1, R33.1, R34.1, R35.1, U1.10 (VIO), U2.2 (MS1_AD0), U2.10 (VIO), U3.3 (MS2_AD1), U3.10 (VIO), U4.2 (MS1_AD0), U4.3 (MS2_AD1), U4.10 (VIO), U5.10 (VIO), U6.21 (3V3_OUT), U7.20 (VCC), U8.3 (~MR), U8.6 (VDD)
/A1_1: J1.1, U1.13 (A1)
/A1_2: J2.1, U2.13 (A1)
/A1_3: J3.1, U3.13 (A1)
/A1_4: J4.1, U4.13 (A1)
/A1_5: J5.1, U5.13 (A1)
/A2_1: J1.2, U1.14 (A2)
/A2_2: J2.2, U2.14 (A2)
/A2_3: J3.2, U3.14 (A2)
/A2_4: J4.2, U4.14 (A2)
/A2_5: J5.2, U5.14 (A2)
/B1_1: J1.3, U1.12 (B1)
/B1_2: J2.3, U2.12 (B1)
/B1_3: J3.3, U3.12 (B1)
/B1_4: J4.3, U4.12 (B1)
/B1_5: J5.3, U5.12 (B1)
/B2_1: J1.4, U1.11 (B2)
/B2_2: J2.4, U2.11 (B2)
/B2_3: J3.4, U3.11 (B2)
/B2_4: J4.4, U4.11 (B2)
/B2_5: J5.4, U5.11 (B2)
/DIR1: U1.8 (DIR), U6.12 (GP11)
/DIR2: U2.8 (DIR), U6.13 (GP12)
/DIR3: U3.8 (DIR), U6.14 (GP13)
/DIR4: U4.8 (DIR), U6.15 (GP14)
/DIR5: U5.8 (DIR), U6.16 (GP15)
/EN1_N: R31.2, U1.1 (ENN), U6.3 (GP2)
/EN2_N: R32.2, U2.1 (ENN), U6.4 (GP3)
/EN3_N: R33.2, U3.1 (ENN), U6.17 (GP26)
/EN4_N: R34.2, U4.1 (ENN), U6.18 (GP27)
/EN5_N: R35.2, U5.1 (ENN), U6.19 (GP28)
/FAN_FUSED: D3.2 (A), F2.2
/FAN_VMOT: D3.1 (K), J8.2
/GND: C1.2, C2.2, C3.2, C11.2, C12.2, C13.2, C14.2, C15.2, D2.2 (A), J6.2, J7.1, J8.1, J9.2, R8.2, R11.2, R12.2, R13.2, R14.2, R15.2, R21.2, R22.2, R23.2, R24.2, R25.2, U1.2 (MS1_AD0), U1.3 (MS2_AD1), U1.6 (CLK), U1.9 (GND), U1.15 (GND), U2.3 (MS2_AD1), U2.6 (CLK), U2.9 (GND), U2.15 (GND), U3.2 (MS1_AD0), U3.6 (CLK), U3.9 (GND), U3.15 (GND), U4.6 (CLK), U4.9 (GND), U4.15 (GND), U5.2 (MS1_AD0), U5.3 (MS2_AD1), U5.6 (CLK), U5.9 (GND), U5.15 (GND), U6.22 (GND), U7.7 (A5), U7.8 (A6), U7.9 (A7), U7.10 (GND), U7.19 (G2), U8.2 (GND)
/HOLD_CONTACT: J7.2, R5.1
/HOLD_OPEN: R4.2, R5.2, U6.20 (GP29), U7.1 (G1)
/STEP1: R21.1, U1.7 (STEP), U7.18 (Y0)
/STEP2: R22.1, U2.7 (STEP), U7.17 (Y1)
/STEP3: R23.1, U3.7 (STEP), U7.16 (Y2)
/STEP4: R24.1, U4.7 (STEP), U7.15 (Y3)
/STEP5: R25.1, U5.7 (STEP), U7.14 (Y4)
/STEP_RAW1: R11.1, U6.7 (GP6), U7.2 (A0)
/STEP_RAW2: R12.1, U6.8 (GP7), U7.3 (A1)
/STEP_RAW3: R13.1, U6.9 (GP8), U7.4 (A2)
/STEP_RAW4: R14.1, U6.10 (GP9), U7.5 (A3)
/STEP_RAW5: R15.1, U6.11 (GP10), U7.6 (A4)
/UART_A: R2.2, U1.4 (RX_PDN_UART), U2.4 (RX_PDN_UART), U3.4 (RX_PDN_UART), U4.4 (RX_PDN_UART), U6.2 (GP1)
/UART_A_TX: R2.1, U6.1 (GP0)
/UART_B: R3.2, U5.4 (RX_PDN_UART), U6.6 (GP5)
/UART_B_TX: R3.1, U6.5 (GP4)
/VIN_FUSED: D1.2 (A), F1.2, F2.1
/VIN_RAW: F1.1, J6.1
/VMOT: C1.1, C11.1, C12.1, C13.1, C14.1, C15.1, D1.1 (K), D2.1 (K), R6.1, U1.16 (VM), U2.16 (VM), U3.16 (VM), U4.16 (VM), U5.16 (VM)
/VMOT_DIV_MID: R6.2, R7.1
/VMOT_RESET_N: J9.1, R9.2, U8.1 (~RESET)
/VMOT_SENSE: R7.2, R8.1, U8.5 (SENSE)

Notes on the sheet:
USB CONTROL / native USB-C on Waveshare RP2040-Zero
USB powers MCU and driver VIO only. VSYS/VBUS carrier pin is not connected.
Existing CNC shield, Uno and their USB/supply remain completely unchanged.
UART A: slots 1-4, addresses 0,1,2,3. UART B: slot 5, address 0.
HOLD / hardware STEP suppression; software latches and waits for fresh ARM
NC closed permits STEP; open/disconnected suppresses STEP. Not an emergency stop.
HOLD does not command torque off. USB or supply loss removes torque; support loads.
Firmware must stop/flush pulse queues and require a new ARM after any HOLD/fault.
R5: fit a clipped resistor-lead wire link, not a resistor. Dry contact only; no external voltage.
MOTOR-RAIL RESET / required separate two-wire RUN harness
Nominal falling trip 8.505 V. CT left open: reset release 12-28 ms.
J9.1 -> Zero Key2.1 RUN; J9.2 -> Key2.2 GND. Harness is required.
RUN is not on the 23 edge headers. Do not infer switch-pad left/right.
Reset supervision is not a latching E-stop; fast dips need physical testing.
With RUN harness fitted and VMOT absent, MCU stays reset; USB serial is unavailable.
SLOT 1 / NEMA 23
Current set via verified UART; frame size alone is not a current rating.
SLOT 2 / NEMA 23
SLOT 3 / NEMA 17 / pancake
SLOT 4 / NEMA 17 / pancake
SLOT 5 / NEMA 17 / pancake
MOTOR POWER / existing regulated 12 V, 4 A supply. Check plug polarity before connecting.
Initial total input budget <=2.5 A / 30 W. 3 A continuous only after testing; not five axes at maximum current.
Power paths must tolerate 4 A fault duration. D1 band/cathode faces VMOT; thermal test required.
Do not plug/unplug motors or driver modules while powered. TVS is not a continuous regeneration brake.
Unknown supply model, motor loads, cooling and transient energy prevent production clearance.

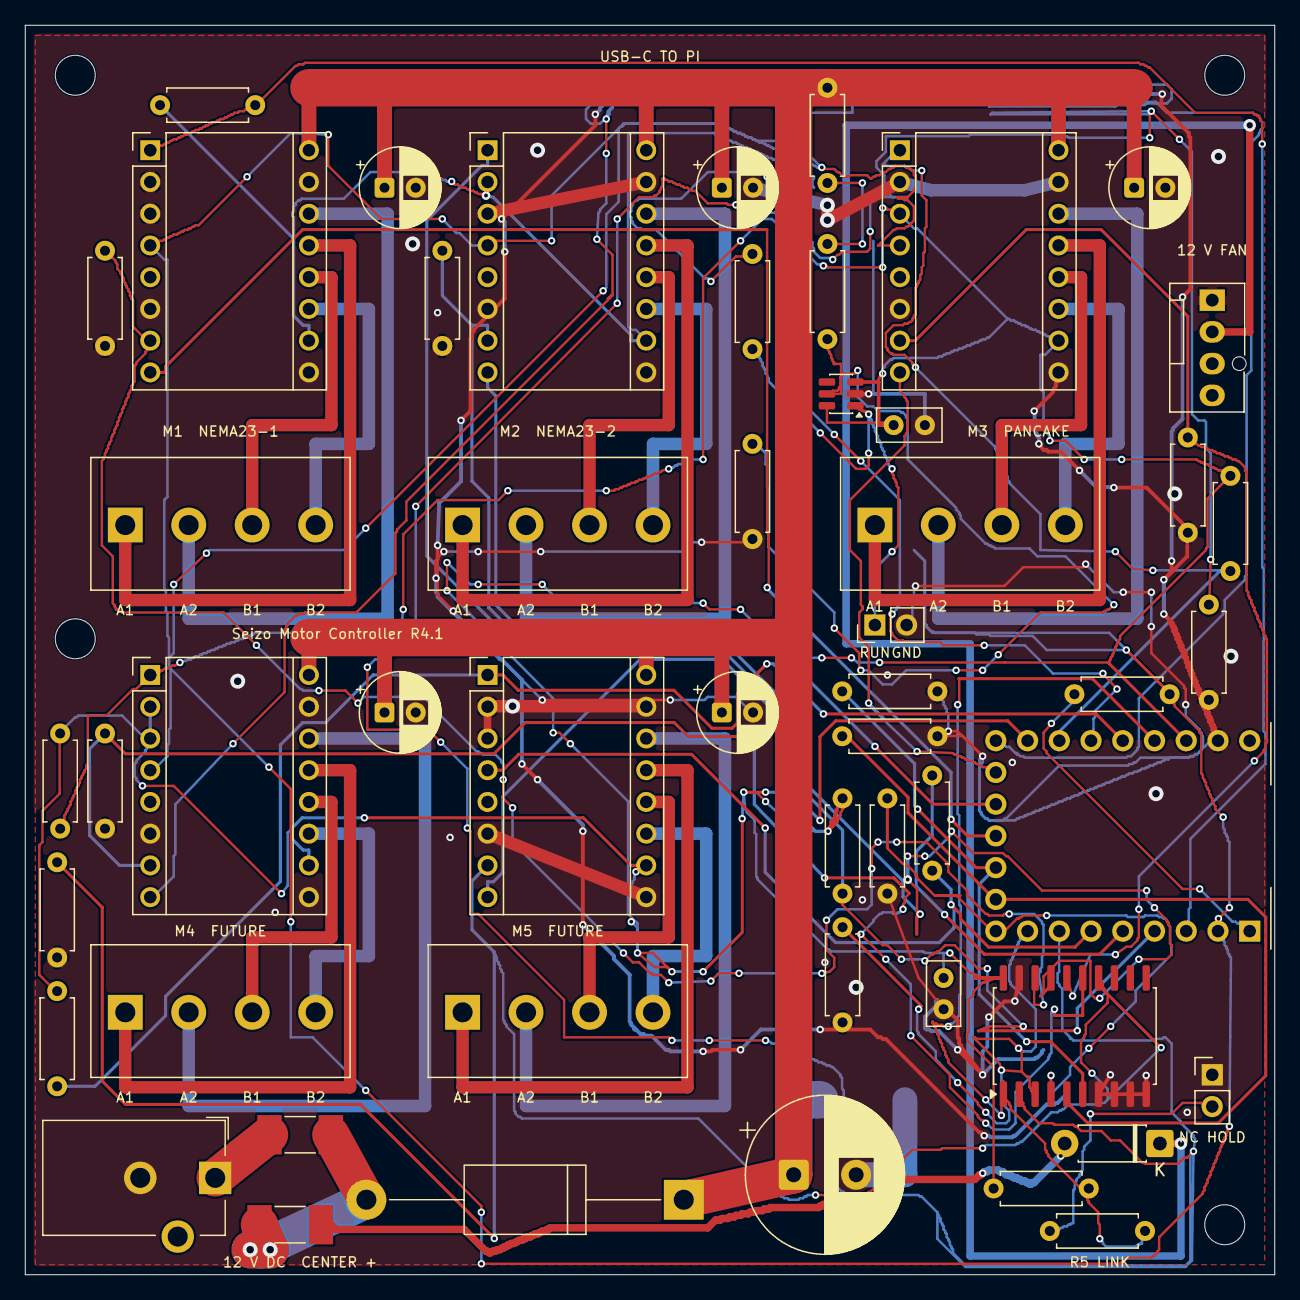
[picture p23: board big motor controller.kicad_pcb from above]

Board: 2 copper layers, 100.0 x 100.0 mm, 57 parts (1 on the bottom side), 56 nets.

Other parts of the board:
H1, H2, H3, H4: M3 mounting; MountingHole_3.2mm_M3
