gmaxdragon/Seizo-Mini/hardware/seizomini.kicad_pcb

## KiCad design legacy/teaching-mini-r5/hardware/seizomini.kicad_pcb (2026-11-05, an earlier design)

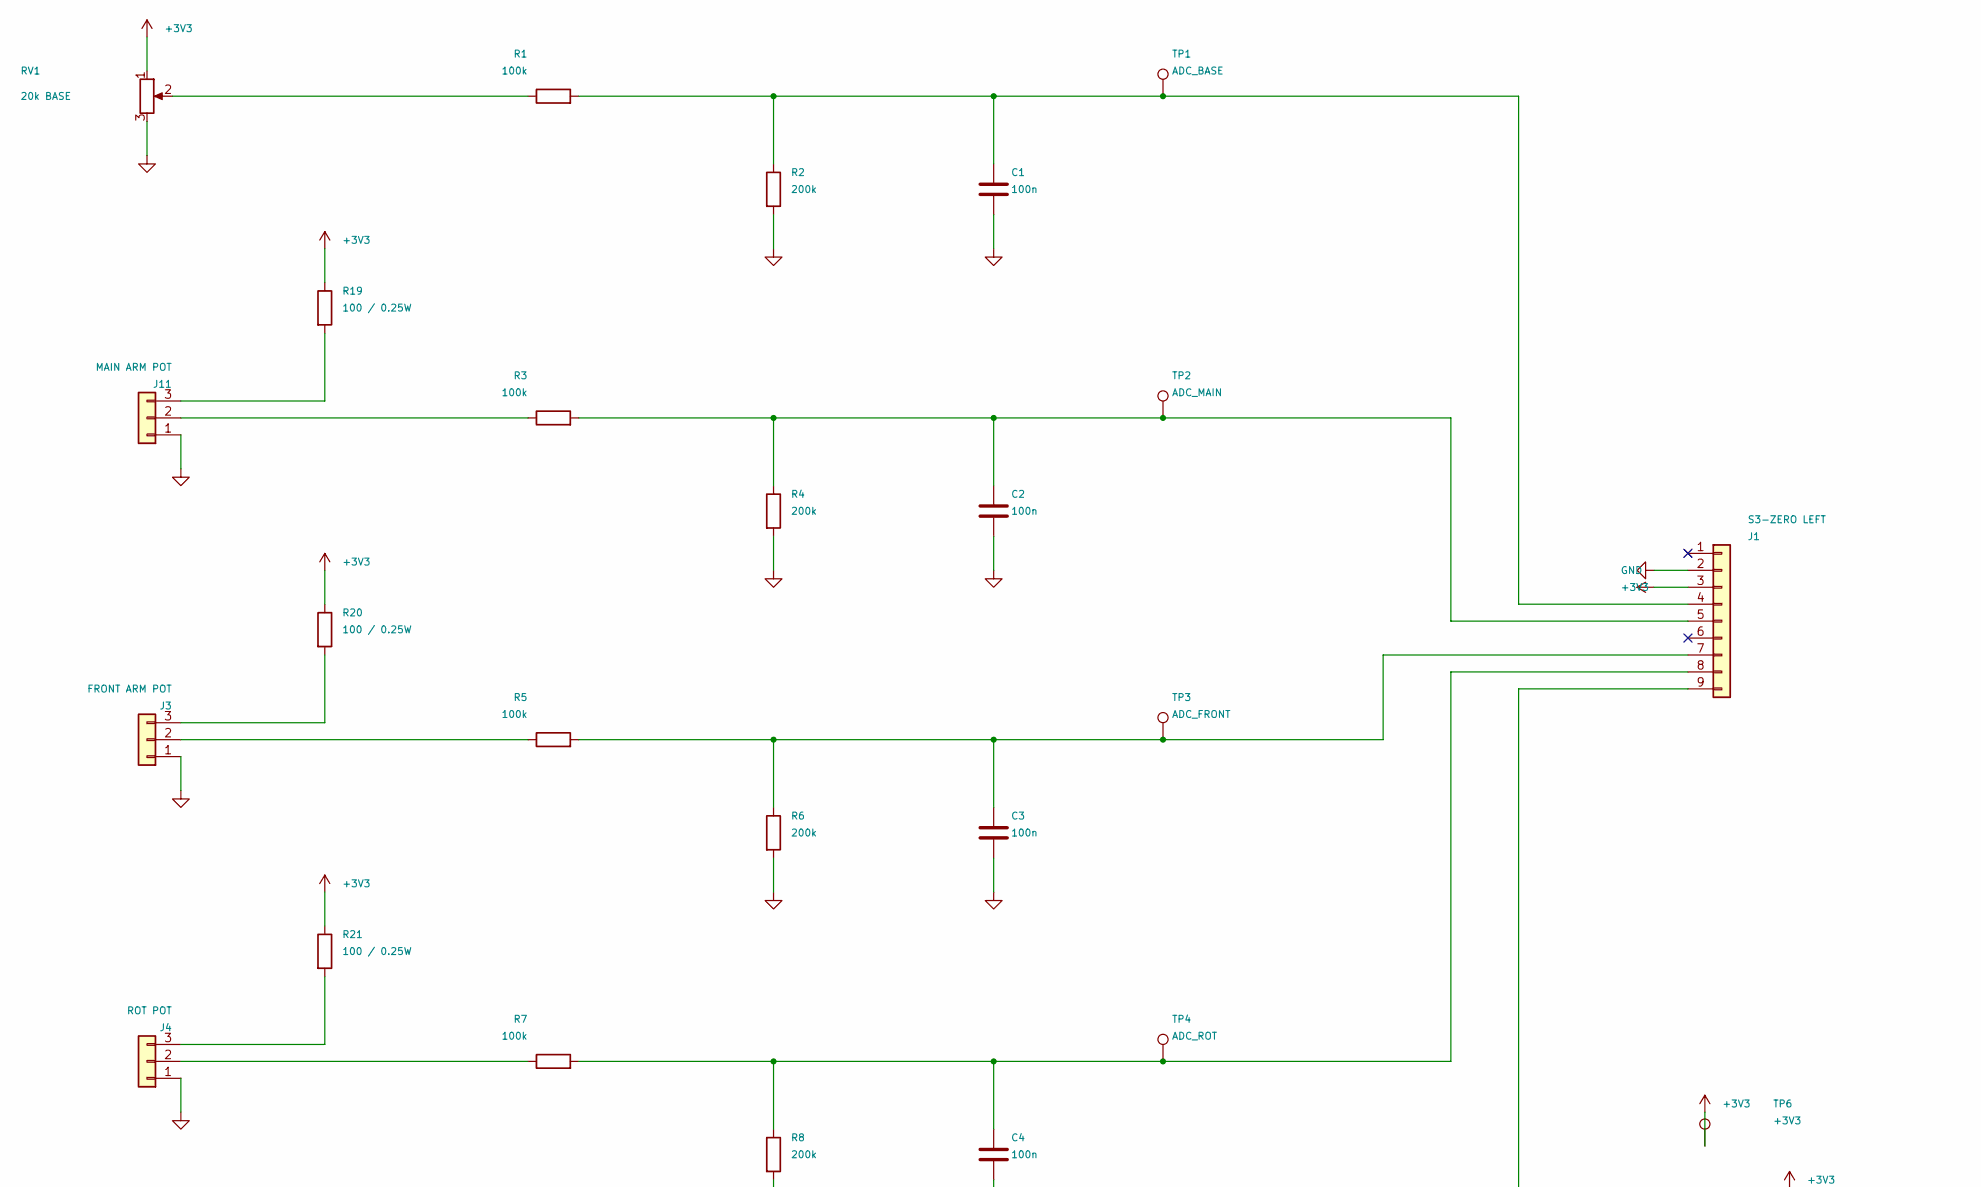
[picture p24: schematic seizomini.kicad_sch, Seizo Mini - main teaching controller, part in row 1, column 1]

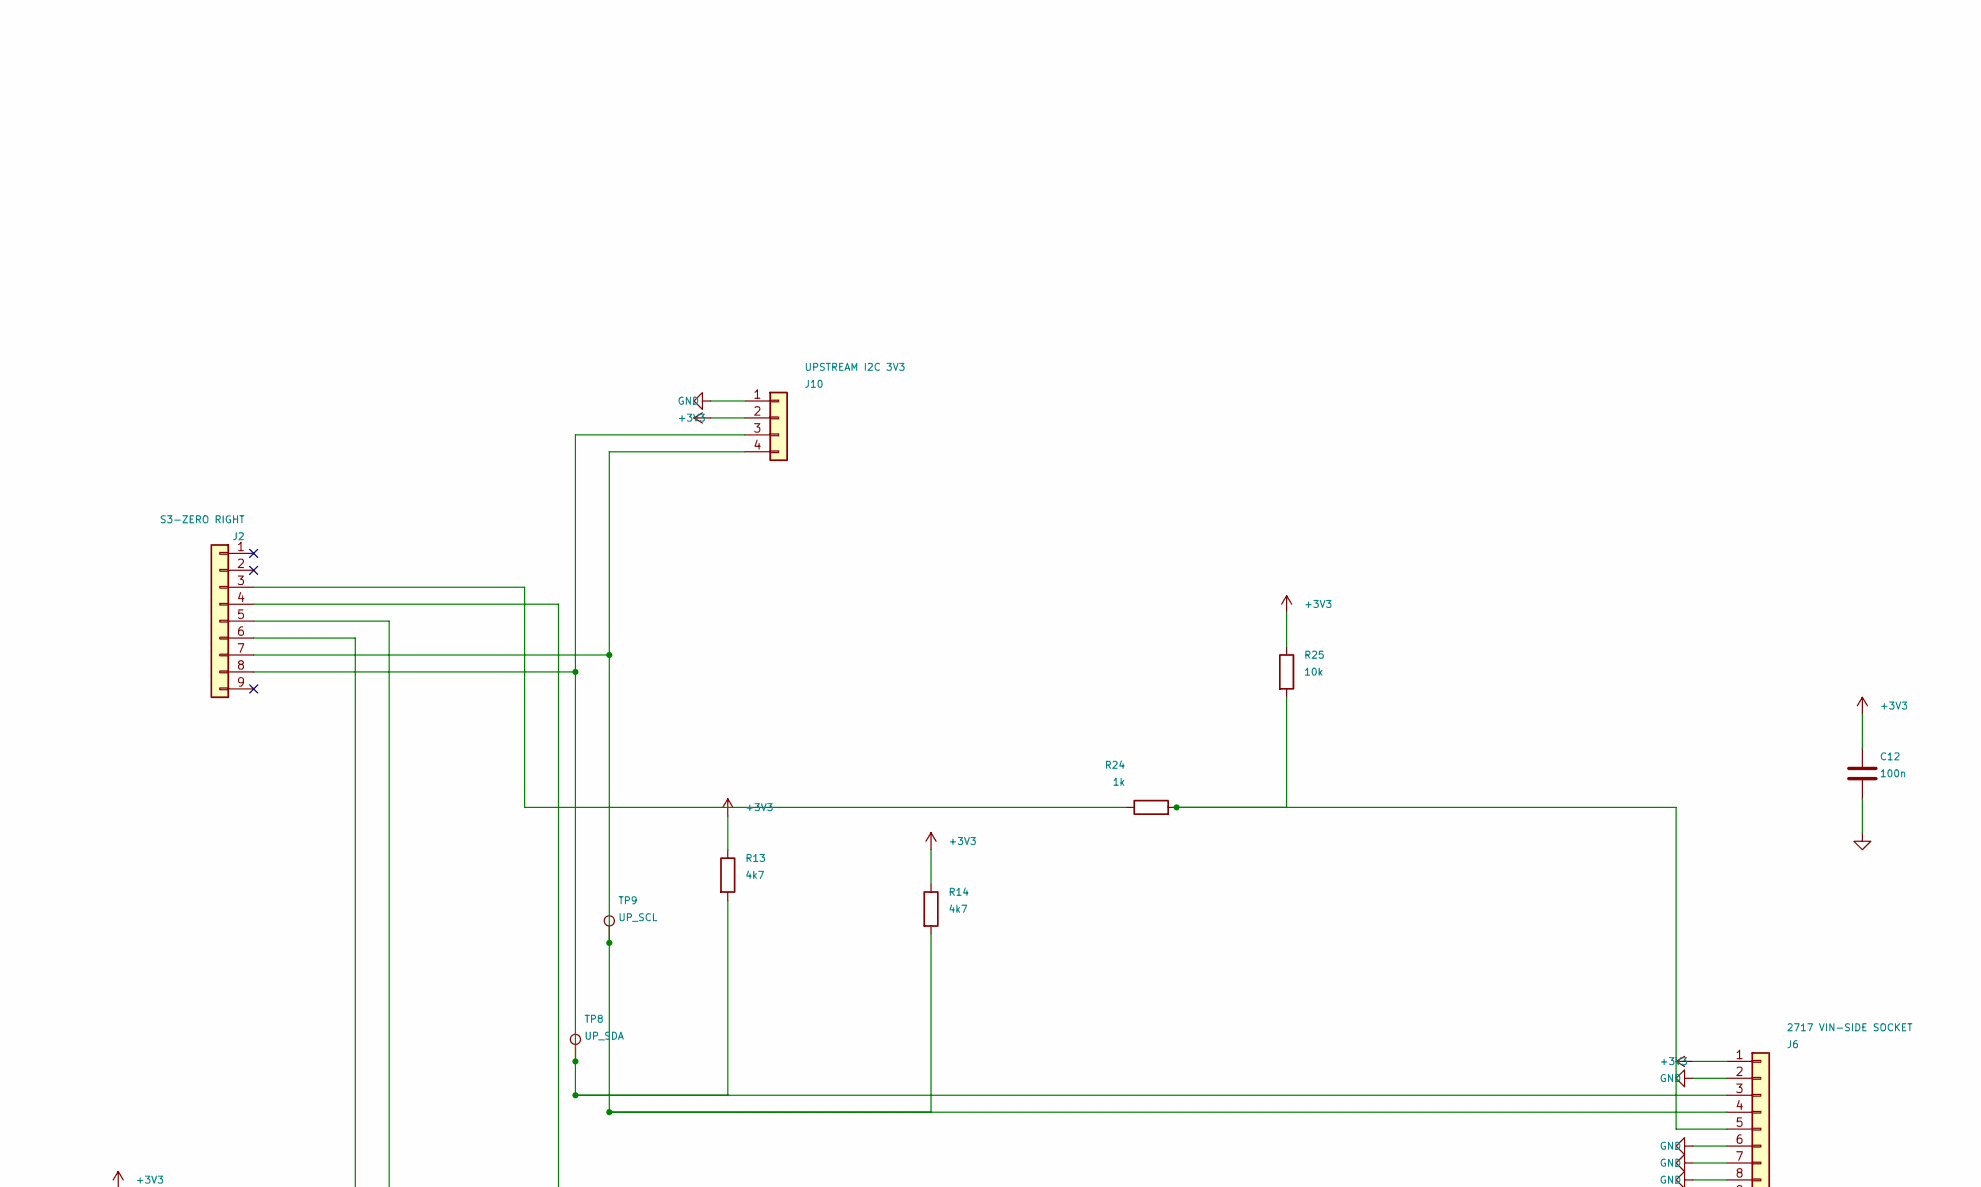
[picture p25: schematic seizomini.kicad_sch, Seizo Mini - main teaching controller, part in row 1, column 2]

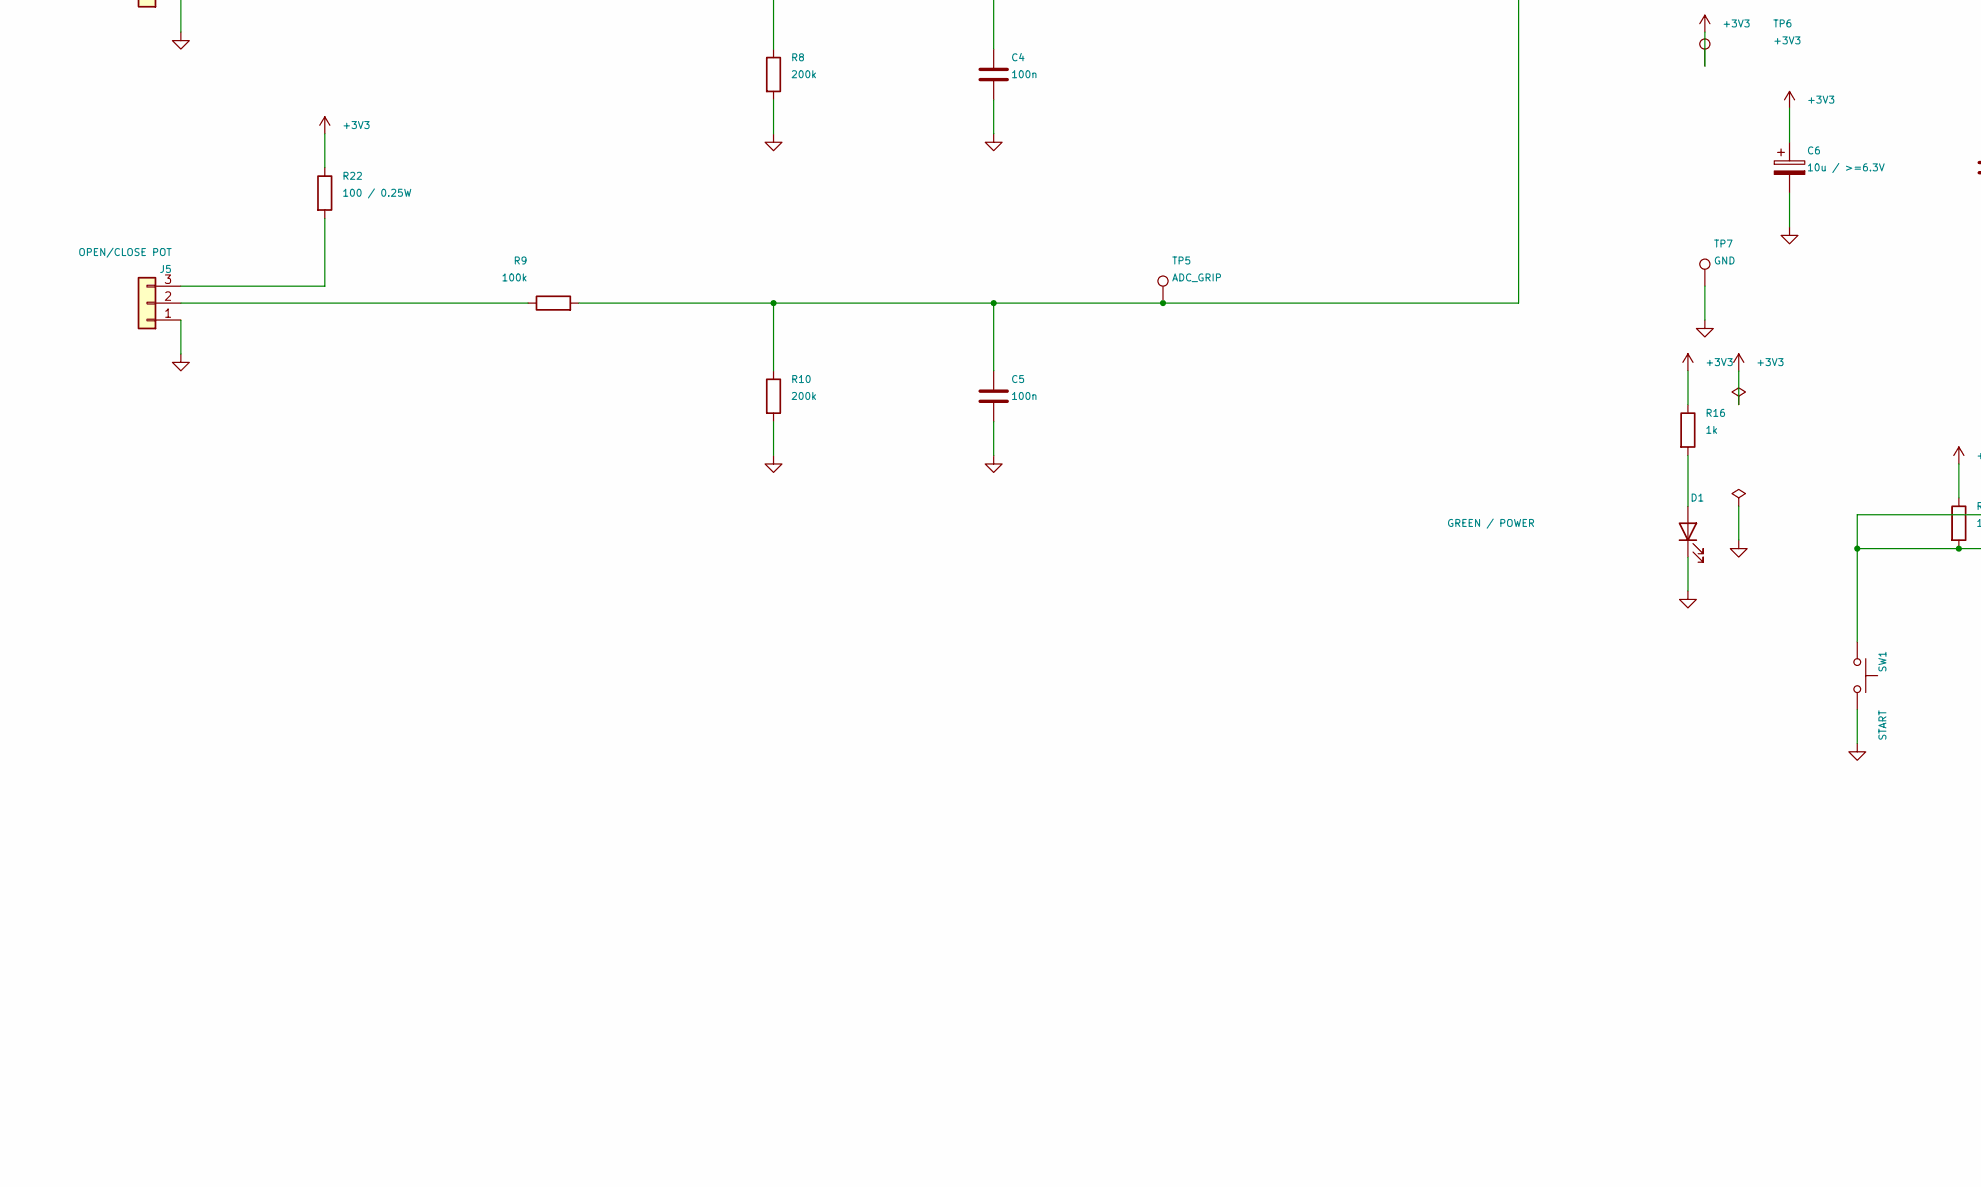
[picture p26: schematic seizomini.kicad_sch, Seizo Mini - main teaching controller, part in row 2, column 1]

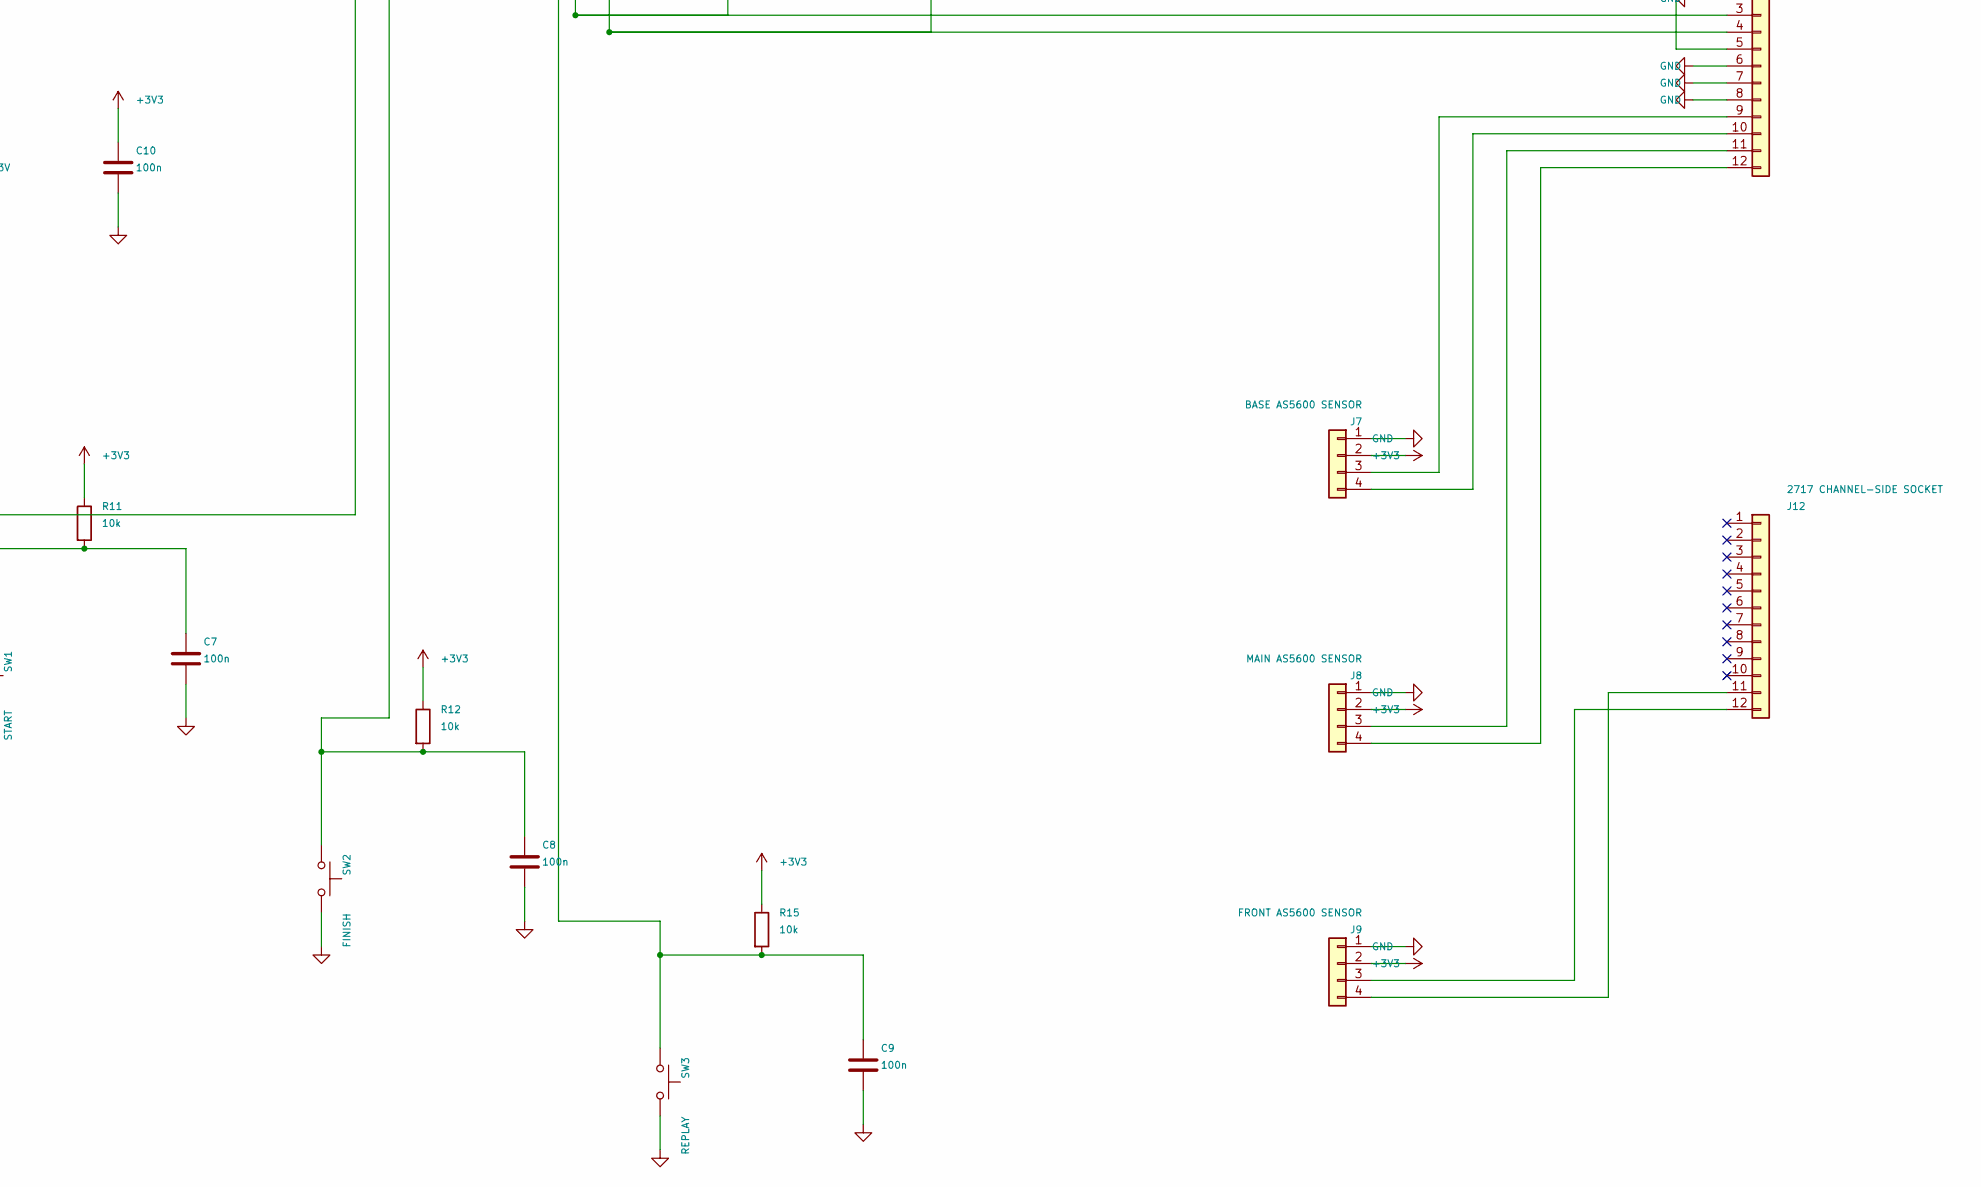
[picture p27: schematic seizomini.kicad_sch, Seizo Mini - main teaching controller, part in row 2, column 2]

Parts:
C1, C2, C3, C4, C5, C7, C8, C9, C10, C12: 100n; C_Rect_L4.0mm_W2.5mm_P2.50mm
C6: 10u / >=6.3V; CP_Radial_D5.0mm_P2.00mm
D1: GREEN / POWER; LED_D3.0mm
J1: S3-ZERO LEFT; PinSocket_1x09_P2.54mm_Vertical
J2: S3-ZERO RIGHT; PinSocket_1x09_P2.54mm_Vertical
J3: FRONT ARM POT; PinHeader_1x03_P2.54mm_Vertical
J4: ROT POT; PinHeader_1x03_P2.54mm_Vertical
J5: OPEN/CLOSE POT; PinHeader_1x03_P2.54mm_Vertical
J6: 2717 VIN-SIDE SOCKET; PinSocket_1x12_P2.54mm_Vertical
J7: BASE AS5600 SENSOR; PinHeader_1x04_P2.54mm_Vertical
J8: MAIN AS5600 SENSOR; PinHeader_1x04_P2.54mm_Vertical
J9: FRONT AS5600 SENSOR; PinHeader_1x04_P2.54mm_Vertical
J10: UPSTREAM I2C 3V3; PinHeader_1x04_P2.54mm_Vertical
J11: MAIN ARM POT; PinHeader_1x03_P2.54mm_Vertical
J12: 2717 CHANNEL-SIDE SOCKET; PinSocket_1x12_P2.54mm_Vertical
R1, R3, R5, R7, R9: 100k; R_Axial_DIN0207_L6.3mm_D2.5mm_P7.62mm_Horizontal
R2, R4, R6, R8, R10: 200k; R_Axial_DIN0207_L6.3mm_D2.5mm_P7.62mm_Horizontal
R11, R12, R15, R25: 10k; R_Axial_DIN0207_L6.3mm_D2.5mm_P7.62mm_Horizontal
R13, R14: 4k7; R_Axial_DIN0207_L6.3mm_D2.5mm_P7.62mm_Horizontal
R16, R24: 1k; R_Axial_DIN0207_L6.3mm_D2.5mm_P7.62mm_Horizontal
R19, R20, R21, R22: 100 / 0.25W; R_Axial_DIN0207_L6.3mm_D2.5mm_P7.62mm_Horizontal
RV1: 20k BASE; Potentiometer_Bourns_PTV09A-1_Single_Vertical; MPN PTV09A-1020F-B203
SW1: START; SW_TH_Tactile_Omron_B3F-100x
SW2: FINISH; SW_TH_Tactile_Omron_B3F-100x
SW3: REPLAY; SW_TH_Tactile_Omron_B3F-100x
TP1: ADC_BASE; TestPoint_THTPad_D1.5mm_Drill0.7mm
TP2: ADC_MAIN; TestPoint_THTPad_D1.5mm_Drill0.7mm
TP3: ADC_FRONT; TestPoint_THTPad_D1.5mm_Drill0.7mm
TP4: ADC_ROT; TestPoint_THTPad_D1.5mm_Drill0.7mm
TP5: ADC_GRIP; TestPoint_THTPad_D1.5mm_Drill0.7mm
TP6: +3V3; TestPoint_THTPad_D1.5mm_Drill0.7mm
TP7: GND; TestPoint_THTPad_D1.5mm_Drill0.7mm
TP8: UP_SDA; TestPoint_THTPad_D1.5mm_Drill0.7mm
TP9: UP_SCL; TestPoint_THTPad_D1.5mm_Drill0.7mm

Connections:
+3V3: C6.1, C10.1, C12.1, J1.3, J6.1, J7.2, J8.2, J9.2, J10.2, R11.1, R12.1, R13.1, R14.1, R15.1, R16.1, R19.1, R20.1, R21.1, R22.1, R25.1, RV1.1, TP6.1
GND: C1.2, C2.2, C3.2, C4.2, C5.2, C6.2, C7.2, C8.2, C9.2, C10.2, C12.2, D1.1 (K), J1.2, J3.1, J4.1, J5.1, J6.2, J6.6, J6.7, J6.8, J7.1, J8.1, J9.1, J10.1, J11.1, R2.2, R4.2, R6.2, R8.2, R10.2, RV1.3, SW1.2, SW2.2, SW3.2, TP7.1
unnamed: D1.2 (A), R16.2
unnamed: C1.1, J1.4, R1.2, R2.1, TP1.1
unnamed: C2.1, J1.5, R3.2, R4.1, TP2.1
unnamed: C3.1, J1.7, R5.2, R6.1, TP3.1
unnamed: C4.1, J1.8, R7.2, R8.1, TP4.1
unnamed: C5.1, J1.9, R9.2, R10.1, TP5.1
unnamed: J2.3, R24.1
unnamed: C9.1, J2.4, R15.2, SW3.1
unnamed: C8.1, J2.5, R12.2, SW2.1
unnamed: C7.1, J2.6, R11.2, SW1.1
unnamed: J3.2, R5.1
unnamed: J3.3, R20.2
unnamed: J4.2, R7.1
unnamed: J4.3, R21.2
unnamed: J5.2, R9.1
unnamed: J5.3, R22.2
unnamed: J6.5, R24.2, R25.2
unnamed: J6.9, J7.3
unnamed: J6.10, J7.4
unnamed: J6.11, J8.3
unnamed: J6.12, J8.4
unnamed: J2.8, J6.3, J10.3, R13.2, TP8.1
unnamed: J2.7, J6.4, J10.4, R14.2, TP9.1
unnamed: J11.2, R3.1
unnamed: J11.3, R19.2
unnamed: J9.4, J12.11
unnamed: J9.3, J12.12
unnamed: R1.1, RV1.2

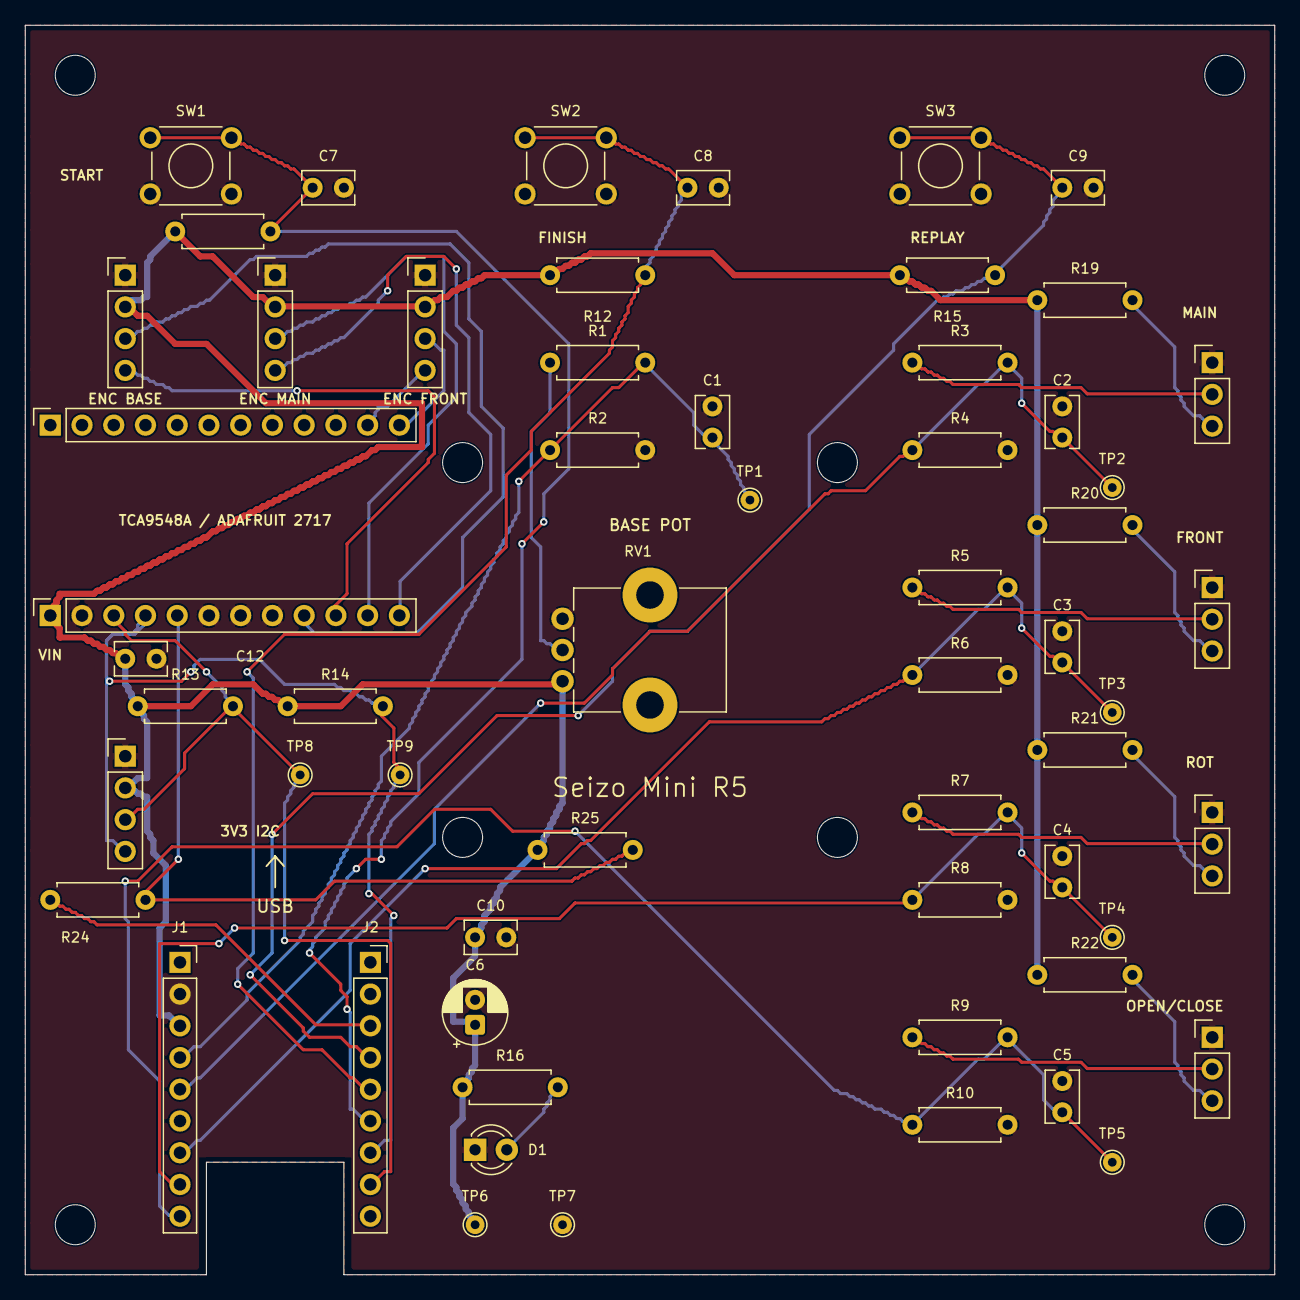
[picture p28: board seizomini.kicad_pcb from above]

Board: 2 copper layers, 100.0 x 100.0 mm, 67 parts (0 on the bottom side), 30 nets.

Other parts of the board:
H1, H2, H3, H4, H5, H6, H7, H8: M3; MountingHole_3.2mm_M3
