gmaxdragon/Seizo-Mini/(commit log)

2026-11-05 Add verified Mini R5 PCB sources, matching fabrication files and purchasing BOMs
    [BOARD-BOM.csv, BOM.csv, COMPLETE-BOM.csv, DigiKey_Import.csv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]
2026-11-08 Publish Motor Controller R4 prototype sources, checked BOM and assembly quote; archive teaching Mini R5
    [BOARD-BOM.csv, BOM.csv, COMPLETE-BOM.csv, DigiKey_Import.csv, Final_BOM.csv, JLC_R4_FULL_CARRIER_QUOTE_BOM.csv, JLC_R4_TOP4_SMT_QUOTE_BOM.csv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]
2026-11-08 Sync Seizo Mini from Half Life
    [BOM.csv]
2026-11-08 Prepare R4.1 three-driver prototype with corrected assembly placements
    [BOM.csv, Final_BOM.csv, JLC_R41_TOP2_NATIVE_POSITION_AUDIT.csv, JLC_R41_TOP2_QUOTE_BOM.csv, LCSC_import_spares_plan.csv, QUOTE_TOTALS.csv, R41-pad-map.csv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]
2026-11-08 Complete R4.1 manual build package, consolidated BOM and tested USB host
    [BOM.csv, Budget.csv, Final_BOM.csv, LCSC_import.csv, LCSC_import_spares_plan.csv, QUOTE_TOTALS.csv, R41-purchase-BOM.csv, Solder_List.csv]
2026-11-08 Use supplied board screenshots in README
2026-11-09 Update user README, restore priced motor BOM and document power/fallback limits
    [BOM.csv, Budget.csv, Final_BOM.csv, HalfLife_import.csv, LCSC_import.csv, LCSC_import_spares_plan.csv, QUOTE_TOTALS.csv, R41-purchase-BOM.csv]
2026-11-09 Fix all purchase prices and add $18 socketed fallback board
    [BOM.csv]
2026-11-09 Align funding importer with explicit priced BOM
    [HalfLife_import.csv]
2026-11-09 Document same-driver preassembled fallback and remaining budget
2026-11-09 Remove separate thermal-tape purchase as requested
    [BOM.csv]
2026-11-09 Restore priced purchases after app sync overwrote them with zeros
    [BOM.csv]
2026-11-09 Keep a separate priced import file protected from root BOM sync overwrites
    [ORDER_BOM.csv]
